tsandmann/ct-bot-hw/v2/boards/README.md

# ct-Bot v2 prototype boards

These boards (mainboard, teensy mcu board, and sensor boards) are ***prototypes*** just for ***development and testing***. They are provided "as is" without warranty of any kind.

## Known issues and notes

Please note: these problem lists may be highly incomplete, as not all functions have been tested yet!

### [Mainboard](../schematics/mainboard_0.9.2.pdf)

* Positioning of J2 is inappropriate
* TBC
