tsandmann/ct-bot-hw/v2/cad/README.md

# c't-Bot CAD-Files

Die Chassis Teile des c't-Bots können auf einem 3D-Drucker gedruckt werden.

Benötigt werden dazu die Dateien aus dem CAD Ordner, sie wurden mit [OpenSCAD](https://www.openscad.org) erstellt.

Dieses Repository enthält die Modelle mit kleineren Anpassungen für den c't-Bot v2. Die Modelle für den originalen c't-Bot (v1) sind [hier](https://github.com/robotfreak/ct-bot/tree/master/CAD) verfügbar.

## OpenSCAD Module c't-Bot v2

* `base()`: untere Trägerplatte
* `motormount()`: Motorhalterung
* `pole()`: Pfosten
* `wheel()`: Räder
* `enc()`: Encoderscheiben für Räder
* `ctbot()`: Komplettansicht, nur zur Darstellung

### Druckeinstellungen

* 0.2 mm Schichthöhe
* 100 % Infill

## Weitere benötigte Bauteile

* 2 x O-Ringe 5mm, 46mm Innendurchmesser, 56mm Außendurchmesser
* 1 x Stützrad
* 2 x Original Motoren Faulhaber

Die CAD Dateien unterliegen der [CC BY-SA Lizenz](https://creativecommons.org/licenses/by-sa/4.0/deed.de).

License: CC BY-SA 4.0 (https://creativecommons.org/licenses/by-sa/4.0/)
