tsandmann/ct-bot-hw/v2/adapter_boards/motor_driver_adapter.pdf

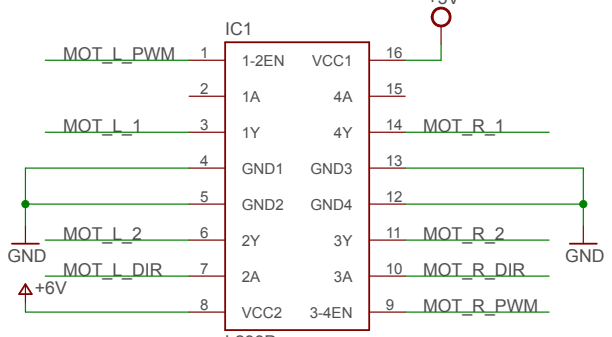
[picture p1: figure]
GND; GND1 4; GND2 5; VCC2 8; VCC1; GND3; GND4; MOT_R_DIR; MOT_L_DIR; MOT_L_PWM; MOT_R_PWM; MOT_L_1; MOT_L_2; MOT_R_1; MOT_R_2

### DRV8835

+5V

### GND

+6V

### GND

L293D

+5V

LGND LGND
VCC VCC
BENBL BENBL
BPHASE BPHASE
AENBL AENBL
APHASE APHASE
MODE MODE | VMM | VMM AOUT1 | AOUT1 AOUT2 | AOUT2 BOUT1 | BOUT1 BOUT2 | BOUT2 VIN | VIN MGND | MGND

IC2

### MOT_R_DIR

### MOT_L_DIR

### MOT_L_PWM

### MOT_R_PWM

### MOT_L_1

### MOT_L_2

### MOT_R_1

### MOT_R_2
