tsandmann/ct-bot-hw/v2/infos/teensy/teensy_4.1_pin_mapping_0.9.2.pdf

## ct-Bot Teensy 4.1 Pin Mapping

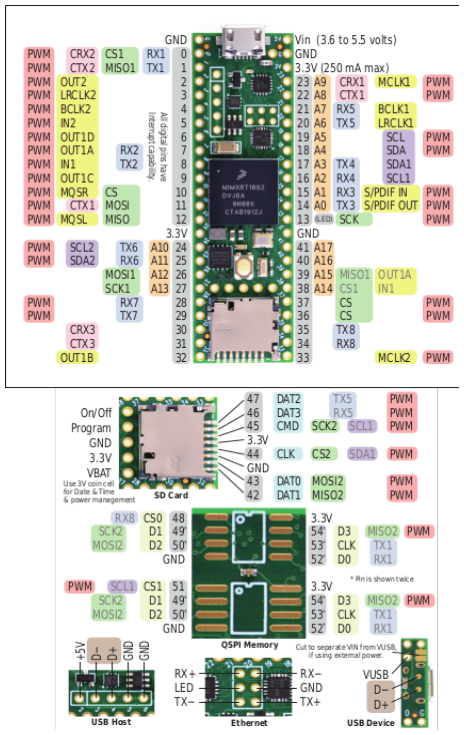
[picture p2: figure]

Pin | | Funktion Teensy 4.1 | Verwendung Teensy 4.1 | neu | optional | Pad Name
0 1 | UART/SPI/PWM UART/SPI/PWM | RX1/CS1/PWM (F: 1.1) TX1/MISO1/PWM (F: 1.0) | SPI 2 Slave CS 1 oder UART 3 SPI 2 Slave MOSI (SIN) oder UART 3 | x x | x x | GPIO_AD_B0_03 GPIO_AD_B0_02
2 3 4 | I2S/PWM I2S/PWM I2S/PWM | OUT2/PWM (F: 4.2) LRCLK2/PWM (F: 4.2) BCLK2/PWM (F: 2.0) | I2S Out I2S LRCLK I2S BCLK | x x x | x x x | GPIO_EMC_04 GPIO_EMC_05 GPIO_EMC_06
5 6 | PWM I2S/PWM | PWM (F: 2.1) OUT1D/PWM (F: 2.2) | Servo 1 PWM Servo 2 PWM | x | x x | GPIO_EMC_08 GPIO_B0_10
7 8 | UART/I2S/PWM UART/PWM | RX2/OUT1A/PWM (F: 1.3) TX2/PWM (F: 1.3) | Uart 2 (Motor-Ctrl) RX Uart 2 (Motor-Ctrl) TX | x x | | GPIO_B1_01 GPIO_B1_00
9 | I2S/PWM | OUT1C/PWM (F: 2.2) | Debug LED | x | | GPIO_B0_11
10 11 12 13 | SPI/PWM SPI/PWM SPI/PWM SPI/PWM | CS0/PWM (Q: 1.0) MOSI(SOUT)0/PWM (Q: 1.2) MISO(SIN)0/PWM (Q: 1.1) SCK0/PWM (Q: 2.0) | SPI 1 Master CS 1 SPI 1 Master MOSI SPI 1 Master MISO SPI 1 Master SCK | x x x x | x x x x | GPIO_B0_00 GPIO_B0_02 GPIO_B0_01 GPIO_B0_03
14 15 | ADC/UART/PWM ADC/UART/PWM | A0/TX3/PWM (Q: 3.2) A1/RX3/PWM (Q: 3.3) | Strommessung 5V Strommessung Servos | x x | | GPIO_AD_B1_02 GPIO_AD_B1_03
16 17 | ADC/UART/I2C ADC/UART/I2C | A2/RX4/SCL1 A3/TX4/SDA1 | I2C 2 (IMU) I2C 2 (IMU) | x x | x x | GPIO_AD_B1_07 GPIO_AD_B1_06
18 19 | ADC/I2C/PWM ADC/I2C/PWM | A4/SDA0/PWM (Q: 3.1) A5/SCL0/PWM (Q: 3.0) | I2C 1 (5V: LEDs, ENA, CNY70, Sens) I2C 1 (5V: LEDs, ENA, CNY70, Sens) | x x | | GPIO_AD_B1_01 GPIO_AD_B1_00
20 21 22 23 | ADC/UART/I2S ADC/UART/I2S ADC/PWM ADC/I2S/PWM | A6/TX5/LRCLK1 A7/RX5/BCLK1 A8/PWM (F: 4.0) A9/MCLK1/PWM (F: 4.1) | Überwachung Batterie Servo 1 Feedback Servo 2 Feedback Servo 3 Feedback | x x x x | x x x | GPIO_AD_B1_10 GPIO_AD_B1_11 GPIO_AD_B1_08 GPIO_AD_B1_09
24 25 | ADC/I2C/UART ADC/I2C/UART | A10/TX6/SCL2/PWM (F: 1.2) A11/RX6/SDA2/PWM (F: 1.3) | I2C 3 oder Uart 4 I2C 3 oder Uart 4 | x x | x x | GPIO_AD_B0_12 GPIO_AD_B0_13
26 27 | ADC/SPI ADC/SPI | A12/MOSI(SOUT) A13/SCK1 | SPI 2 Slave MISO (SOUT) SPI 2 Slave SCK | x x | x x | GPIO_AD_B1_14 GPIO_AD_B1_15
28 29 | UART/PWM UART/PWM | RX7/PWM (F: 3.1) TX7/PWM (F: 3.1) | Servo 3 PWM Servo 4 PWM | x x | x x | GPIO_EMC_32 GPIO_EMC_31
30 31 | | GPIO30 GPIO31 | Fernbedienung BPS Sensor | | x | GPIO_EMC_37 GPIO_EMC_36
32 33 | I2S PWM | OUT1B/GPIO32 PWM (F: 2.0) | GPIO_1 GPIO_2 | x x | x x | GPIO_B0_12 GPIO_EMC_07
34 35 | UART UART | RX8 TX8 | Uart 1 (WiFi) RX Uart 1 (WiFi) TX | | | GPIO_B1_13 GPIO_B1_12
36 37 | SPI/PWM SPI/PWM | CS0/PWM (F: 2.3) CS0/PWM (F: 2.3) | SPI 1 Master CS 2 SPI 1 Master CS 3 | x x | x x | GPIO_B1_02 GPIO_B1_03
38 39 40 41 | ADC ADC ADC ADC | A14/CS1 A15/MISO(SIN)1/OUT1A A16 A17 | Kantensensor L Kantensensor R Liniensensor R Liniensensor L | | | GPIO_AD_B1_12 GPIO_AD_B1_13 GPIO_AD_B1_04 GPIO_AD_B1_05
D+ D- | USB USB | USB2_DP USB2_DN | USB Host USB Host | x x | x x
Vb | | VBat | n/a | | | VDD_SNVS_IN
R | | On/Off | On_Off | x | x | ONOFF

Anmerkungen

This work (excluding the teensy images) is licensed under the Creative Commons Attribution-ShareAlike 4.0 International License. To view a copy of this license, visit http://creativecommons.org/licenses/by-sa/4.0

- Distanzsensoren über I2C (z.B. VL53L0X)
- Transportfachüberwachung über I2C (z.B. VL6180X)

Sources: https://www.pjrc.com/store/teensy41_card11a_rev3.png;https://www.pjrc.com/store/teensy41_card11b_rev4.png
