tsandmann/ct-bot-hw/v1/schematics/06_bluemp3_serial_isp.pdf

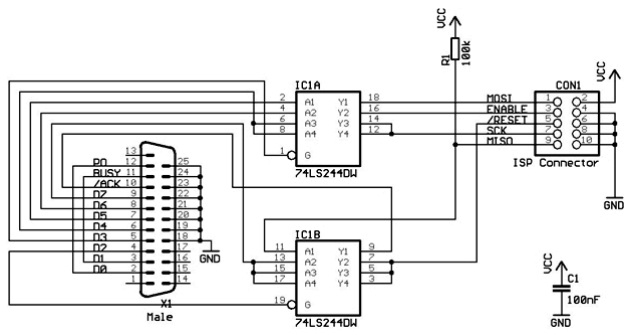
[picture p3: figure]
