tsandmann/ct-bot-hw/v1/pcb-layout/03_pcb_sensorboard_mouse.pdf

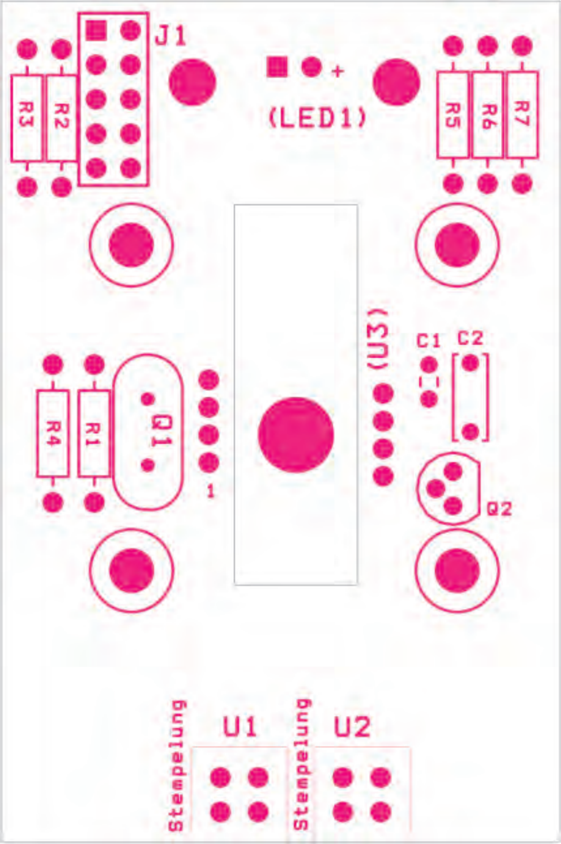
[picture p4: page 1]
