tsandmann/ct-bot-hw/v1/pcb-layout/06_pcb_bluemp3_serial_isp.pdf

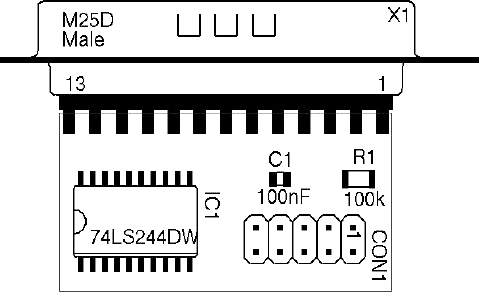
[picture p5: page 1]
