tsandmann/ct-bot-hw/v2/adapter_boards/teensy_adapter_v2/pcb/teensy_adapter_gerber_top.png

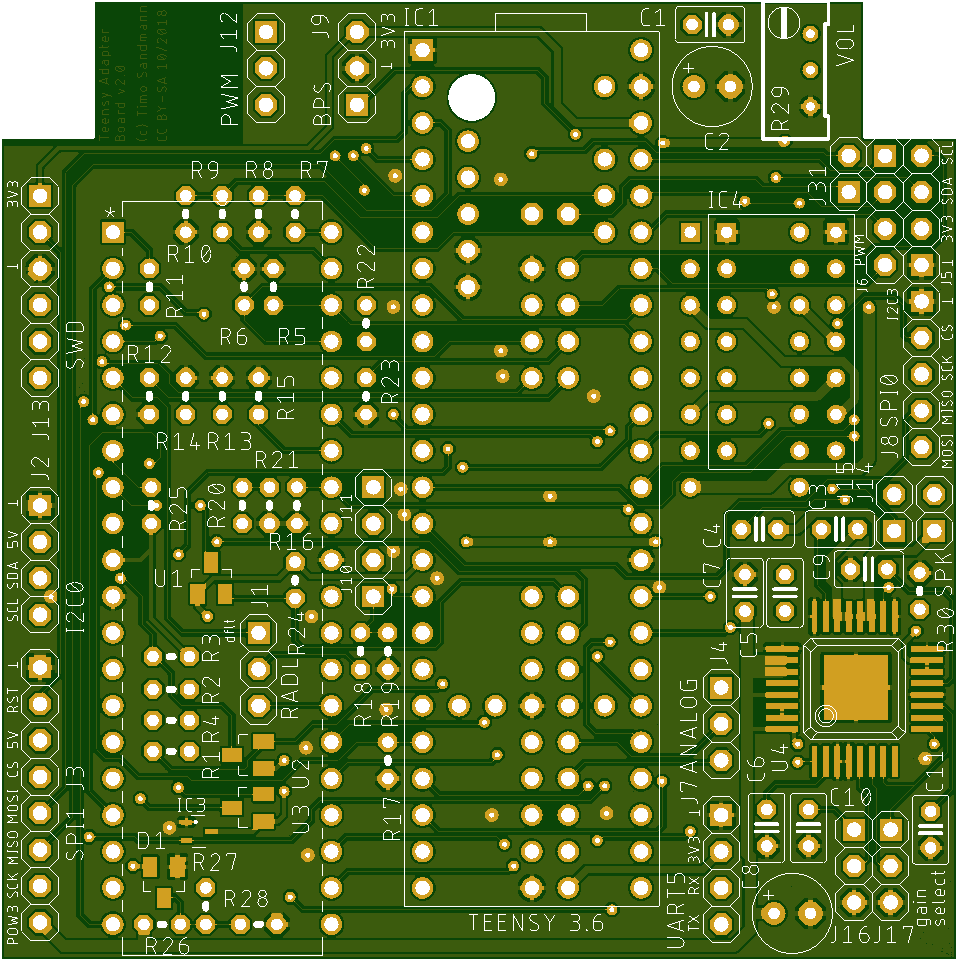
v2/adapter_boards/teensy_adapter_v2/pcb/teensy_adapter_gerber_top.png
