tsandmann/ct-bot-hw/v2/boards/display_adapter_1.3.png

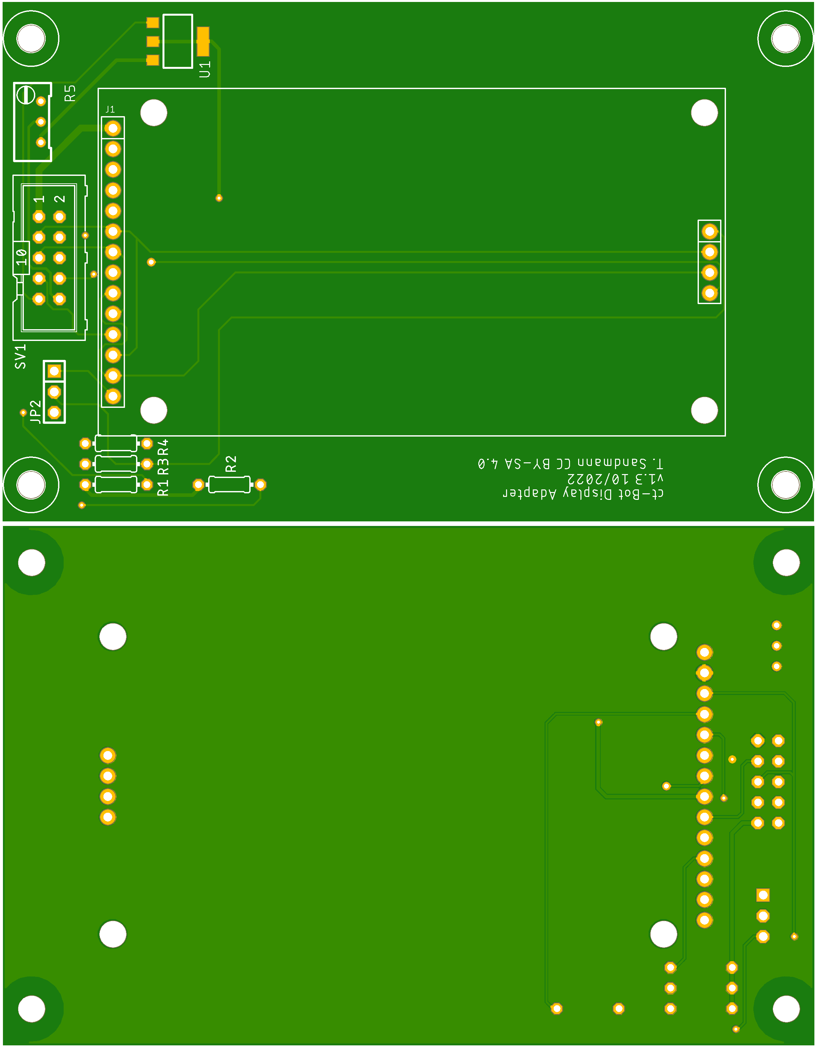
v2/boards/display_adapter_1.3.png
