tsandmann/ct-bot-hw/v2/boards/mainboard_0.9.2.png

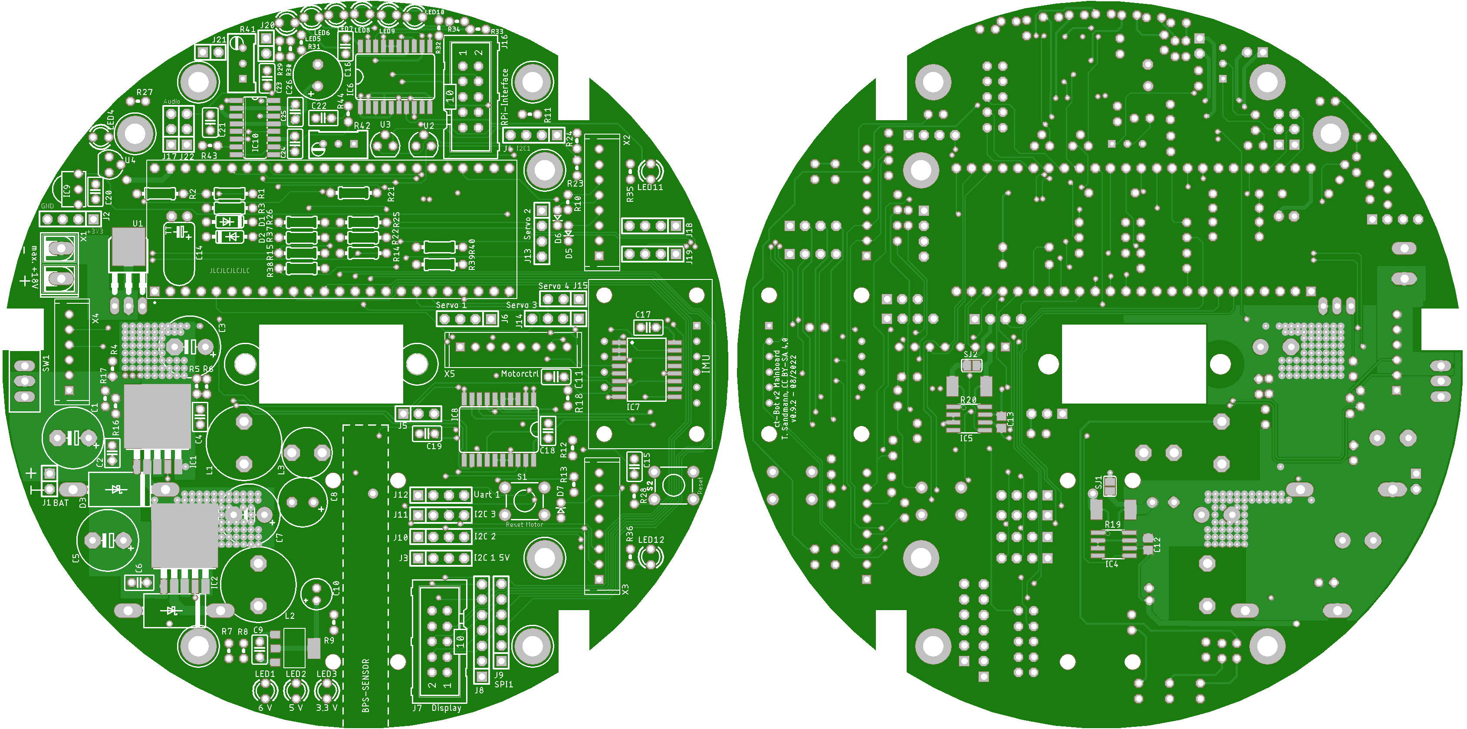
v2/boards/mainboard_0.9.2.png
