tsandmann/ct-bot-hw/v2/boards/mcu_teensy4.1_0.9.2.png

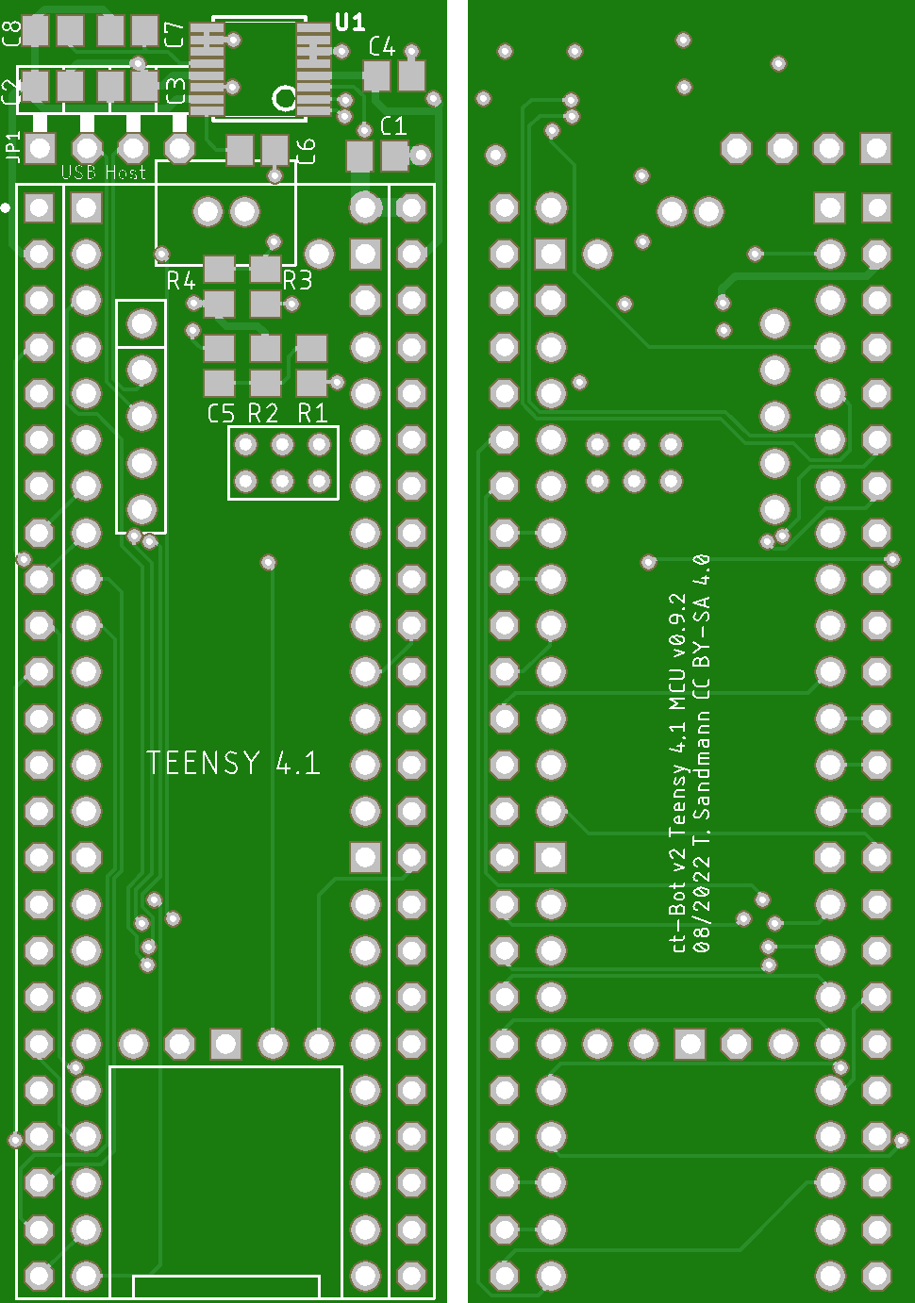
v2/boards/mcu_teensy4.1_0.9.2.png
