tsandmann/ct-bot-hw/v2/boards/motorctrl_0.5.png

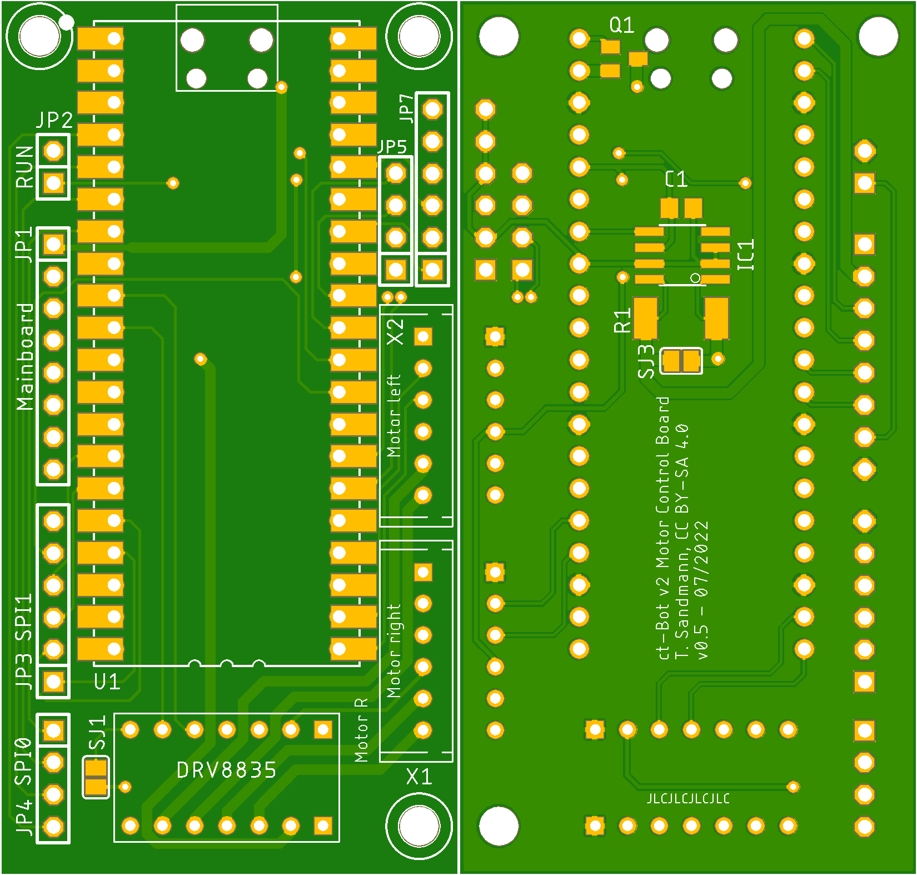
v2/boards/motorctrl_0.5.png
