tsandmann/ct-bot-hw/v2/boards/sensors_b_0.9.2.png

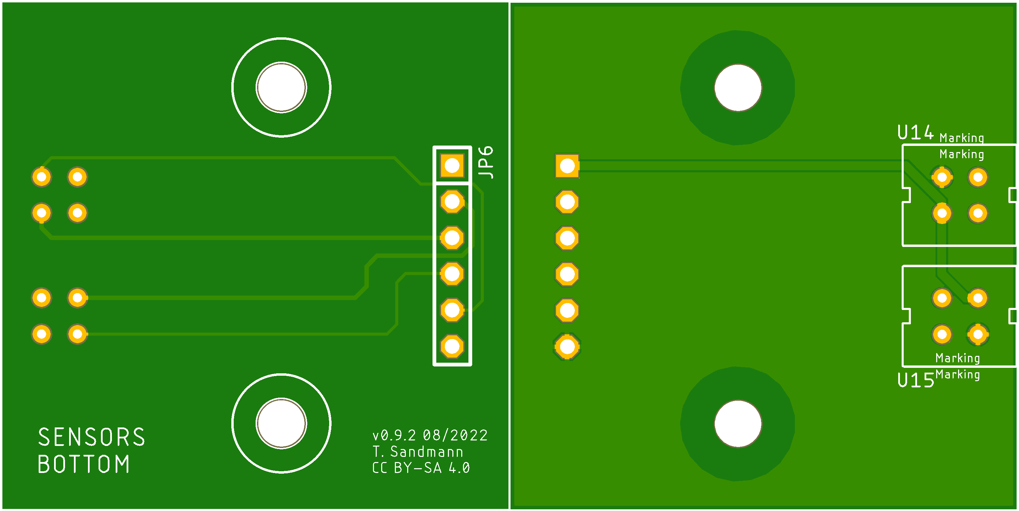
v2/boards/sensors_b_0.9.2.png
