tsandmann/ct-bot-hw/v2/datasheets/pololu_micro_metal_gearmotor_bracket.jpg

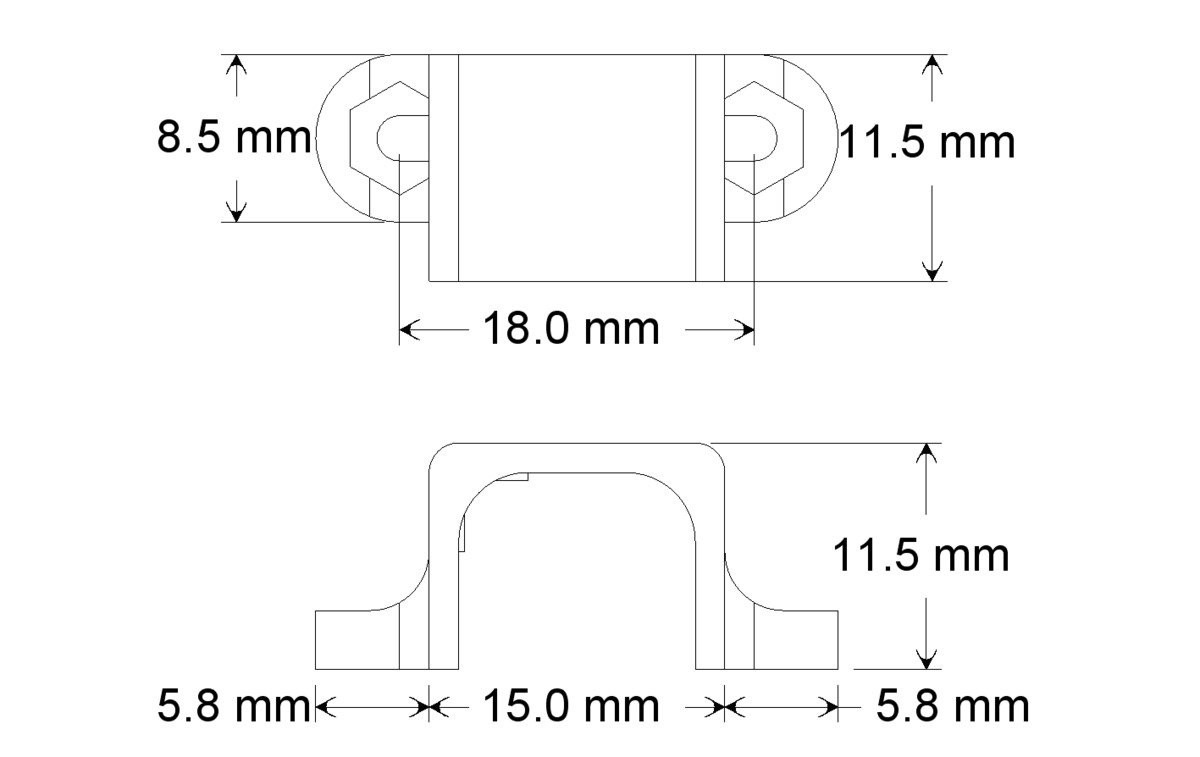
v2/datasheets/pololu_micro_metal_gearmotor_bracket.jpg
