tsandmann/ct-bot-hw/v2/infos/teensy/teensy_3.5_3.6_schematic.jpg

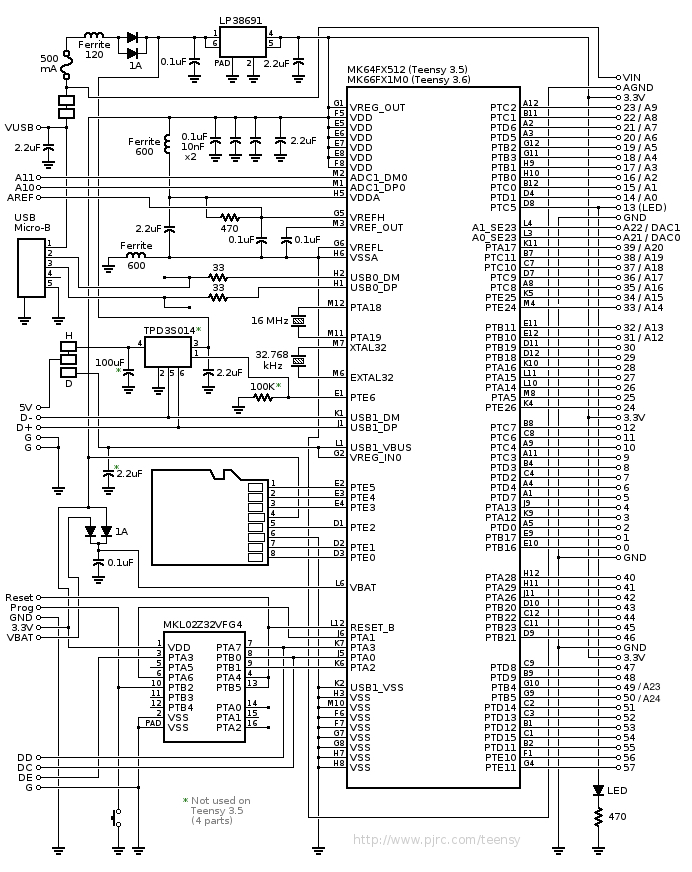
v2/infos/teensy/teensy_3.5_3.6_schematic.jpg
