tsandmann/ct-bot-hw/v2/cad/bms345.stl

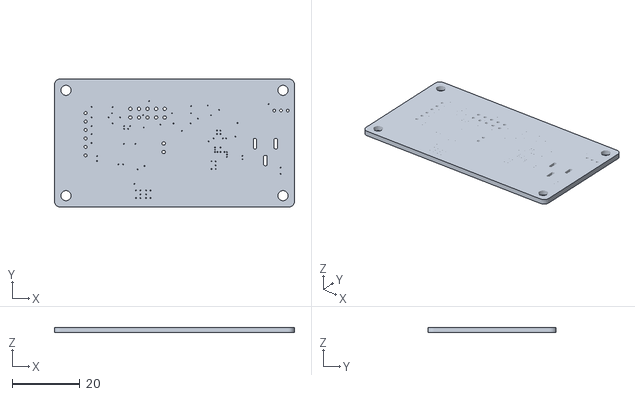
[picture p18: CAD file, 2023-01-01]
v2/cad/bms345.stl
71.0 x 38.0 x 1.60
