tsandmann/ct-bot-hw/v2/cad/ct-bot_v2_wheel.stl

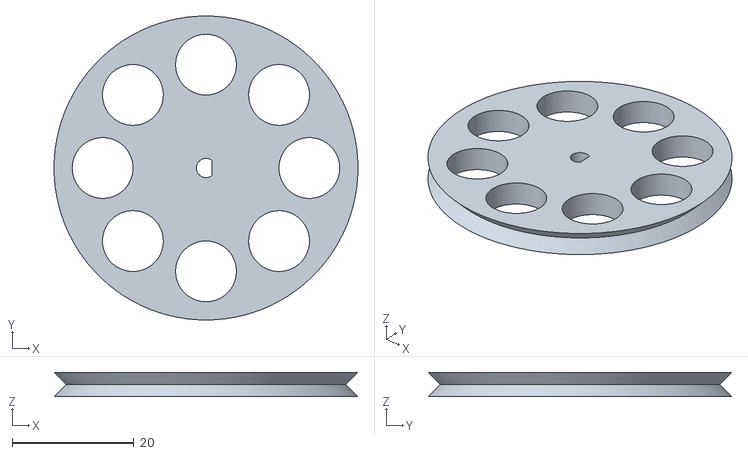
[picture p19: CAD file, 2023-01-01]
v2/cad/ct-bot_v2_wheel.stl
50.0 x 50.0 x 4.00
