tsandmann/ct-bot-hw/v2/cad/motorctrl.stl

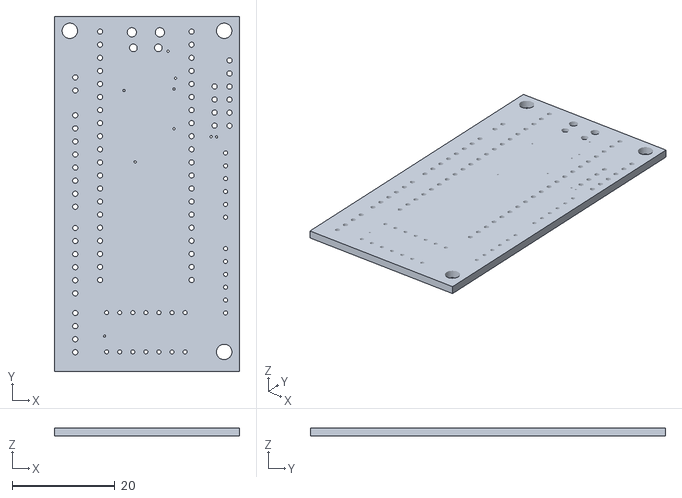
[picture p20: CAD file, 2023-01-01]
v2/cad/motorctrl.stl
36.0 x 69.0 x 1.60
