tsandmann/ct-bot-hw/v2/cad/ct-bot_v2_poles.stl

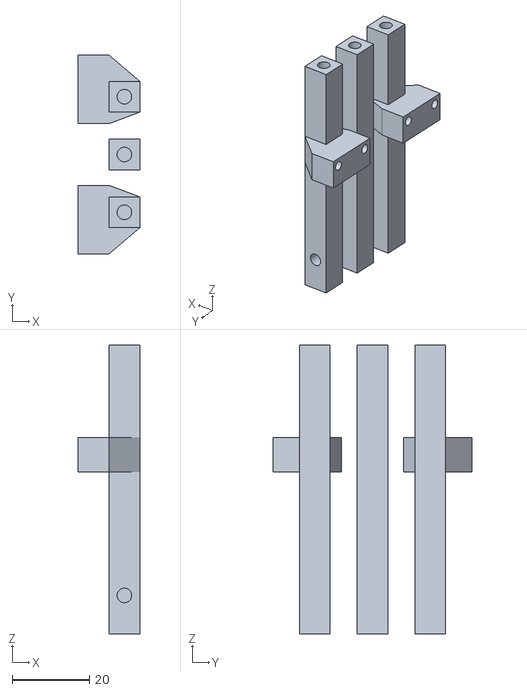
[picture p21: CAD file, 2023-01-01]
v2/cad/ct-bot_v2_poles.stl
16.0 x 51.6 x 75.0
