tsandmann/ct-bot-hw/v2/cad/ct-bot_v2_base.stl

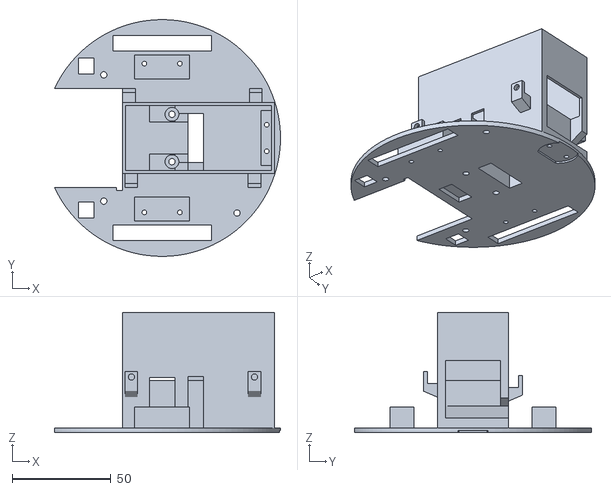
[picture p22: CAD file, 2023-01-01]
v2/cad/ct-bot_v2_base.stl
114.5 x 120.0 x 61.0
