tsandmann/ct-bot-hw/v2/cad/ball-caster.stl

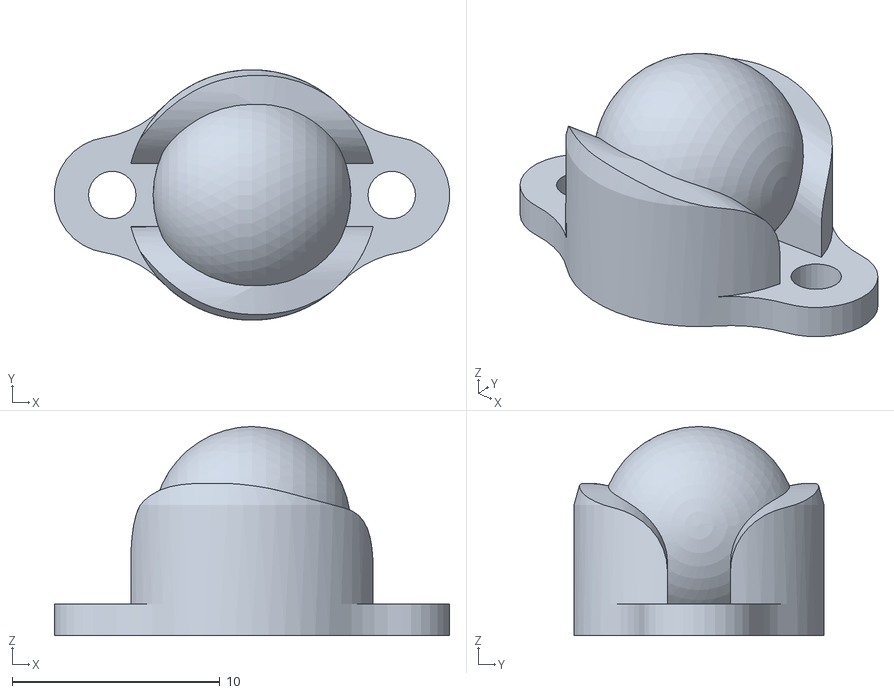
[picture p23: CAD file, 2022-06-25]
v2/cad/ball-caster.stl
19.0 x 12.1 x 10.1
