tsandmann/ct-bot-hw/v2/cad/micro_metal_gearmotor_bracket_fixed.stl

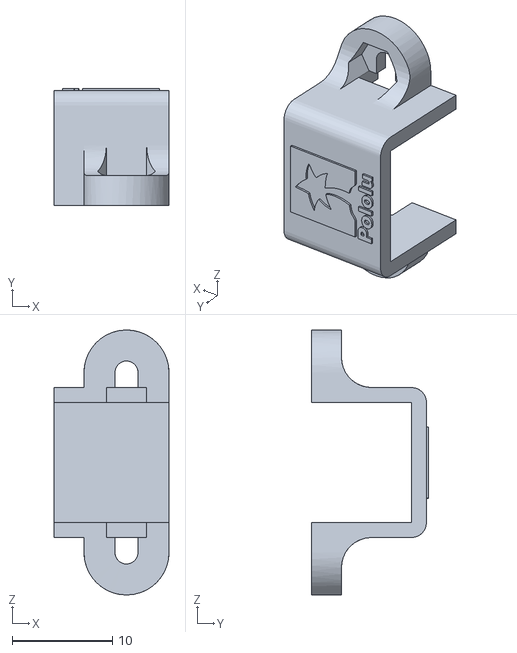
[picture p24: CAD file, 2021-09-04]
v2/cad/micro_metal_gearmotor_bracket_fixed.stl
11.5 x 11.7 x 26.5
