tsandmann/ct-bot-hw/v2/cad/micro-metal-gearmotor-backshaft_fixed.stl

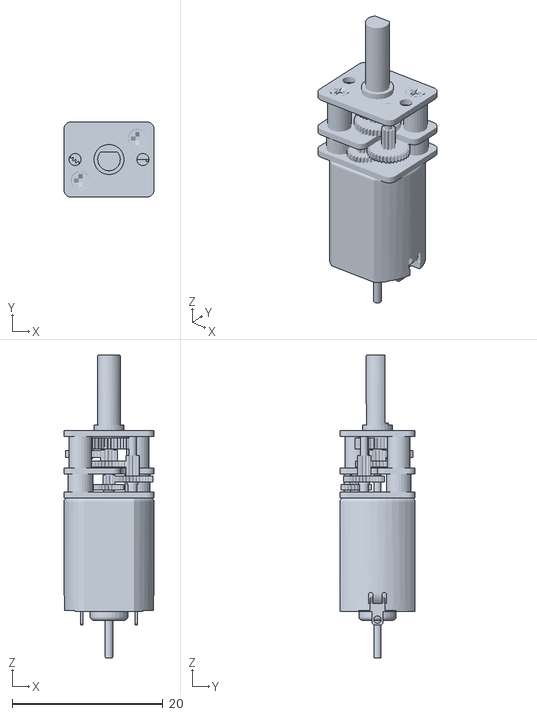
[picture p25: CAD file, 2021-09-04]
v2/cad/micro-metal-gearmotor-backshaft_fixed.stl
12.0 x 10.0 x 40.2
