tsandmann/ct-bot-hw/v2/cad/object.scad

$fn = 500;

difference() {
    cylinder(h = 65, r = 15, center = false);
    translate([0, 0, 1]) cylinder(h = 63, r = 14, center = false);
    // translate([0, 0, 1]) cylinder(h = 65, r = 14, center = false);
}
