tsandmann/ct-bot-hw/(list of files, cad)

Other CAD files:
v2/cad/micro-metal-gearmotor-backshaft.stl
