tsandmann/ct-bot-hw/v2/schematics/display_adapter_1.3.pdf

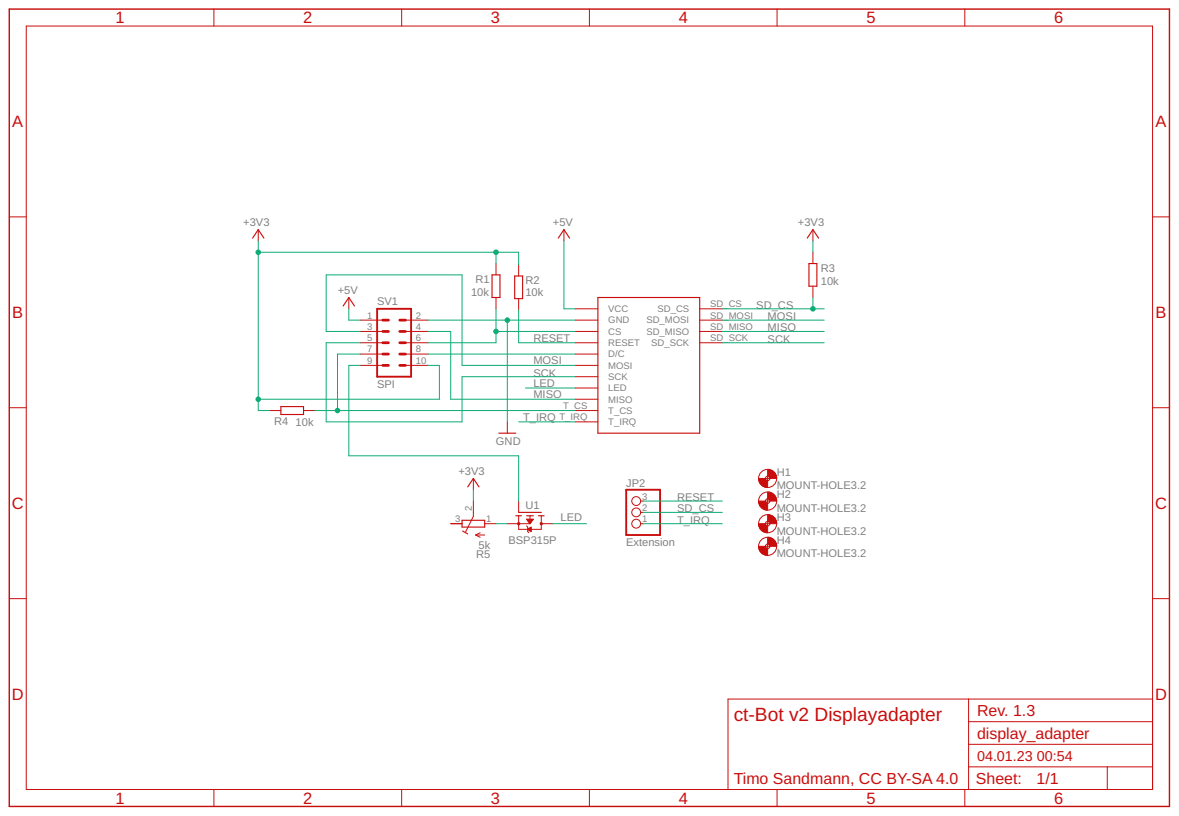
[picture p26: page 1]
