tsandmann/ct-bot-hw/v2/schematics/mainboard_0.9.2.pdf

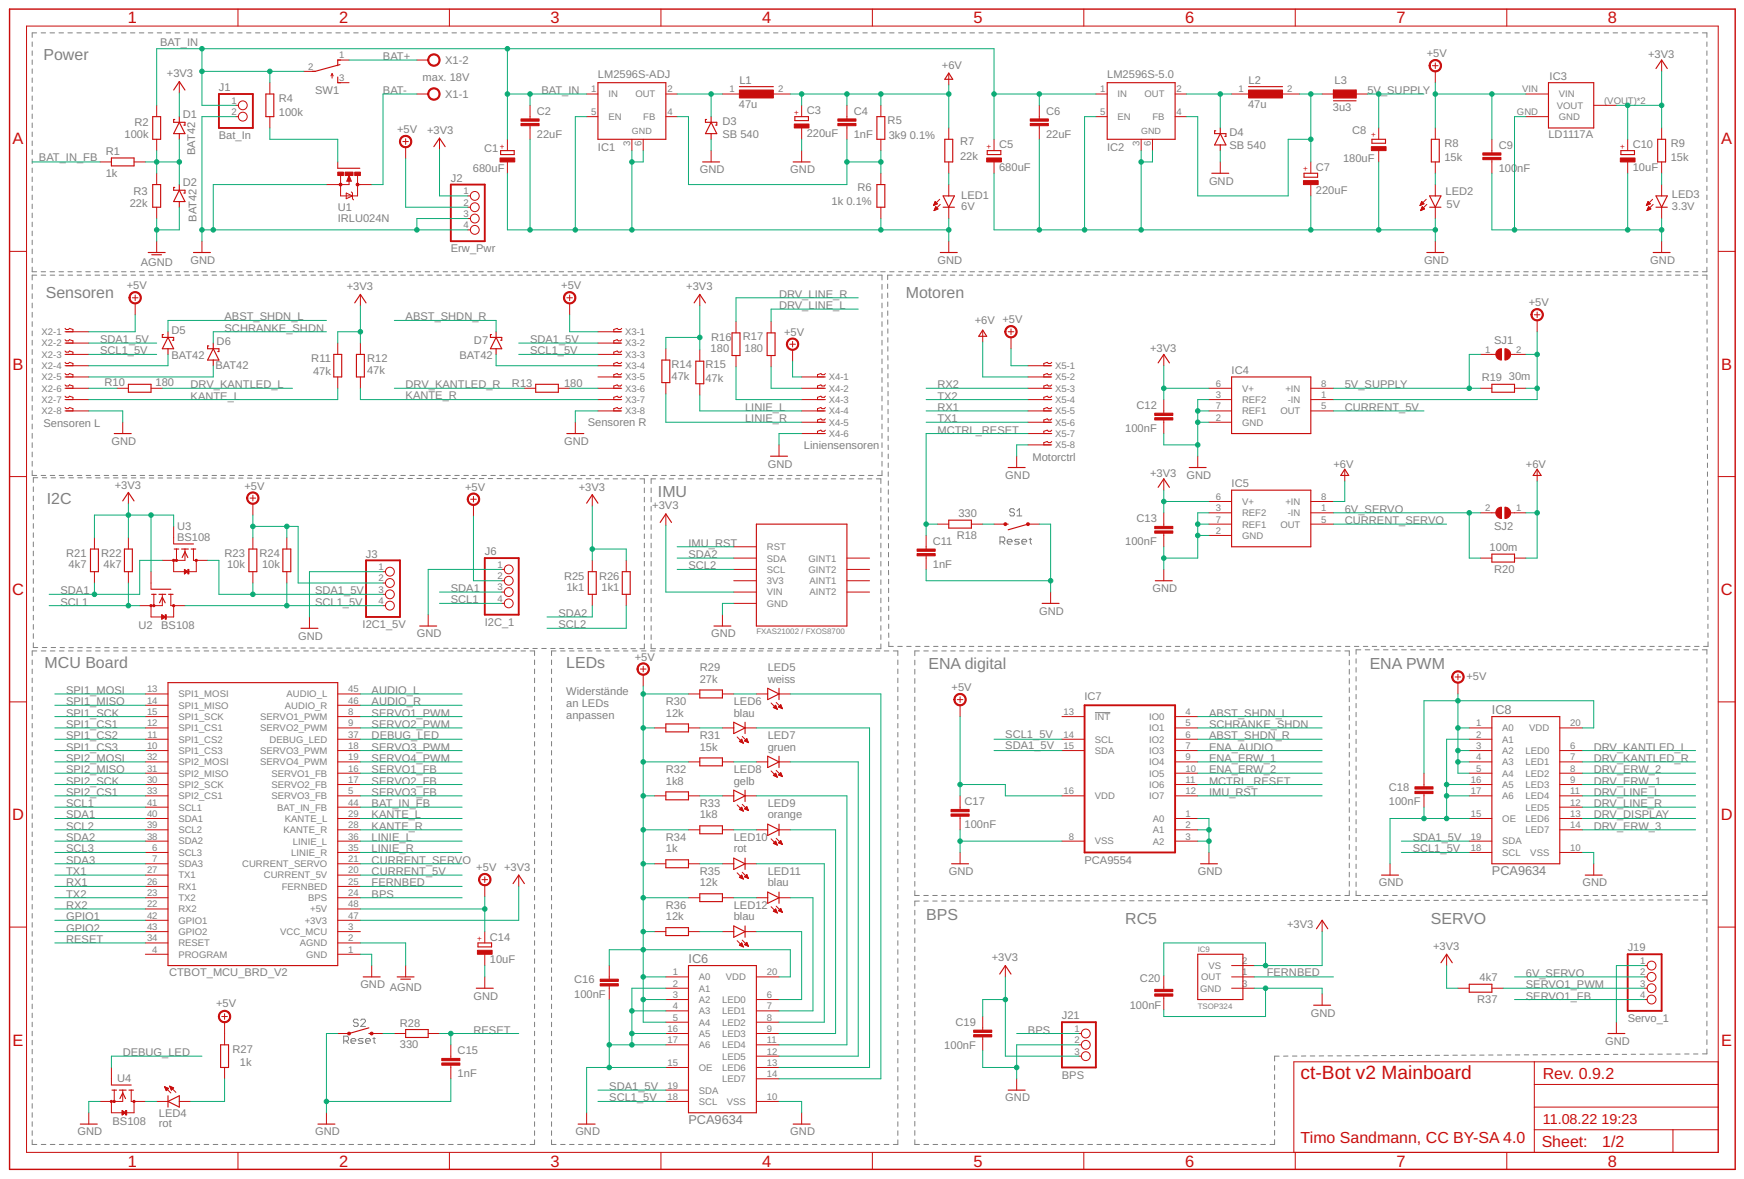
[picture p27: page 1]

Timo Sandmann, CC BY-SA 4.0

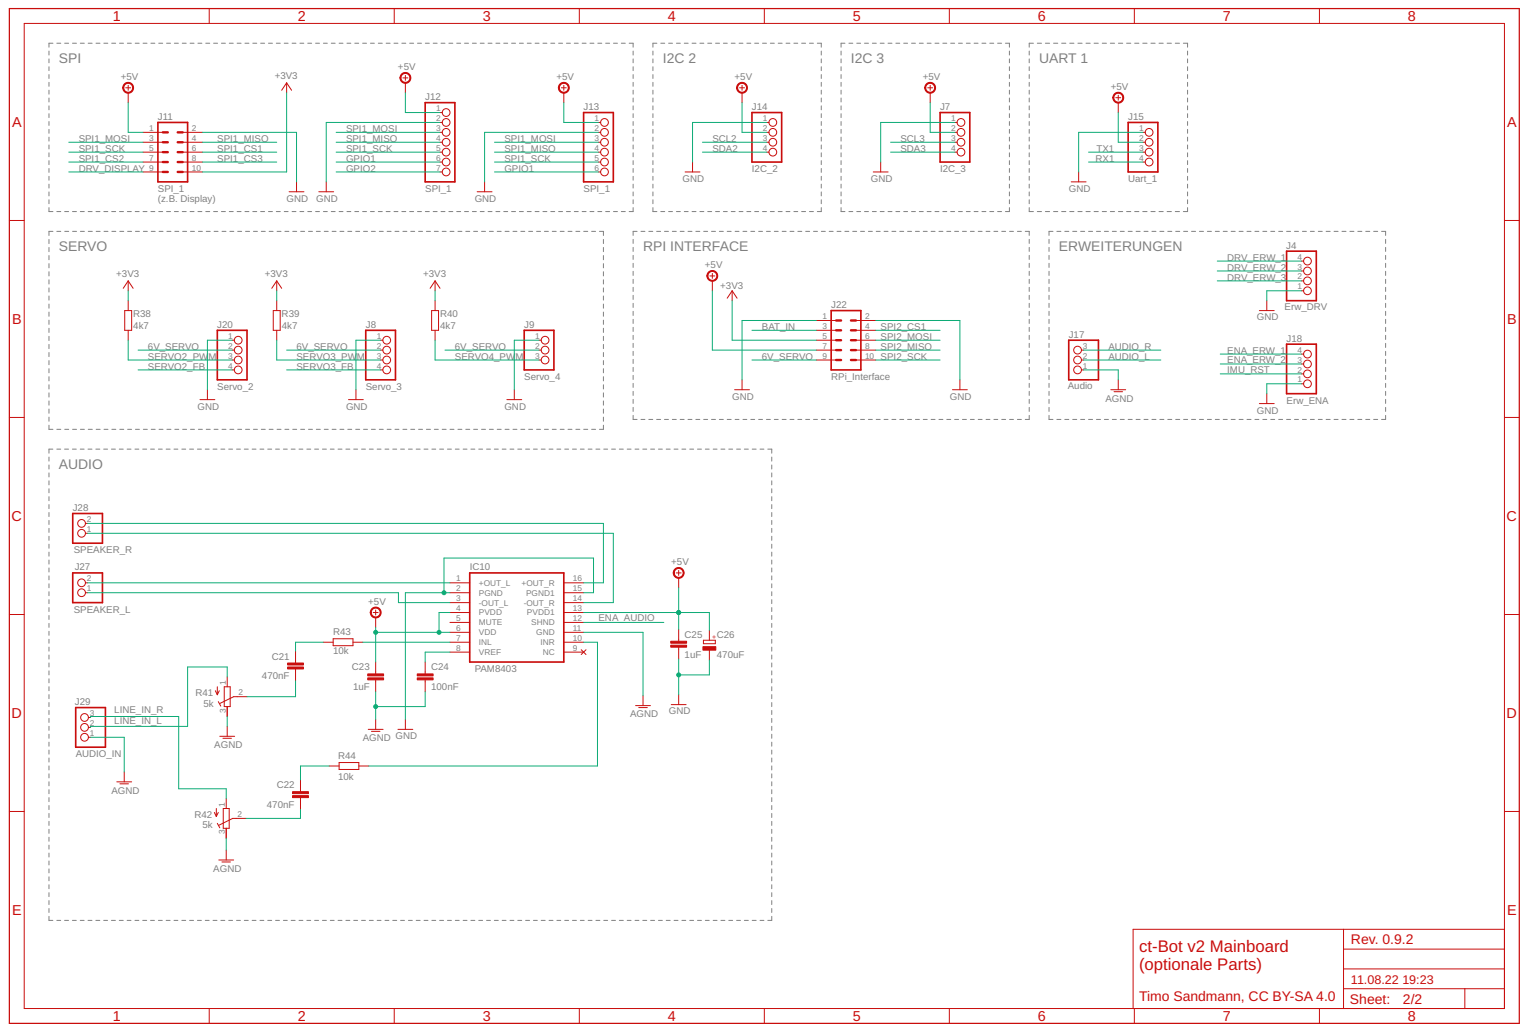
[picture p28: page 2]

Timo Sandmann, CC BY-SA 4.0
