tsandmann/ct-bot-hw/v2/schematics/mcu_teensy4.1_0.9.2.pdf

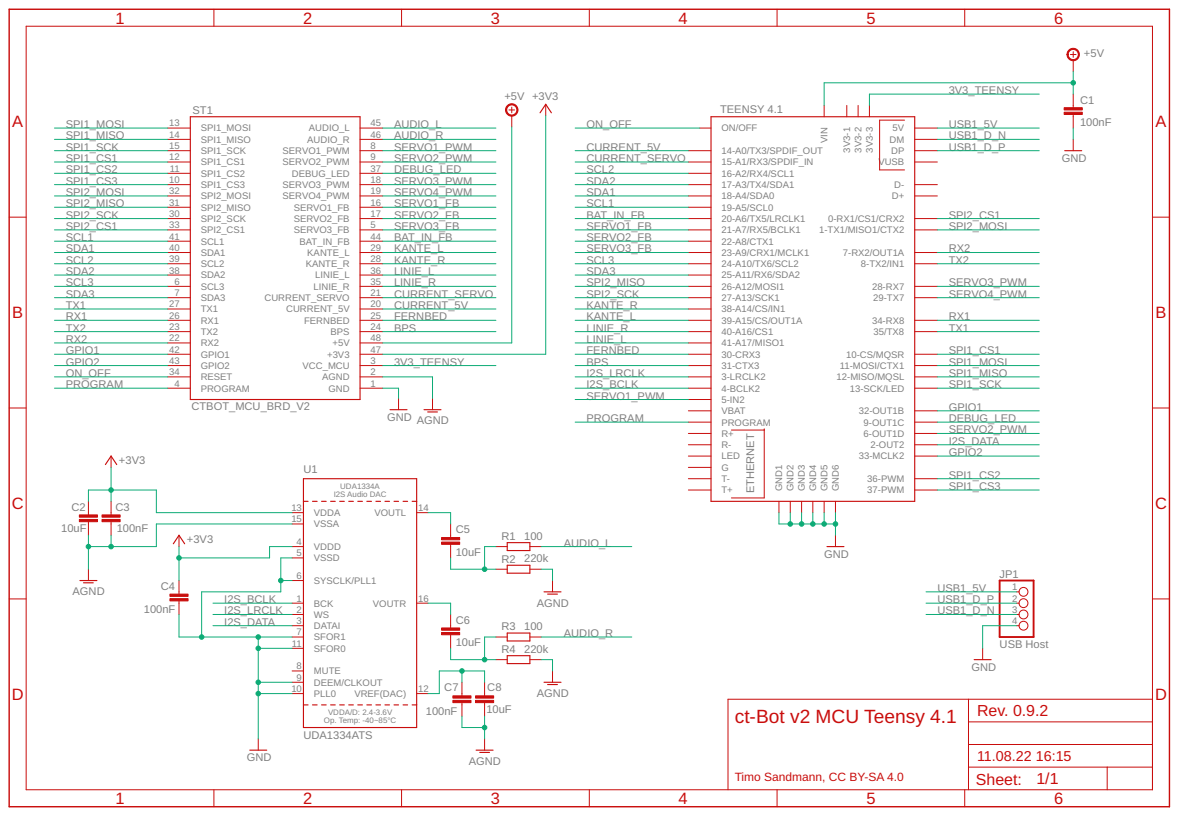
[picture p29: page 1]
