tsandmann/ct-bot-hw/v2/schematics/motorctrl_0.5.pdf

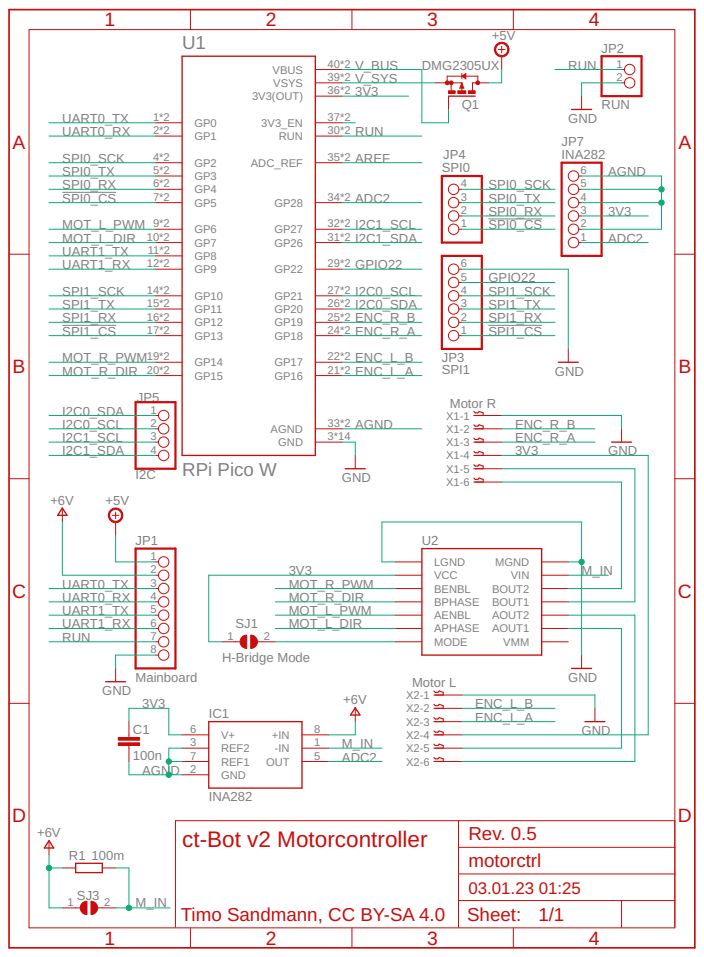
[picture p30: page 1]

Timo Sandmann, CC BY-SA 4.0
