tsandmann/ct-bot-hw/v2/schematics/sensors_bottom_0.9.2.pdf

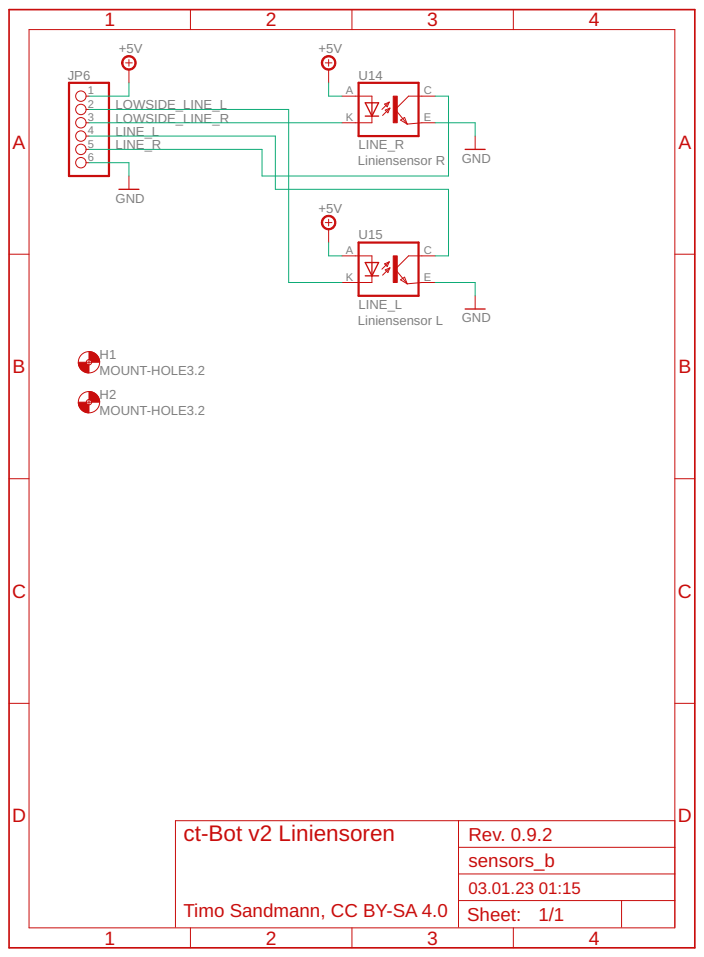
[picture p31: page 1]
