tsandmann/ct-bot-hw/v2/schematics/sensors_front_0.9.2.pdf

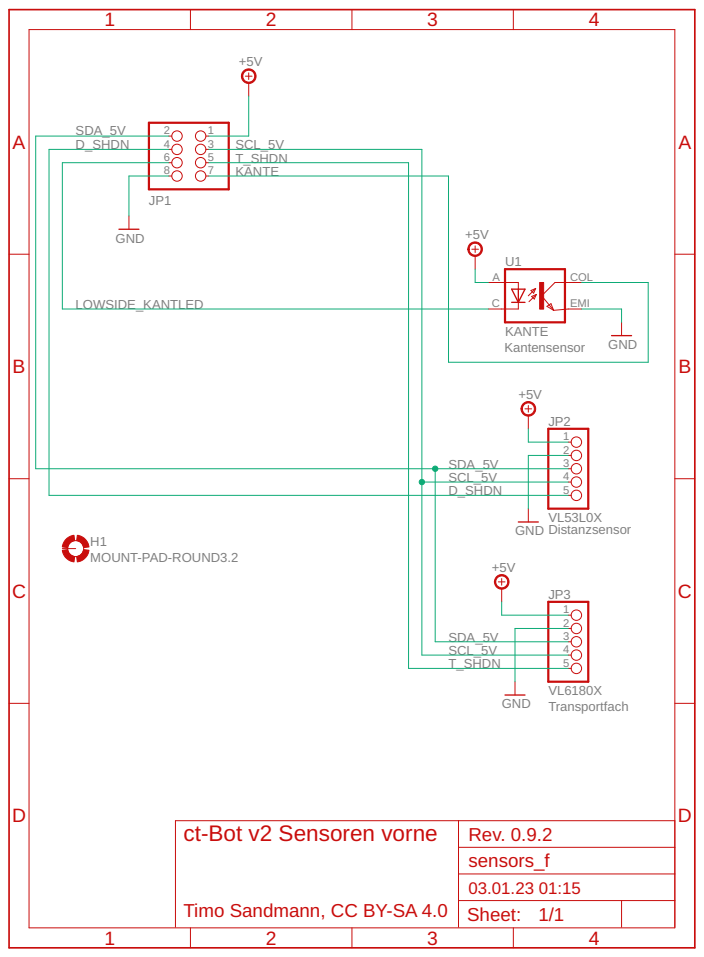
[picture p32: page 1]
