tsandmann/ct-bot-hw/v2/schematics/mcu_teensy.pdf

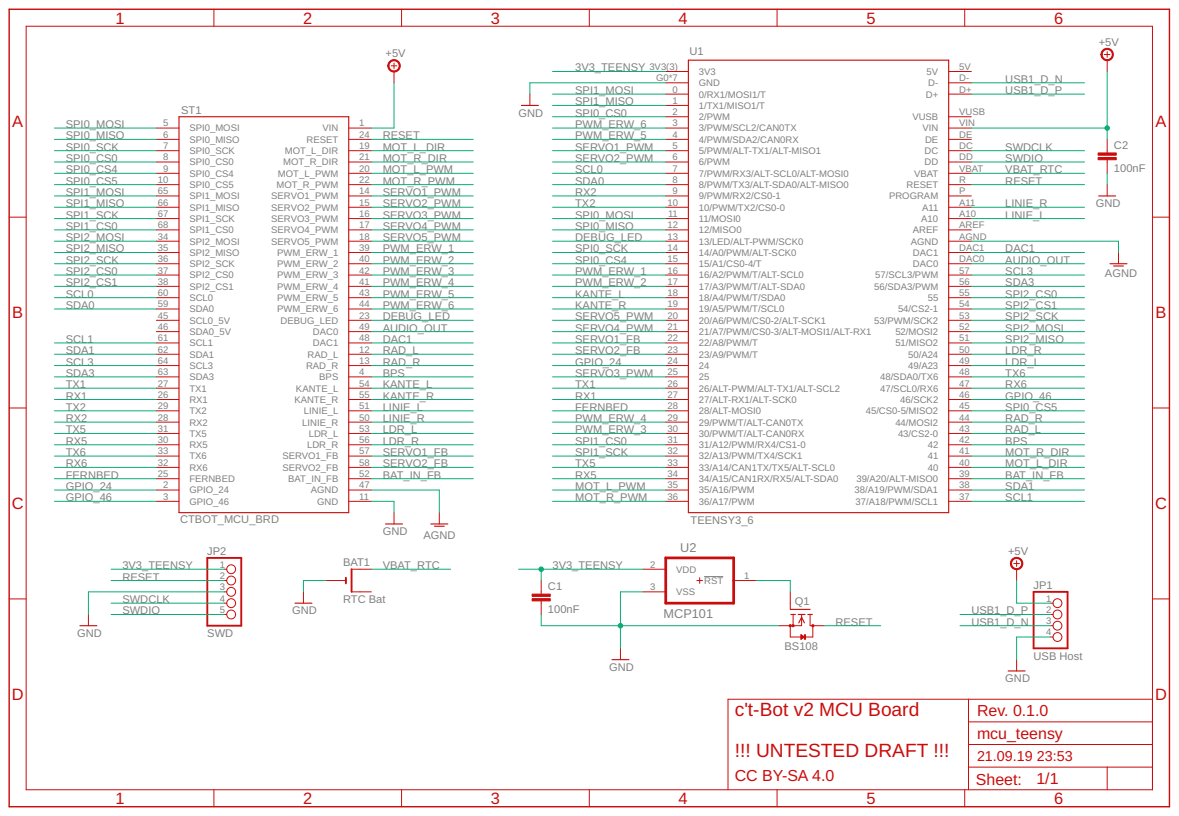
[picture p33: page 1]
