tsandmann/ct-bot-hw/v2/adapter_boards/teensy_adapter_v2/teensy_adapter.pdf

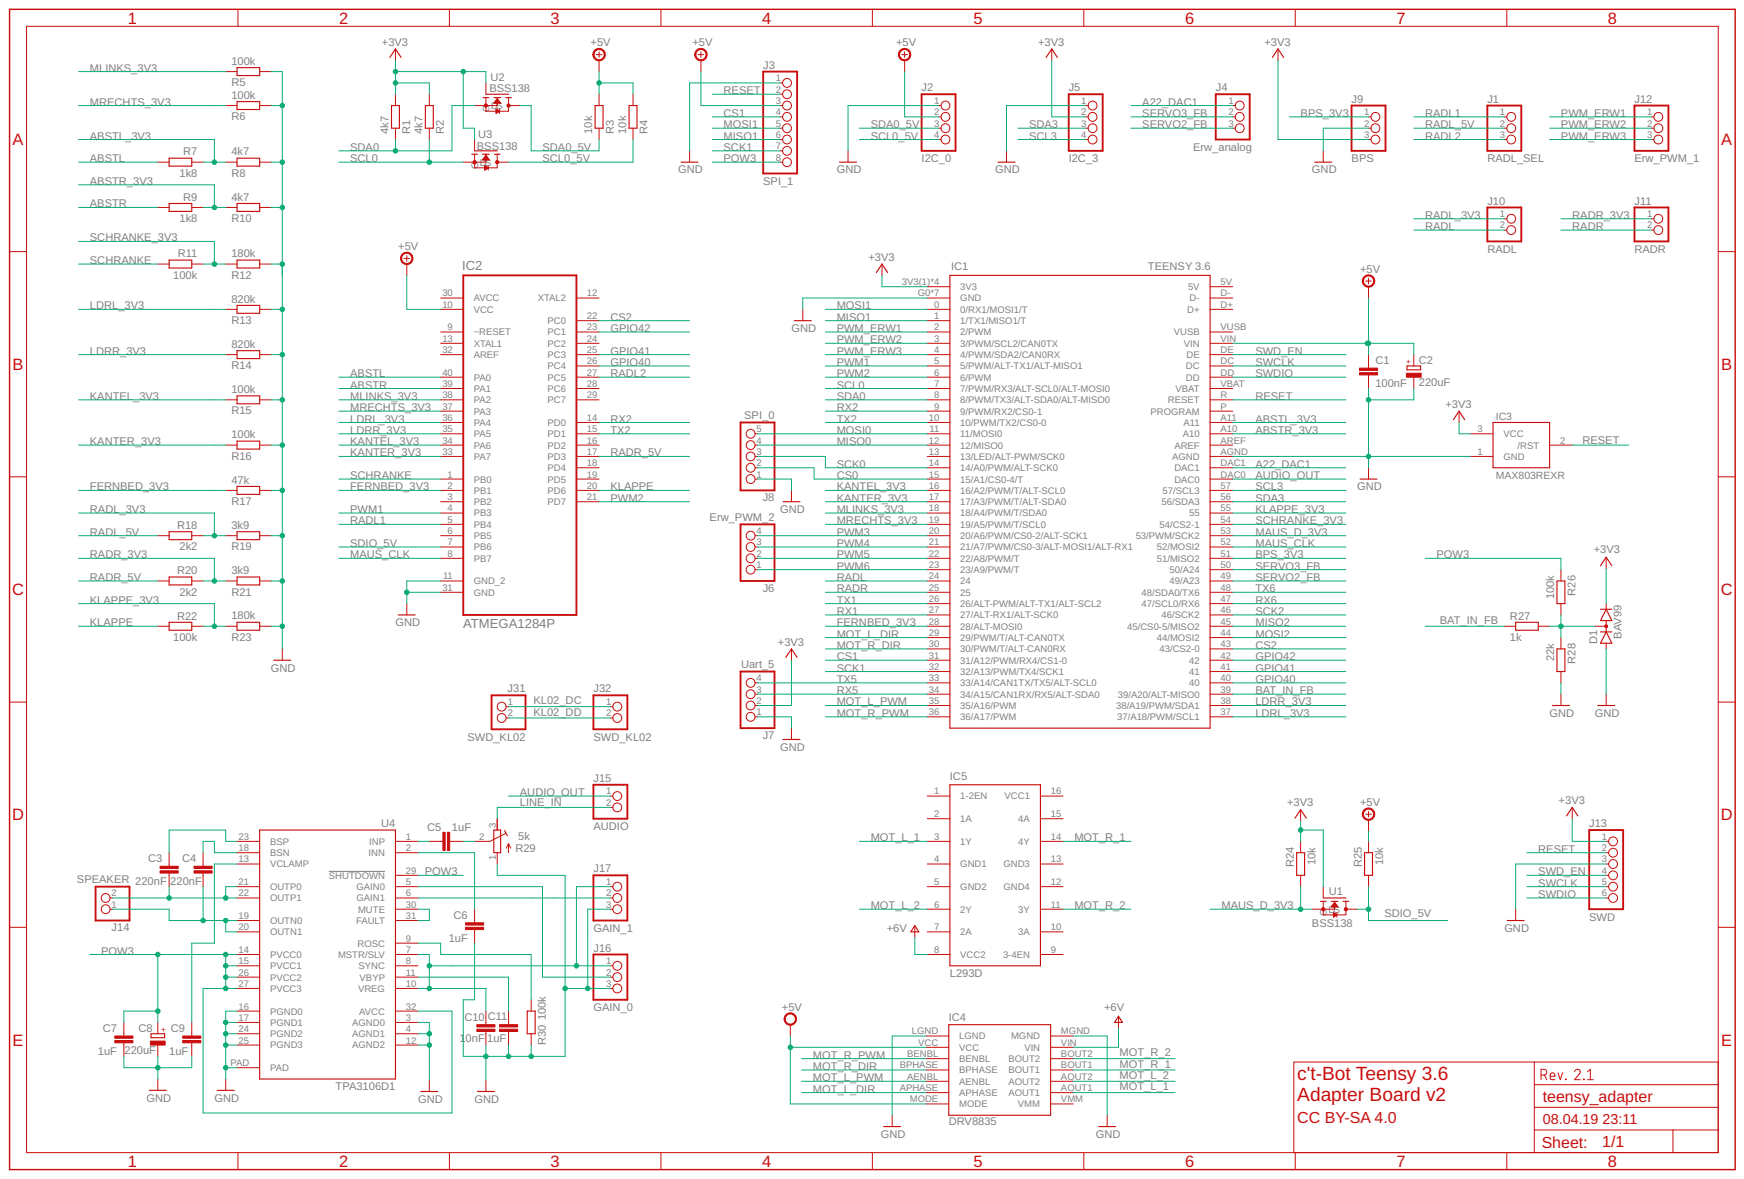
[picture p34: page 1]
