tsandmann/ct-bot-hw/v2/adapter_boards/teensy_adapter_v2/pcb/teensy_adapter_pcb.pdf

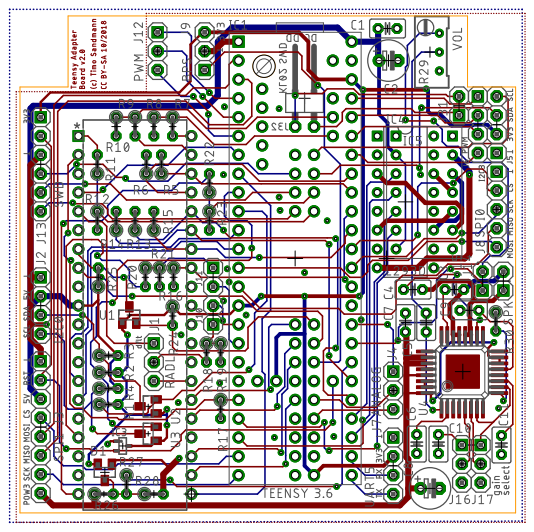
[picture p35: page 1]
