tsandmann/ct-bot-hw/v1/schematics/05_extensionboard.pdf

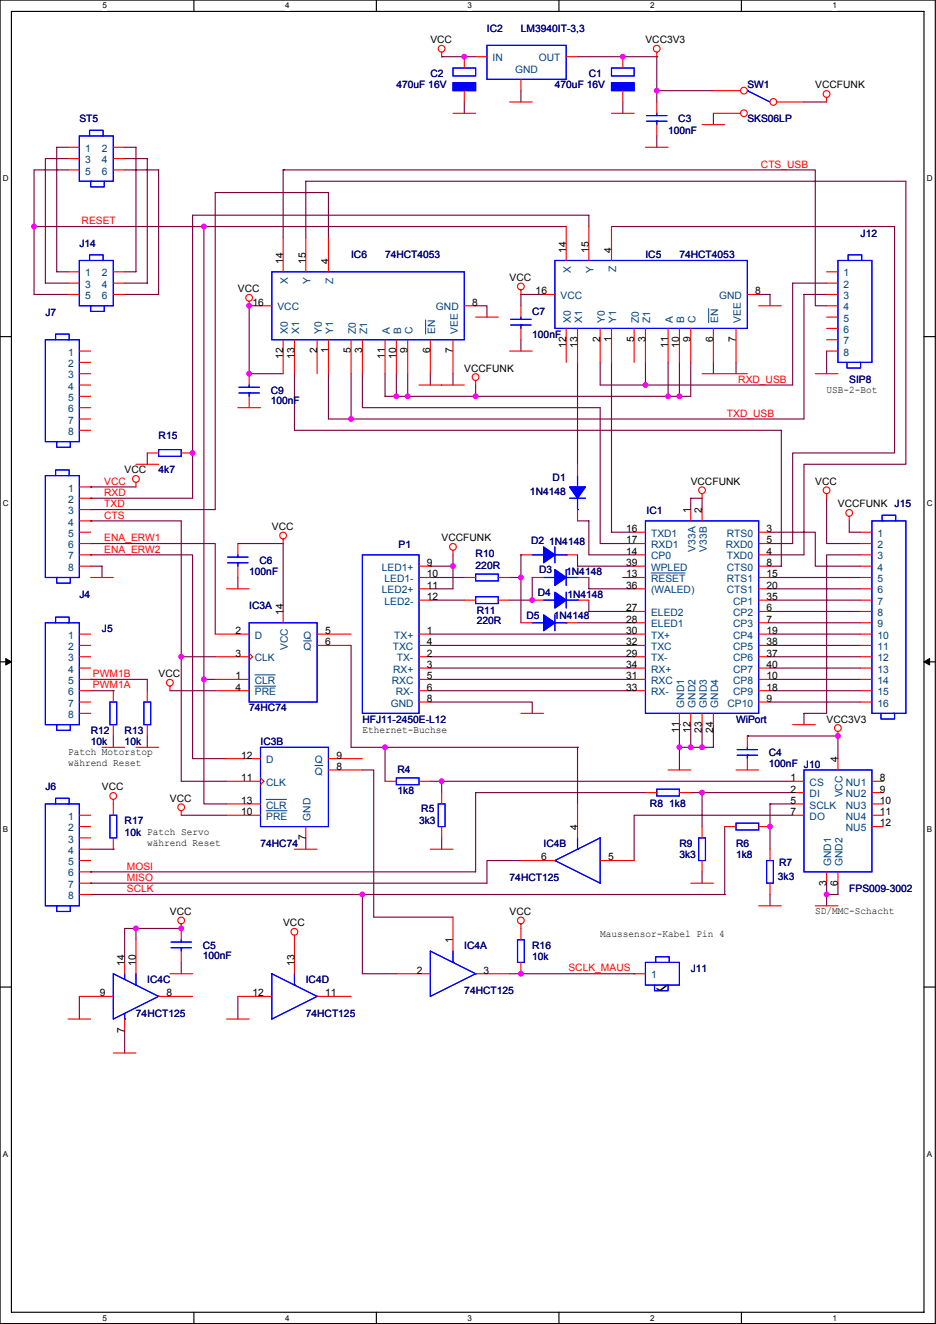
[picture p36: page 1]
