tsandmann/ct-bot-hw/v1/pcb-layout/01_pcb_mainboard.pdf

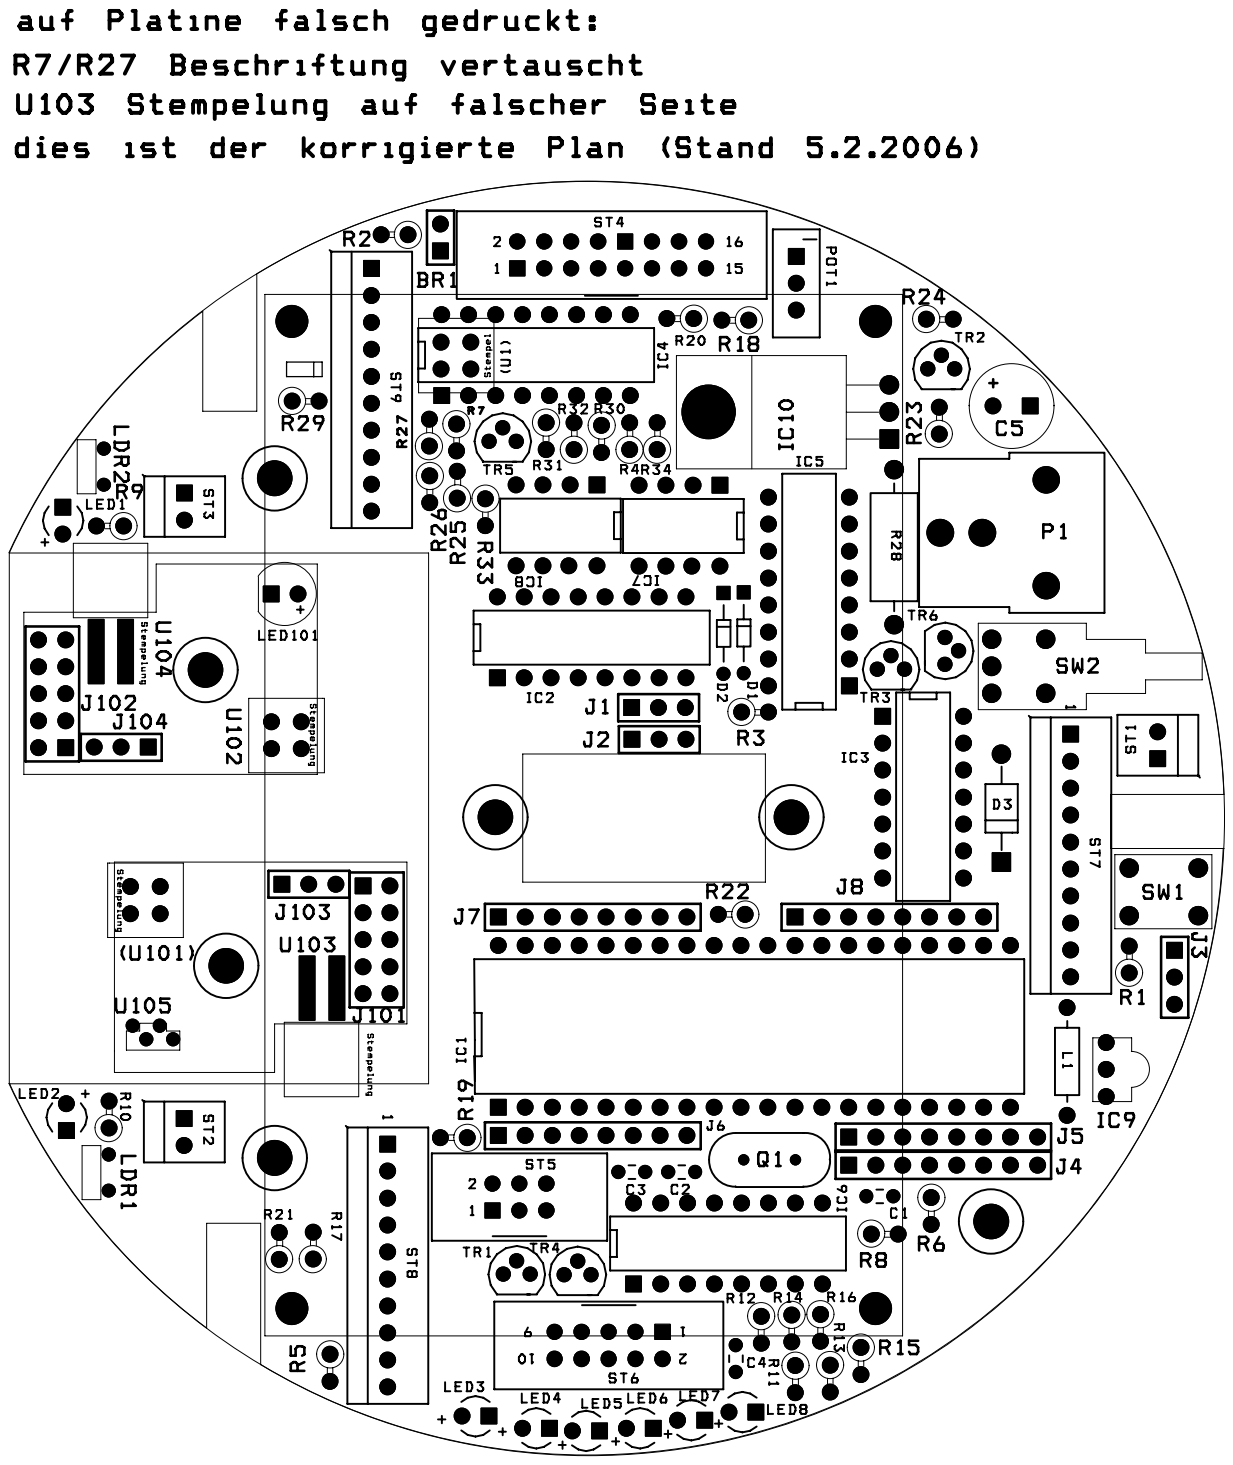
[picture p37: page 1]
