tsandmann/ct-bot-hw/v1/pcb-layout/04_pcb_usb-2-bot.pdf

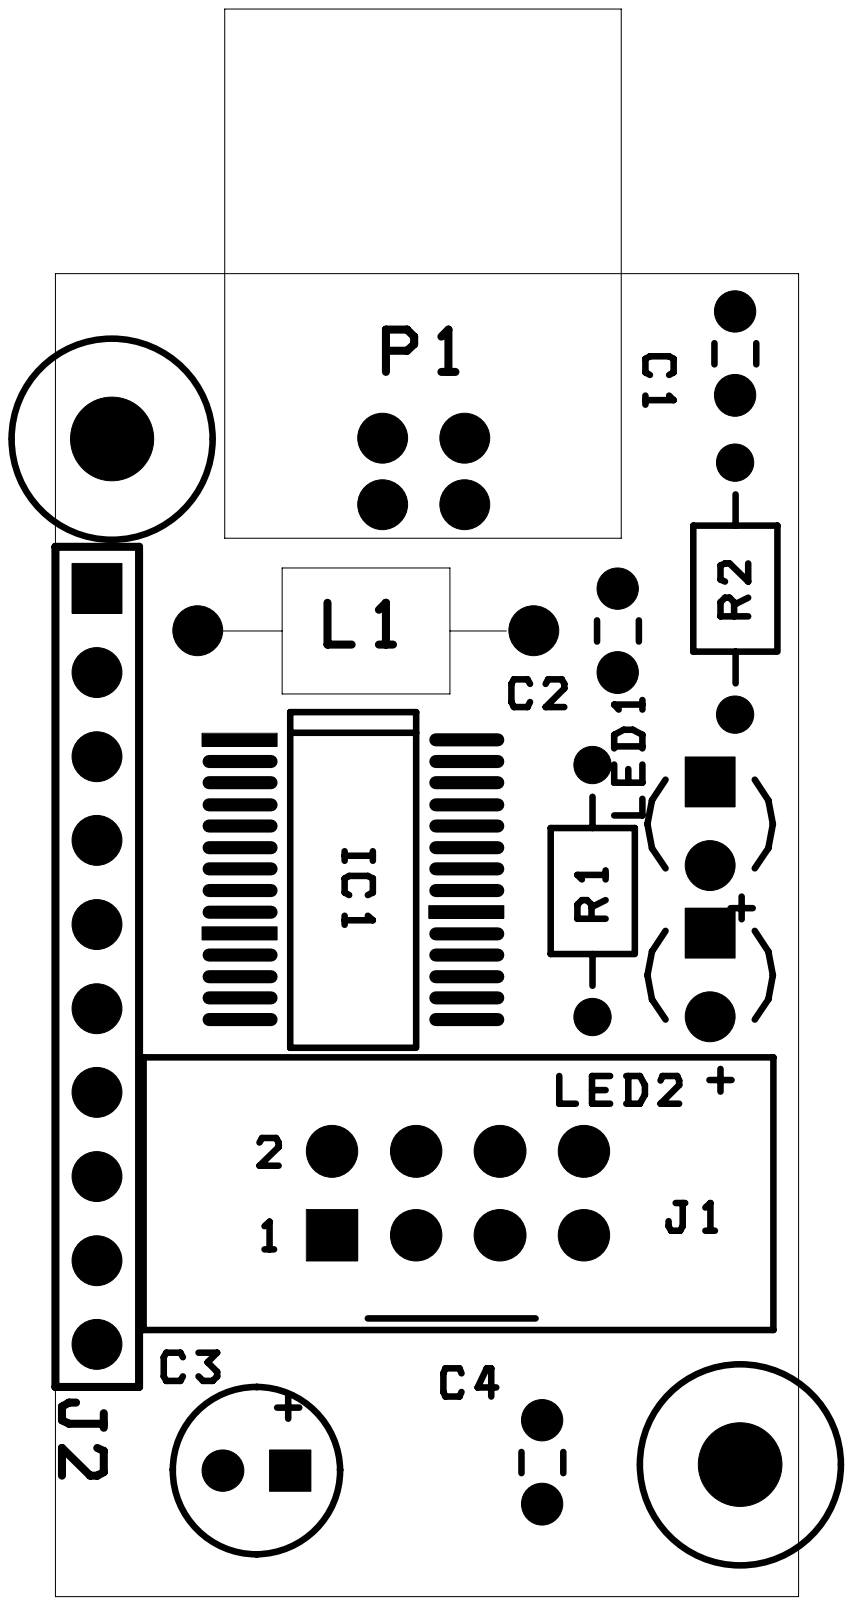
[picture p38: page 1]
