tsandmann/ct-bot-hw/v1/pcb-layout/05_pcb_extensionboard.pdf

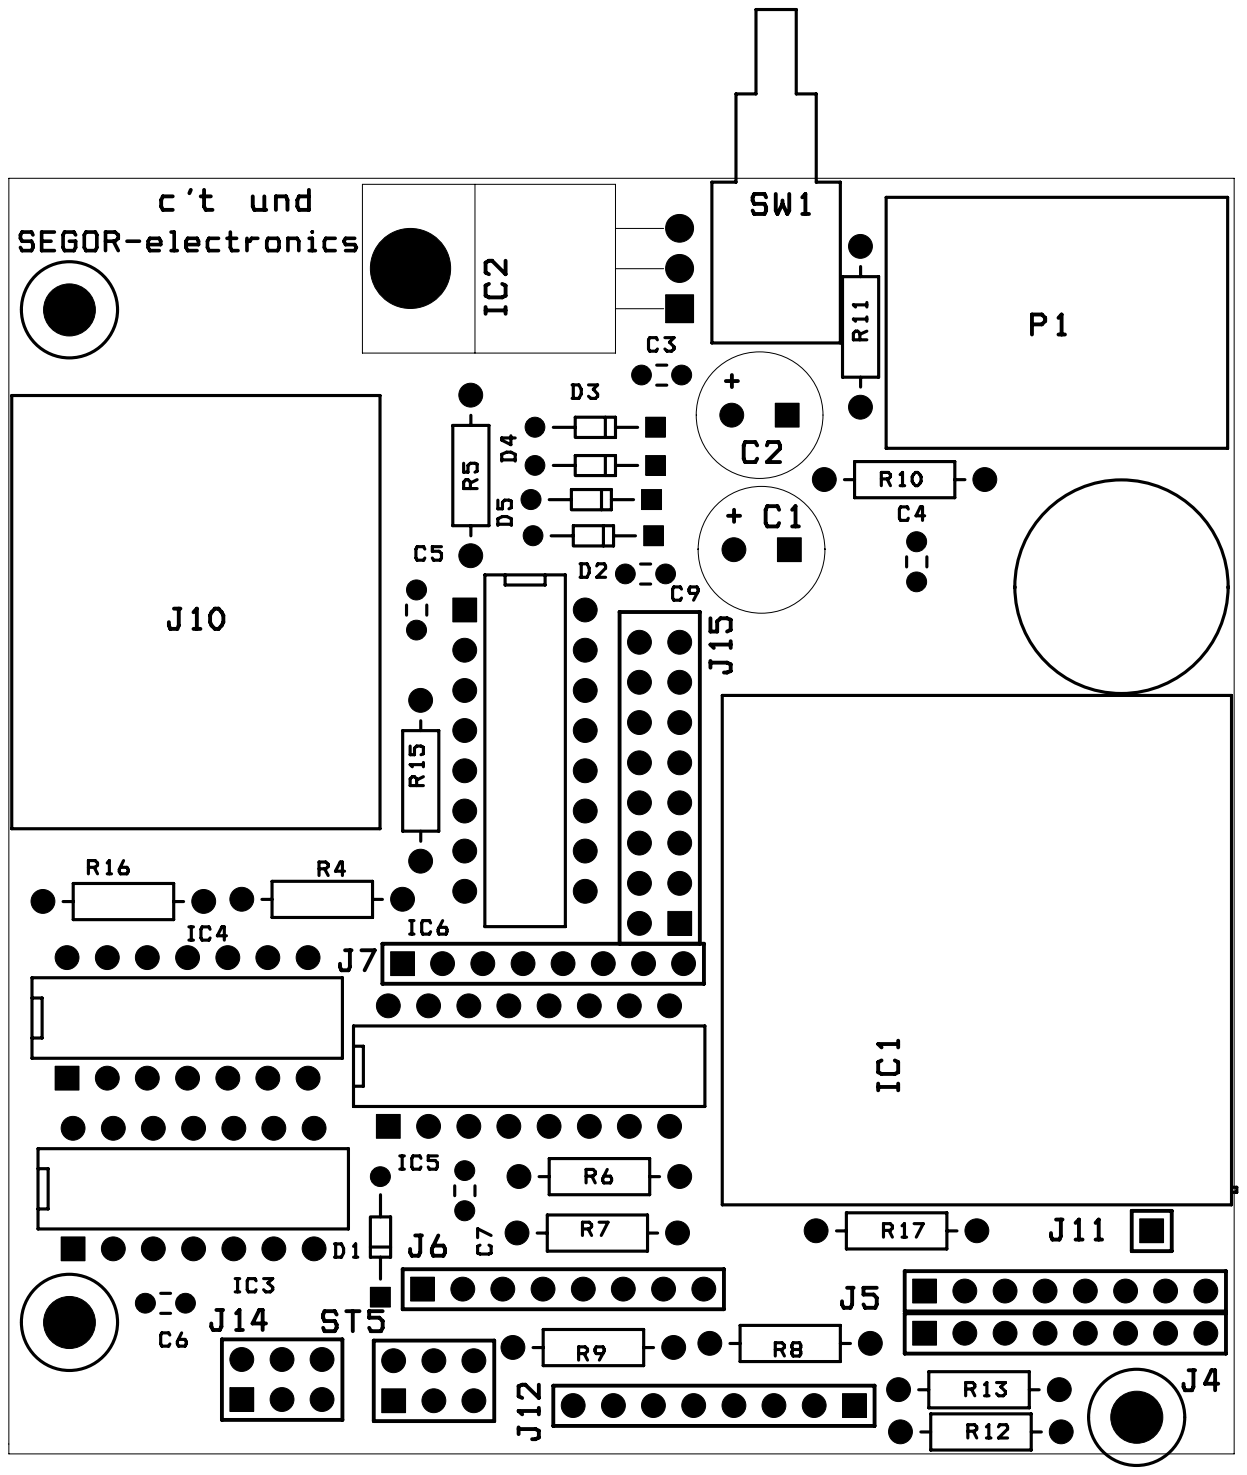
[picture p39: page 1]
