tsandmann/ct-bot-hw/v2/adapter_boards/teensy_adapter_v1/teensy_adapter.pdf

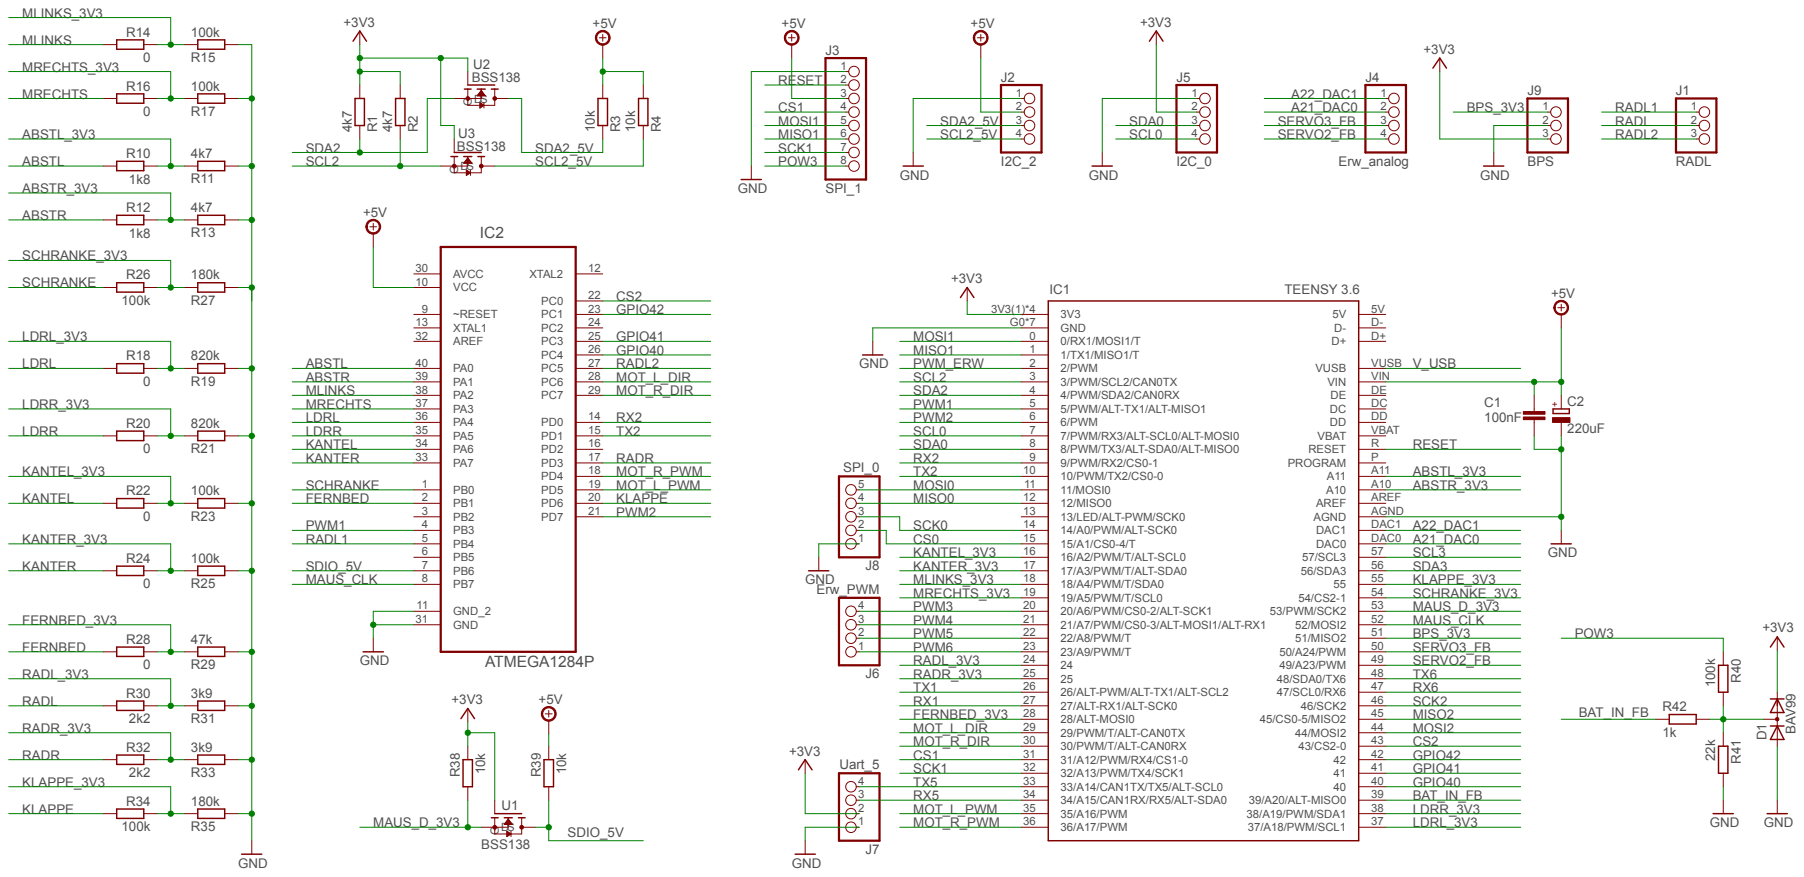
[picture p40: page 1]
