tsandmann/ct-bot-hw/v2/boards/display_adapter.brd

## EAGLE design v2/boards/display_adapter.brd (2023-01-07)

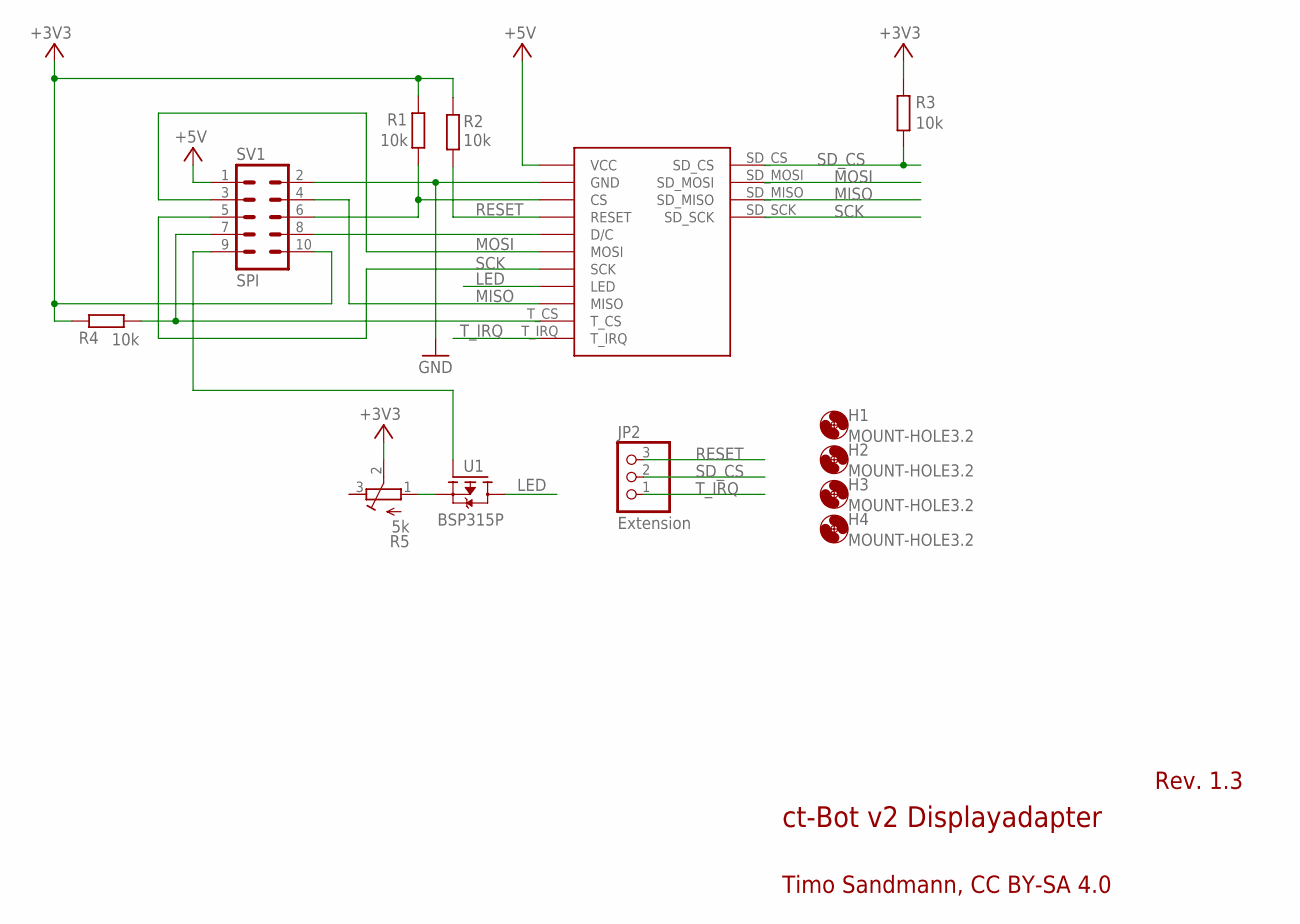
[picture p41: schematic display_adapter.sch]

Parts:
H1, H2, H3, H4: MOUNT-HOLE3.2; 3,2
J1: SPI_TFT_DISPLAY_TOUCH; SPI_DISPLAY_TOUCH
JP2: Extension; 1X03
R1, R2, R3, R4: 10k; 0204/7
R5: 5k; RTRIM64W
SV1: SPI; ML10
U1: BSP315P; PG-SOT-223

Connections:
+3V3: R1.2, R2.2, R3.2, R4.2, R5.2 (S), SV1.10
+5V: J1.VCC, SV1.1
GND: J1.GND, SV1.2
LED: J1.LED, U1.2 (D), U1.4 (D)
MISO: J1.MISO, J1.SD_MISO, J1.T_MISO (MISO), SV1.4
MOSI: J1.MOSI, J1.SD_MOSI, J1.T_MOSI (MOSI), SV1.3
unnamed: SV1.9, U1.1 (G)
unnamed: R5.1 (A), U1.3 (S)
unnamed: J1.CS, R1.1, SV1.6
unnamed: J1.D/C, SV1.8
unnamed: J1.T_CS, R4.1, SV1.7
RESET: J1.RESET, JP2.3, R2.1
SCK: J1.SCK, J1.SD_SCK, J1.T_SCK (SCK), SV1.5
SD_CS: J1.SD_CS, JP2.2, R3.1
T_IRQ: J1.T_IRQ, JP2.1

Notes on the sheet:
ct-Bot v2 Displayadapter
Rev. 1.3
Timo Sandmann, CC BY-SA 4.0

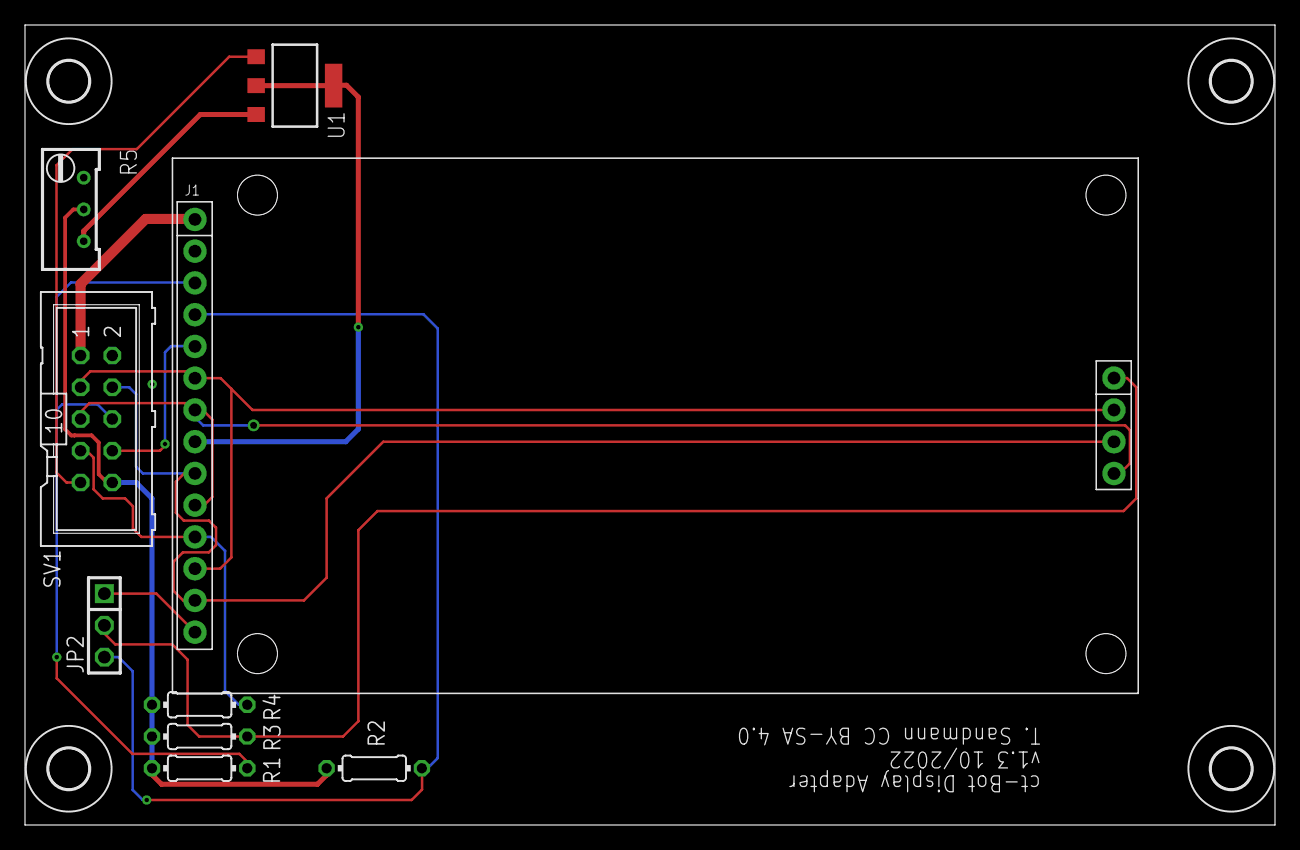
[picture p42: board display_adapter.brd from above]

Board: 2 copper layers, 100.0 x 64.0 mm, 13 parts (0 on the bottom side), 15 nets.
