tsandmann/ct-bot-hw/v2/boards/mainboard.brd

## EAGLE design v2/boards/mainboard.brd (2023-01-07)

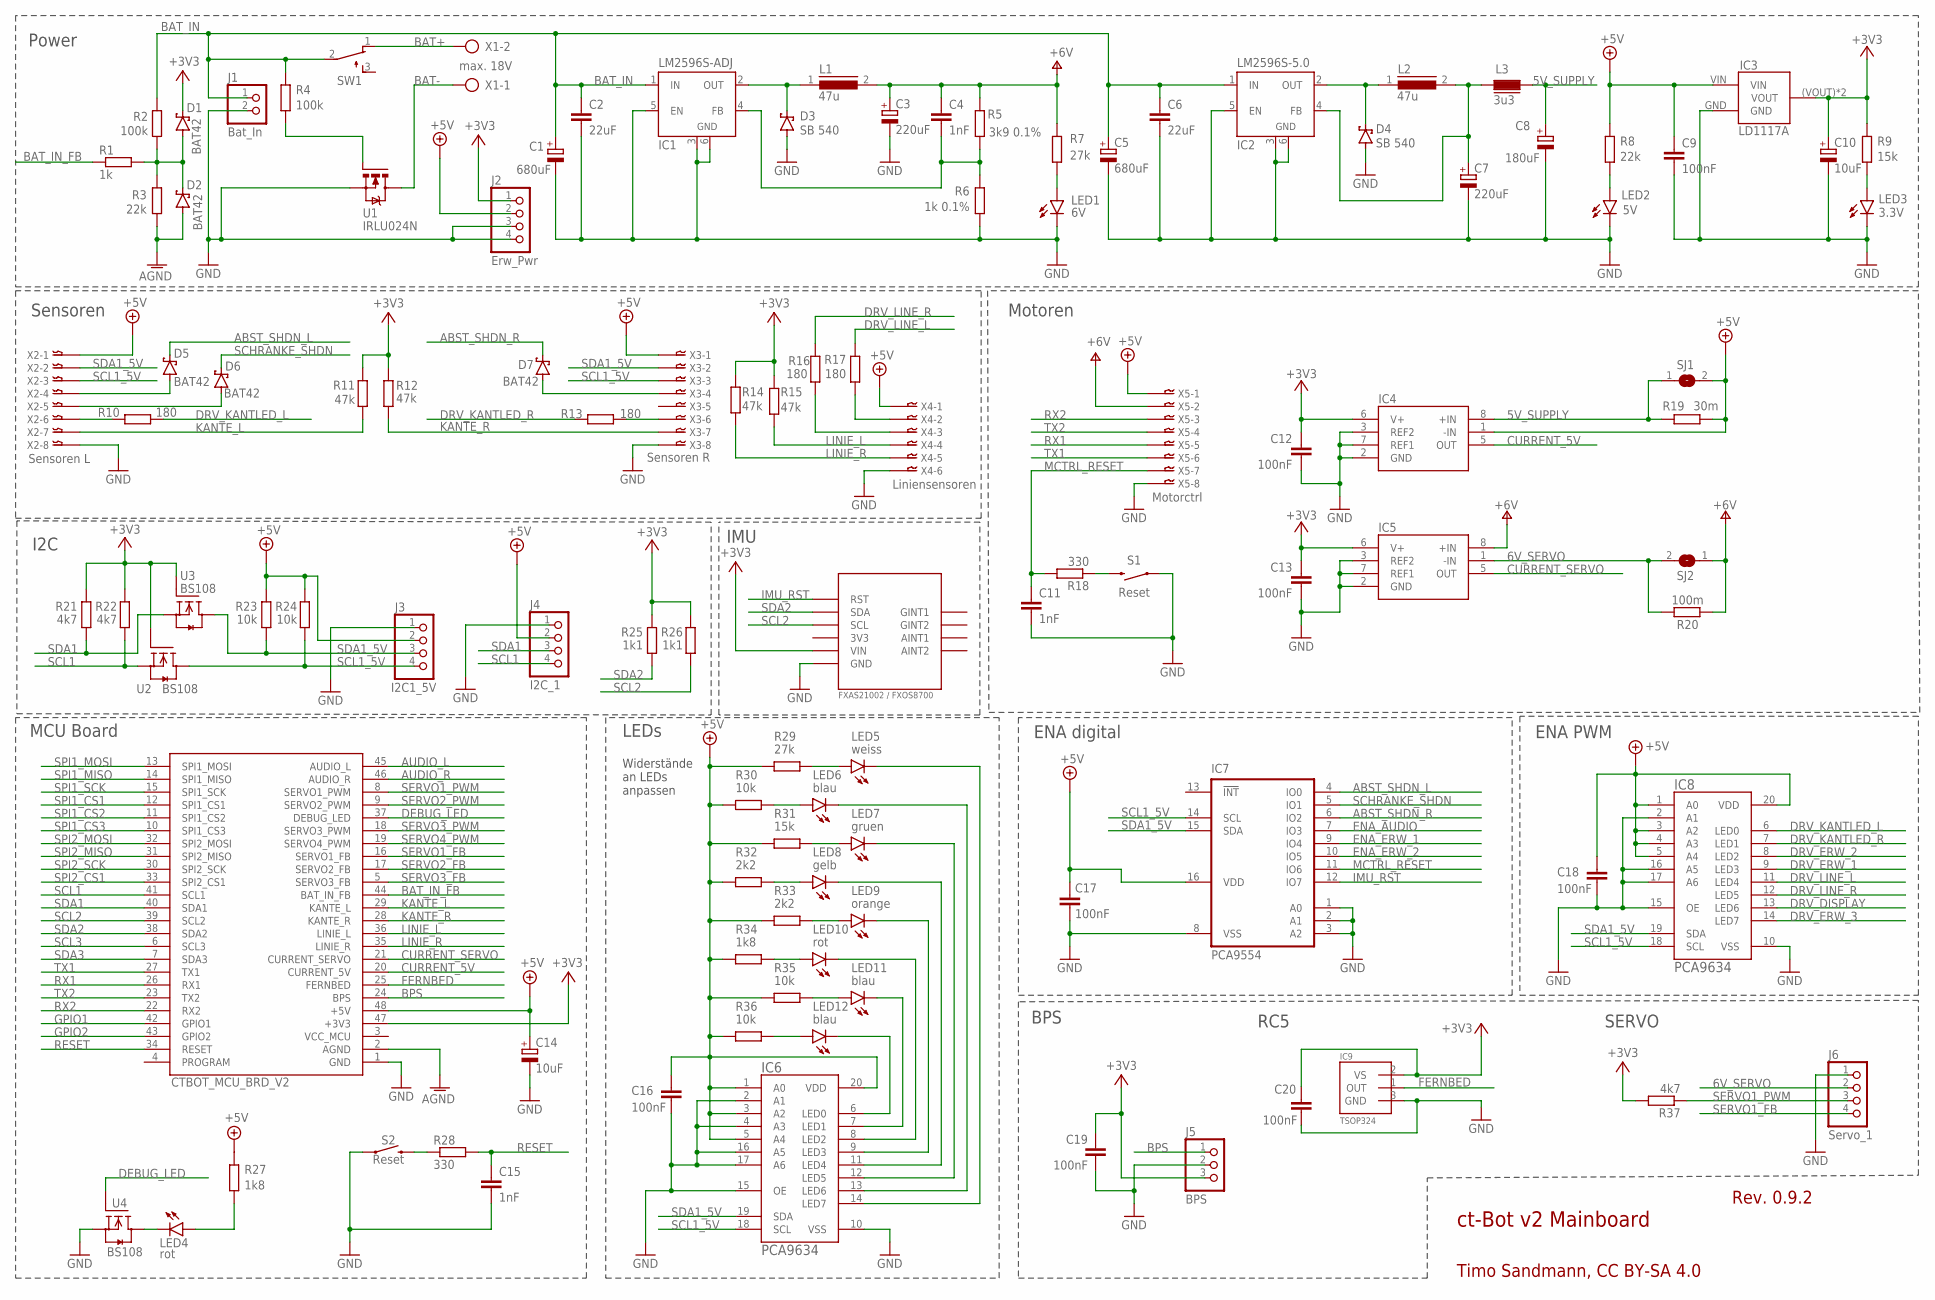
[picture p43: schematic mainboard.sch, sheet 1]

Parts:
C1, C5: 680uF; E5-10,5
C2, C6: 22uF; C025-025X050
C3, C7: 220uF; E5-10,5
C4, C11, C15: 1nF; C025-025X050
C8: 180uF; E3,5-8
C9, C16, C17, C18, C19, C20: 100nF; C025-025X050
C10: 10uF; E2-5
C12, C13: 100nF; C0805
C14: 10uF; TT2D5L
D1, D2: BAT42; DO35-7
D3, D4: SB 540; DO201T15
D5, D6, D7: BAT42; 0207/2V
IC1: LM2596S-ADJ; TO263-5
IC2: LM2596S-5.0; TO263-5
IC3: LD1117A; LD1117SOT-223
IC4, IC5: INA28AID; SO08
IC6, IC8: PCA9634; SO20W
IC7: PCA9554; SO16W
IC9: TSOP324
J1: Bat_In; 1X02
J2: Erw_Pwr; 1X04
J3: I2C1_5V; 1X04
J4: I2C_1; 1X04
J5: BPS; 1X03
J6: Servo_1; 1X04
L1, L2: 47u; 09HCP
L3: 3u3; FASTRON_07HCP_INDUCTOR
LED1: 6V; LED3MM
LED2: 5V; LED3MM
LED3: 3.3V; LED3MM
LED4, LED10: rot; LED3MM
LED5: weiss; LED3MM
LED6, LED11, LED12: blau; LED3MM
LED7: gruen; LED3MM
LED8: gelb; LED3MM
LED9: orange; LED3MM
MCU: CTBOT_MCU_BRD_V2; DIP48
R1: 1k; 0204/7
R2: 100k; 0204/7
R3: 22k; 0204/7
R4: 100k; 0204V
R5: 3k9 0.1%; 0204V
R6: 1k 0.1%; 0204V
R7, R29: 27k; 0204V
R8: 22k; 0204V
R9, R31: 15k; 0204V
R10, R13, R16, R17: 180; 0204V
R11, R12: 47k; 0204V
R14, R15: 47k; 0204/7
R18, R28: 330; 0204V
R19: 30m; R2512
R20: 100m; R2512
R21, R22, R37: 4k7; 0204/7
R23, R24, R30, R35, R36: 10k; 0204V
R25, R26: 1k1; 0204/7
R27, R34: 1k8; 0204V
R32, R33: 2k2; 0204V
S1, S2: Reset; TACTILE_SWITCH_PTH_6.0MM
SJ1, SJ2: SJ
SW1: TL32PO; TL3XPO
U1: IRLU024N; TO251AA
U2, U3, U4: BS108; SOT54E
U$10: IMU; NXP_9DOF
X1: max. 18V; AK500/2-H
X2: Sensoren L; B8B-XH
X3: Sensoren R; B8B-XH
X4: Liniensensoren; B6B-XH
X5: Motorctrl; B8B-XH

Connections:
5V_SUPPLY: C8.+, IC4.8 (+IN), L3.2, R19.1, SJ1.1
6V_SERVO: IC5.1 (-IN), J6.2, R20.2, SJ2.2; also elsewhere on the board
+3V3: C10.+, C12.1, C13.1, C19.1, C20.1, D1.C, IC3.(VOUT) (VOUT), IC3.VOUT, IC4.6 (V+), IC5.6 (V+), IC9.2 (VS), J2.1, J5.3, MCU.47 (+3V3), R9.2, R11.2, R12.1, R14.2, R15.2, R21.2, R22.2, R25.2, R26.2, R37.2, U2.G, U3.G, U$10.VIN; also elsewhere on the board
+5V: C9.1, C14.+, C16.1, C17.1, C18.1, IC3.VIN, IC4.1 (-IN), IC6.1 (A0), IC6.3 (A2), IC6.5 (A4), IC6.20 (VDD), IC7.16 (VDD), IC8.1 (A0), IC8.3 (A2), IC8.4 (A3), IC8.5 (A4), IC8.20 (VDD), J2.2, J3.2, J4.2, MCU.48 (+5V), R8.2, R19.2, R23.2, R24.2, R27.2, R29.1, R30.1, R31.1, R32.1, R33.1, R34.1, R35.1, R36.1, SJ1.2, X2.P$1, X3.P$1, X4.P$1, X5.P$1; also elsewhere on the board
+6V: C3.+, C4.1, IC5.8 (+IN), L1.2, R5.2, R7.1, R20.1, SJ2.1, X5.P$2
ABST_SHDN_L: D5.2 (C), IC7.4 (IO0)
ABST_SHDN_R: D7.2 (C), IC7.6 (IO2)
AGND: D2.A, MCU.2 (AGND), R3.1; also elsewhere on the board
AUDIO_L: MCU.45 (AUDIO_L); also elsewhere on the board
AUDIO_R: MCU.46 (AUDIO_R); also elsewhere on the board
BAT+: SW1.1 (O), X1.2
BAT-: U1.2 (D), U1.4 (D), X1.1
BAT_IN: C1.+, C2.1, C5.+, C6.1, IC1.1 (IN), IC2.1 (IN), J1.1, R2.2, R4.2, SW1.2; also elsewhere on the board
BAT_IN_FB: MCU.44 (BAT_IN_FB), R1.1
BPS: J5.1, MCU.24 (BPS)
CURRENT_5V: IC4.5 (OUT), MCU.20 (CURRENT_5V)
CURRENT_SERVO: IC5.5 (OUT), MCU.21 (CURRENT_SERVO)
DEBUG_LED: MCU.37 (DEBUG_LED), U4.G
DRV_DISPLAY: IC8.13 (LED6); also elsewhere on the board
DRV_ERW_1: IC8.9 (LED3); also elsewhere on the board
DRV_ERW_2: IC8.8 (LED2); also elsewhere on the board
DRV_ERW_3: IC8.14 (LED7); also elsewhere on the board
DRV_KANTLED_L: IC8.6 (LED0), R10.2
DRV_KANTLED_R: IC8.7 (LED1), R13.1
DRV_LINE_L: IC8.11 (LED4), R17.2
DRV_LINE_R: IC8.12 (LED5), R16.2
ENA_AUDIO: IC7.7 (IO3); also elsewhere on the board
ENA_ERW_1: IC7.9 (IO4); also elsewhere on the board
ENA_ERW_2: IC7.10 (IO5); also elsewhere on the board
FERNBED: IC9.1 (OUT), MCU.25 (FERNBED)
GND: C1.-, C2.2, C3.-, C5.-, C6.2, C7.-, C8.-, C9.2, C10.-, C11.2, C12.2, C13.2, C14.-, C15.2, C16.2, C17.2, C18.2, C19.2, C20.2, D3.A, D4.A, IC1.3 (GND), IC1.5 (EN), IC1.6 (GND), IC2.3 (GND), IC2.5 (EN), IC2.6 (GND), IC3.GND, IC4.2 (GND), IC4.3 (REF2), IC4.7 (REF1), IC5.2 (GND), IC5.3 (REF2), IC5.7 (REF1), IC6.2 (A1), IC6.4 (A3), IC6.10 (VSS), IC6.15 (OE), IC6.16 (A5), IC6.17 (A6), IC7.1 (A0), IC7.2 (A1), IC7.3 (A2), IC7.8 (VSS), IC8.2 (A1), IC8.10 (VSS), IC8.15 (OE), IC8.16 (A5), IC8.17 (A6), IC9.3 (GND), J1.2, J2.3, J2.4, J3.1, J4.1, J5.2, J6.1, LED1.K (C), LED2.K (C), LED3.K (C), MCU.1 (GND), R6.1, S1.1, S2.1, U1.3 (S), U4.S, U$10.GND, X2.P$8, X3.P$8, X4.P$6, X5.P$8; also elsewhere on the board
GPIO1: MCU.42 (GPIO1); also elsewhere on the board
GPIO2: MCU.43 (GPIO2); also elsewhere on the board
IMU_RST: IC7.12 (IO7), U$10.RST; also elsewhere on the board
KANTE_L: MCU.29 (KANTE_L), R11.1, X2.P$7
KANTE_R: MCU.28 (KANTE_R), R12.2, X3.P$7
LINIE_L: MCU.36 (LINIE_L), R15.1, X4.P$4
LINIE_R: MCU.35 (LINIE_R), R14.1, X4.P$5
MCTRL_RESET: C11.1, IC7.11 (IO6), R18.2, X5.P$7
unnamed: R16.1, X4.P$3
unnamed: LED3.A, R9.1
unnamed: D1.A, D2.C, R1.2, R2.1, R3.2
unnamed: R18.1, S1.3 (2)
unnamed: IC6.6 (LED0), LED12.K (C)
unnamed: IC6.7 (LED1), LED11.K (C)
unnamed: LED1.A, R7.2
unnamed: C4.2, IC1.4 (FB), R5.1, R6.2
unnamed: LED2.A, R8.1
unnamed: IC6.8 (LED2), LED10.K (C)
unnamed: R28.1, S2.3 (2)
unnamed: IC6.9 (LED3), LED9.K (C)
unnamed: IC6.11 (LED4), LED8.K (C)
unnamed: IC6.12 (LED5), LED7.K (C)
unnamed: IC6.13 (LED6), LED6.K (C)
unnamed: IC6.14 (LED7), LED5.K (C)
unnamed: LED5.A, R29.2
unnamed: LED6.A, R30.2
unnamed: LED7.A, R31.2
unnamed: LED8.A, R32.2
unnamed: LED9.A, R33.2
unnamed: LED10.A, R34.2
unnamed: LED11.A, R35.2
unnamed: LED12.A, R36.2
unnamed: LED4.A, R27.1
unnamed: LED4.K (C), U4.D
unnamed: R17.1, X4.P$2
unnamed: R4.1, U1.1 (G)
unnamed: R10.1, X2.P$6
unnamed: R13.2, X3.P$6
RESET: C15.1, MCU.34 (RESET), R28.2
RX1: MCU.26 (RX1), X5.P$5; also elsewhere on the board
RX2: MCU.22 (RX2), X5.P$3
SCHRANKE_SHDN: D6.2 (C), IC7.5 (IO1)
SCL1: J4.4, MCU.41 (SCL1), R22.1, U2.S
SCL1_5V: IC6.18 (SCL), IC7.14 (SCL), IC8.18 (SCL), J3.4, R24.1, U2.D, X2.P$3, X3.P$3
SCL2: MCU.39 (SCL2), R26.1, U$10.SCL; also elsewhere on the board
SCL3: MCU.6 (SCL3); also elsewhere on the board
SDA1: J4.3, MCU.40 (SDA1), R21.1, U3.S
SDA1_5V: IC6.19 (SDA), IC7.15 (SDA), IC8.19 (SDA), J3.3, R23.1, U3.D, X2.P$2, X3.P$2
SDA2: MCU.38 (SDA2), R25.1, U$10.SDA; also elsewhere on the board
SDA3: MCU.7 (SDA3); also elsewhere on the board
SERVO1_FB: J6.4, MCU.16 (SERVO1_FB)
SERVO1_PWM: J6.3, MCU.8 (SERVO1_PWM), R37.1
SERVO2_FB: MCU.17 (SERVO2_FB); also elsewhere on the board
SERVO2_PWM: MCU.9 (SERVO2_PWM); also elsewhere on the board
SERVO3_FB: MCU.5 (SERVO3_FB); also elsewhere on the board
SERVO3_PWM: MCU.18 (SERVO3_PWM); also elsewhere on the board
SERVO4_PWM: MCU.19 (SERVO4_PWM); also elsewhere on the board
SPI1_CS1: MCU.12 (SPI1_CS1); also elsewhere on the board
SPI1_CS2: MCU.11 (SPI1_CS2); also elsewhere on the board
SPI1_CS3: MCU.10 (SPI1_CS3); also elsewhere on the board
SPI1_MISO: MCU.14 (SPI1_MISO); also elsewhere on the board
SPI1_MOSI: MCU.13 (SPI1_MOSI); also elsewhere on the board
SPI1_SCK: MCU.15 (SPI1_SCK); also elsewhere on the board
SPI2_CS1: MCU.33 (SPI2_CS1); also elsewhere on the board
SPI2_MISO: MCU.31 (SPI2_MISO); also elsewhere on the board
SPI2_MOSI: MCU.32 (SPI2_MOSI); also elsewhere on the board
SPI2_SCK: MCU.30 (SPI2_SCK); also elsewhere on the board
TX1: MCU.27 (TX1), X5.P$6; also elsewhere on the board
TX2: MCU.23 (TX2), X5.P$4
V5_L2: D4.C, IC2.2 (OUT), L2.1
V5_L3: C7.+, IC2.4 (FB), L2.2, L3.1
V6_L1: D3.C, IC1.2 (OUT), L1.1
VCC_MCU: MCU.3 (VCC_MCU)
VL53L0X_SHUT_L: D5.1 (A), X2.P$4
VL53L0X_SHUT_R: D7.1 (A), X3.P$4
VL6180X_SHDN: D6.1 (A), X2.P$5

Notes on the sheet:
ct-Bot v2 Mainboard
Rev. 0.9.2
Timo Sandmann, CC BY-SA 4.0
Widerstände an LEDs anpassen
Power
Sensoren
I2C
MCU Board
ENA digital
ENA PWM
LEDs
RC5
Motoren
BPS
SERVO
IMU

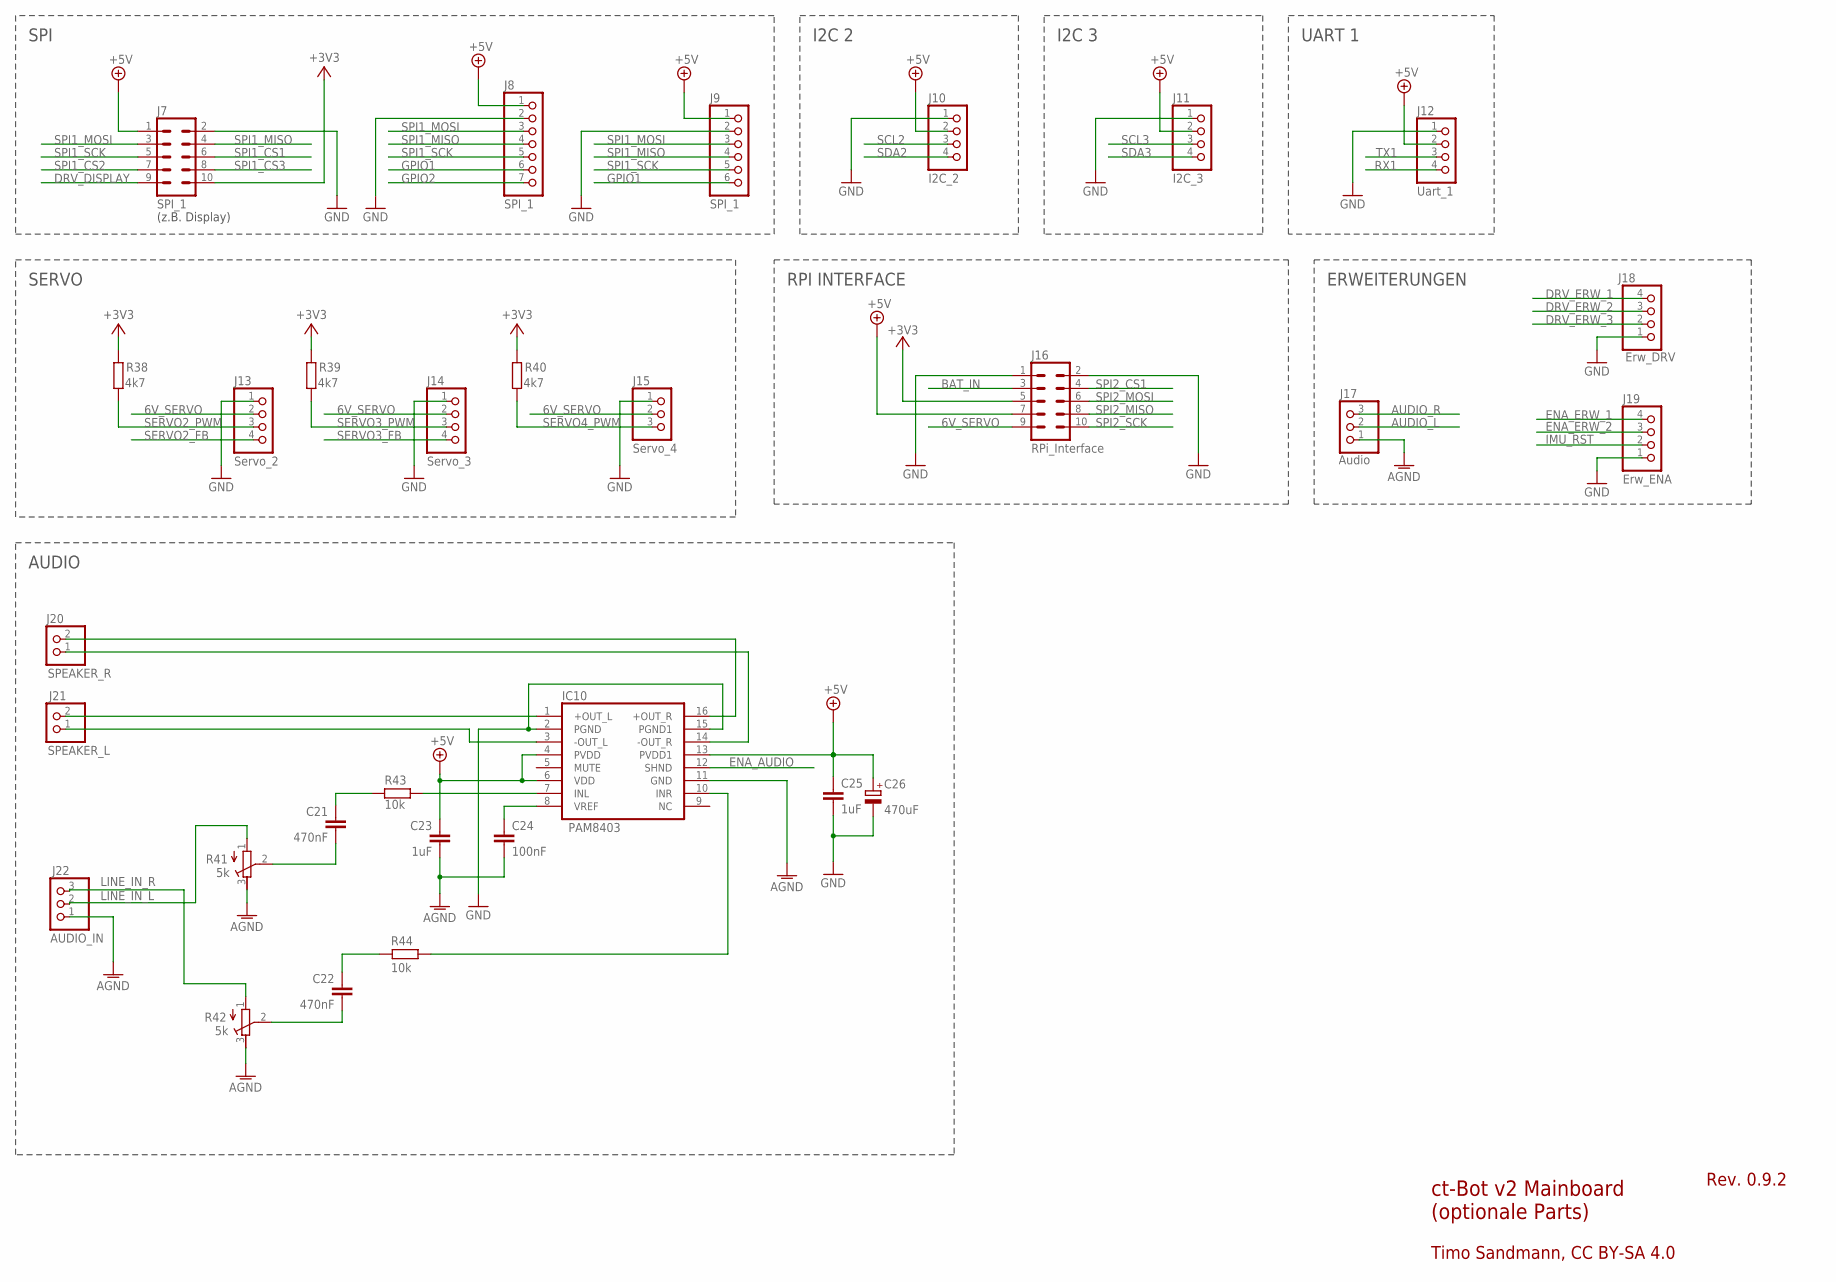
[picture p44: schematic mainboard.sch, sheet 2]

Parts:
C21, C22: 470nF; C025-025X050
C23, C25: 1uF; C025-025X050
C24: 100nF; C025-025X050
C26: 470uF; E3,5-8
IC10: PAM8403; SOP-16
J7: SPI_1; ML10
J8: SPI_1; 1X07
J9: SPI_1; 1X06
J10: I2C_2; 1X04
J11: I2C_3; 1X04
J12: Uart_1; 1X04
J13: Servo_2; 1X04
J14: Servo_3; 1X04
J15: Servo_4; 1X03
J16: RPi_Interface; ML10
J17: Audio; 1X03
J18: Erw_DRV; 1X04
J19: Erw_ENA; 1X04
J20: SPEAKER_R; 1X02
J21: SPEAKER_L; 1X02
J22: AUDIO_IN; 1X03
R38, R39, R40: 4k7; 0204/7
R41, R42: 5k; RTRIM64W
R43, R44: 10k; 0204V

Connections:
6V_SERVO: J13.2, J14.2, J15.2, J16.9; also elsewhere on the board
+3V3: J7.10, J16.5, R38.2, R39.2, R40.2; also elsewhere on the board
+5V: C23.1, C25.1, C26.+, IC10.4 (PVDD), IC10.6 (VDD), IC10.13 (PVDD1), J7.1, J8.1, J9.1, J10.2, J11.2, J12.2, J16.7; also elsewhere on the board
AGND: C23.2, C24.2, IC10.11 (GND), J17.1, J22.1, R41.3 (E), R42.3 (E); also elsewhere on the board
AUDIO_L: J17.2; also elsewhere on the board
AUDIO_R: J17.3; also elsewhere on the board
BAT_IN: J16.3; also elsewhere on the board
DRV_DISPLAY: J7.9; also elsewhere on the board
DRV_ERW_1: J18.4; also elsewhere on the board
DRV_ERW_2: J18.3; also elsewhere on the board
DRV_ERW_3: J18.2; also elsewhere on the board
ENA_AUDIO: IC10.12 (SHND); also elsewhere on the board
ENA_ERW_1: J19.4; also elsewhere on the board
ENA_ERW_2: J19.3; also elsewhere on the board
GND: C25.2, C26.-, IC10.2 (PGND), IC10.15 (PGND1), J7.2, J8.2, J9.2, J10.1, J11.1, J12.1, J13.1, J14.1, J15.1, J16.1, J16.2, J18.1, J19.1; also elsewhere on the board
GPIO1: J8.6, J9.6; also elsewhere on the board
GPIO2: J8.7; also elsewhere on the board
IMU_RST: J19.2; also elsewhere on the board
LINE_IN_L: J22.2, R41.1 (A)
LINE_IN_R: J22.3, R42.1 (A)
unnamed: IC10.1 (+OUT_L), J21.2
unnamed: IC10.3 (-OUT_L), J21.1
unnamed: C24.1, IC10.8 (VREF)
unnamed: C22.2, R42.2 (S)
unnamed: IC10.7 (INL), R43.1
unnamed: C21.1, R43.2
unnamed: C21.2, R41.2 (S)
unnamed: IC10.14 (-OUT_R), J20.1
unnamed: IC10.16 (+OUT_R), J20.2
unnamed: IC10.10 (INR), R44.1
unnamed: C22.1, R44.2
RX1: J12.4; also elsewhere on the board
SCL2: J10.3; also elsewhere on the board
SCL3: J11.3; also elsewhere on the board
SDA2: J10.4; also elsewhere on the board
SDA3: J11.4; also elsewhere on the board
SERVO2_FB: J13.4; also elsewhere on the board
SERVO2_PWM: J13.3, R38.1; also elsewhere on the board
SERVO3_FB: J14.4; also elsewhere on the board
SERVO3_PWM: J14.3, R39.1; also elsewhere on the board
SERVO4_PWM: J15.3, R40.1; also elsewhere on the board
SPI1_CS1: J7.6; also elsewhere on the board
SPI1_CS2: J7.7; also elsewhere on the board
SPI1_CS3: J7.8; also elsewhere on the board
SPI1_MISO: J7.4, J8.4, J9.4; also elsewhere on the board
SPI1_MOSI: J7.3, J8.3, J9.3; also elsewhere on the board
SPI1_SCK: J7.5, J8.5, J9.5; also elsewhere on the board
SPI2_CS1: J16.4; also elsewhere on the board
SPI2_MISO: J16.8; also elsewhere on the board
SPI2_MOSI: J16.6; also elsewhere on the board
SPI2_SCK: J16.10; also elsewhere on the board
TX1: J12.3; also elsewhere on the board

Notes on the sheet:
(z.B. Display)
ct-Bot v2 Mainboard (optionale Parts)
Rev. 0.9.2
SPI
I2C 2
UART 1
SERVO
ERWEITERUNGEN
AUDIO
RPI INTERFACE
I2C 3
Timo Sandmann, CC BY-SA 4.0

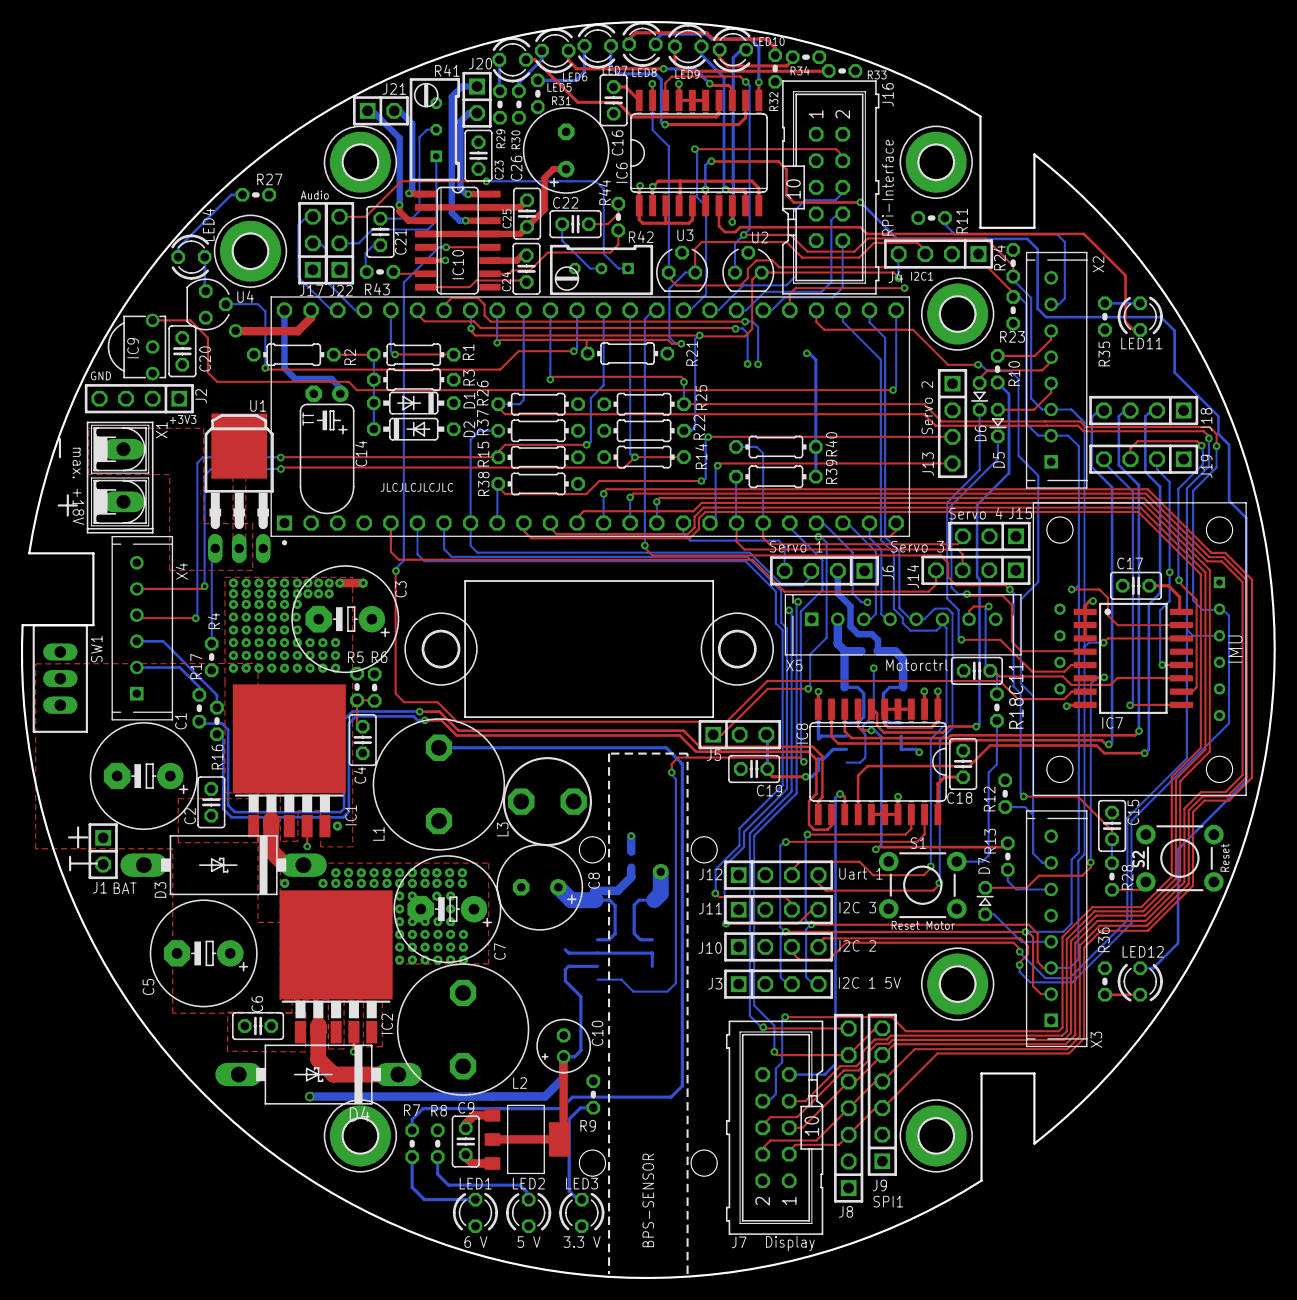
[picture p45: board mainboard.brd from above]

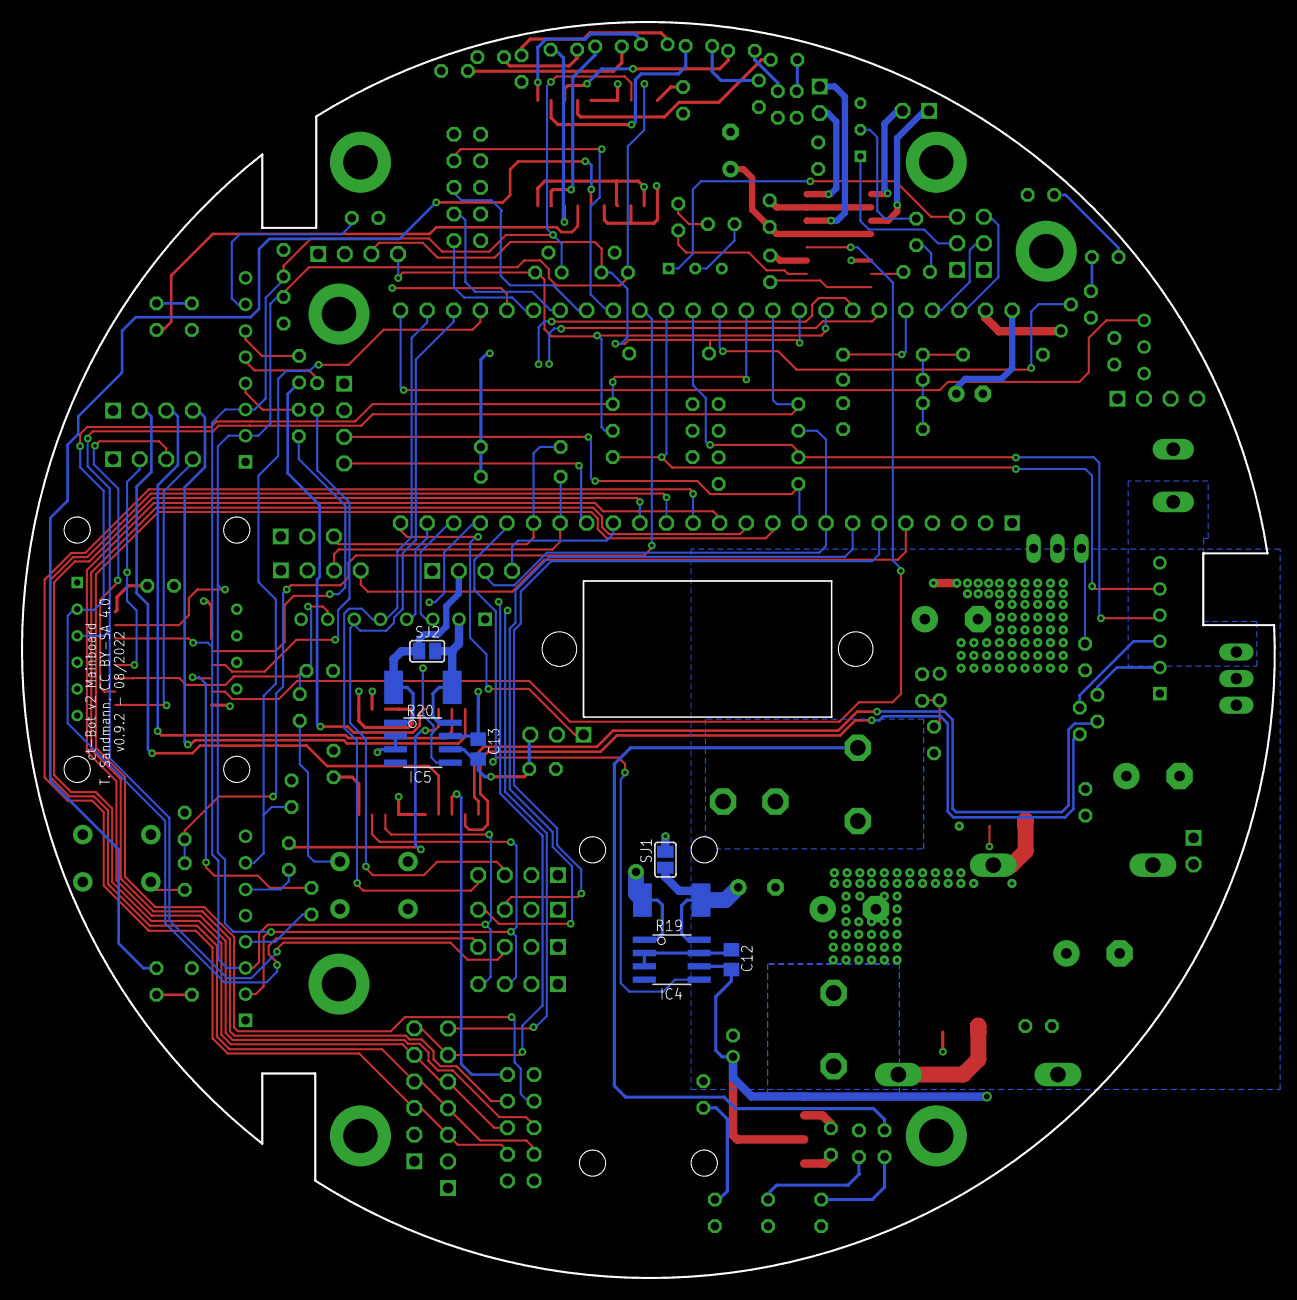
[picture p46: board mainboard.brd from below]

Board: 4 copper layers, 119.7 x 120.0 mm, 149 parts (8 on the bottom side), 119 nets.

Other parts of the board:
U$1, U$2, U$3, U$4, U$5, U$6, U$7: 3,3-PAD
U$8, U$9: 3,3
