tsandmann/ct-bot-hw/v2/boards/mcu_teensy4.1.brd

## EAGLE design v2/boards/mcu_teensy4.1.brd (2023-01-07)

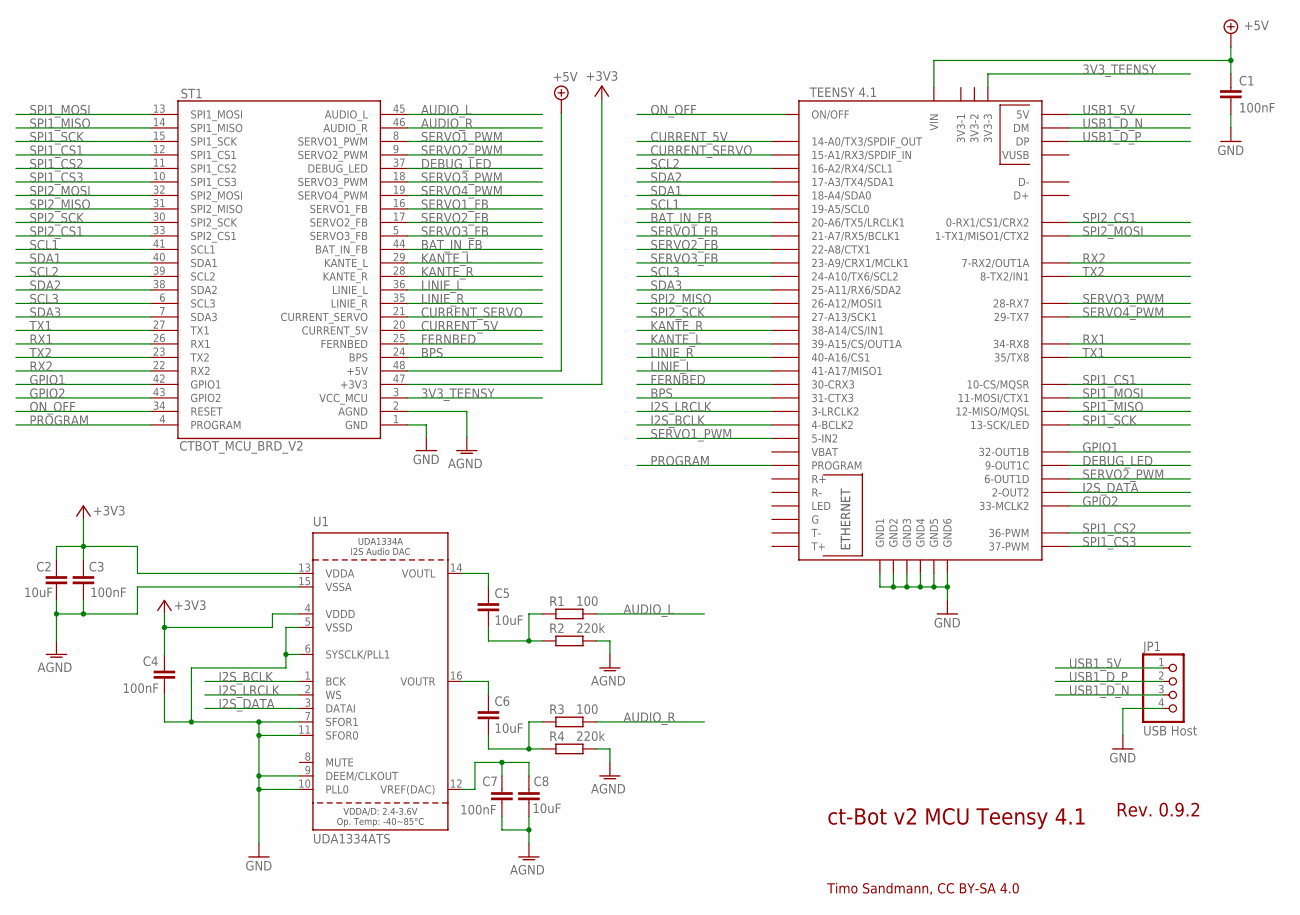
[picture p47: schematic mcu_teensy4.1.sch]

Parts:
C1, C3, C4, C7: 100nF; C0805
C2, C5, C6, C8: 10uF; C0805
JP1: USB Host; 1X04/90
R1, R3: 100; R0805
R2, R4: 220k; R0805
ST1: CTBOT_MCU_BRD_V2; DIP48
U1: UDA1334ATS; SSOP16_4.4MM
U$1: TEENSY41

Connections:
3V3_TEENSY: ST1.3 (VCC_MCU), U$1.3V3-3
+3V3: C2.1, C3.2, C4.2, ST1.47 (+3V3), U1.4 (VDDD), U1.13 (VDDA)
+5V: C1.1, ST1.48 (+5V), U$1.VIN
AGND: C2.2, C3.1, C7.1, C8.1, R2.2, R4.2, ST1.2 (AGND), U1.15 (VSSA)
AUDIO_L: R1.2, ST1.45 (AUDIO_L)
AUDIO_R: R3.2, ST1.46 (AUDIO_R)
BAT_IN_FB: ST1.44 (BAT_IN_FB), U$1.20-A6/TX5/LRCLK1
BPS: ST1.24 (BPS), U$1.31-CTX3
CURRENT_5V: ST1.20 (CURRENT_5V), U$1.14-A0/TX3/SPDIF_OUT
CURRENT_SERVO: ST1.21 (CURRENT_SERVO), U$1.15-A1/RX3/SPDIF_IN
DEBUG_LED: ST1.37 (DEBUG_LED), U$1.9-OUT1C
FERNBED: ST1.25 (FERNBED), U$1.30-CRX3
GND: C1.2, C4.1, JP1.4, ST1.1 (GND), U1.5 (VSSD), U1.6 (SYSCLK/PLL1), U1.7 (SFOR1), U1.9 (DEEM/CLKOUT), U1.10 (PLL0), U1.11 (SFOR0), U$1.GND1, U$1.GND2, U$1.GND3, U$1.GND4, U$1.GND5, U$1.GND6
GPIO1: ST1.42 (GPIO1), U$1.32-OUT1B
GPIO2: ST1.43 (GPIO2), U$1.33-MCLK2
I2S_BCLK: U1.1 (BCK), U$1.4-BCLK2
I2S_DATA: U1.3 (DATAI), U$1.2-OUT2
I2S_LRCLK: U1.2 (WS), U$1.3-LRCLK2
KANTE_L: ST1.29 (KANTE_L), U$1.39-A15/CS/OUT1A
KANTE_R: ST1.28 (KANTE_R), U$1.38-A14/CS/IN1
LINIE_L: ST1.36 (LINIE_L), U$1.41-A17/MISO1
LINIE_R: ST1.35 (LINIE_R), U$1.40-A16/CS1
unnamed: C7.2, C8.2, U1.12 (VREF(DAC))
unnamed: C5.1, U1.14 (VOUTL)
unnamed: C6.1, U1.16 (VOUTR)
unnamed: C5.2, R1.1, R2.1
unnamed: C6.2, R3.1, R4.1
ON_OFF: ST1.34 (RESET), U$1.ON/OFF
PROGRAM: ST1.4 (PROGRAM), U$1.PROGRAM
RX1: ST1.26 (RX1), U$1.34-RX8
RX2: ST1.22 (RX2), U$1.7-RX2/OUT1A
SCL1: ST1.41 (SCL1), U$1.19-A5/SCL0
SCL2: ST1.39 (SCL2), U$1.16-A2/RX4/SCL1
SCL3: ST1.6 (SCL3), U$1.24-A10/TX6/SCL2
SDA1: ST1.40 (SDA1), U$1.18-A4/SDA0
SDA2: ST1.38 (SDA2), U$1.17-A3/TX4/SDA1
SDA3: ST1.7 (SDA3), U$1.25-A11/RX6/SDA2
SERVO1_FB: ST1.16 (SERVO1_FB), U$1.21-A7/RX5/BCLK1
SERVO1_PWM: ST1.8 (SERVO1_PWM), U$1.5-IN2
SERVO2_FB: ST1.17 (SERVO2_FB), U$1.22-A8/CTX1
SERVO2_PWM: ST1.9 (SERVO2_PWM), U$1.6-OUT1D
SERVO3_FB: ST1.5 (SERVO3_FB), U$1.23-A9/CRX1/MCLK1
SERVO3_PWM: ST1.18 (SERVO3_PWM), U$1.28-RX7
SERVO4_PWM: ST1.19 (SERVO4_PWM), U$1.29-TX7
SPI1_CS1: ST1.12 (SPI1_CS1), U$1.10-CS\MQSR (10-CS/MQSR)
SPI1_CS2: ST1.11 (SPI1_CS2), U$1.36-PWM
SPI1_CS3: ST1.10 (SPI1_CS3), U$1.37-PWM
SPI1_MISO: ST1.14 (SPI1_MISO), U$1.12-MISO/MQSL
SPI1_MOSI: ST1.13 (SPI1_MOSI), U$1.11-MOSI/CTX1
SPI1_SCK: ST1.15 (SPI1_SCK), U$1.13-SCK/LED
SPI2_CS1: ST1.33 (SPI2_CS1), U$1.0-RX1/CS1/CRX2
SPI2_MISO: ST1.31 (SPI2_MISO), U$1.26-A12/MOSI1
SPI2_MOSI: ST1.32 (SPI2_MOSI), U$1.1-TX1/MISO1/CTX2
SPI2_SCK: ST1.30 (SPI2_SCK), U$1.27-A13/SCK1
TX1: ST1.27 (TX1), U$1.35-TX8 (35/TX8)
TX2: ST1.23 (TX2), U$1.8-TX2/IN1
USB1_5V: JP1.1, U$1.+5V (5V)
USB1_D_N: JP1.3, U$1.DM
USB1_D_P: JP1.2, U$1.DP

Notes on the sheet:
ct-Bot v2 MCU Teensy 4.1
Rev. 0.9.2
Timo Sandmann, CC BY-SA 4.0

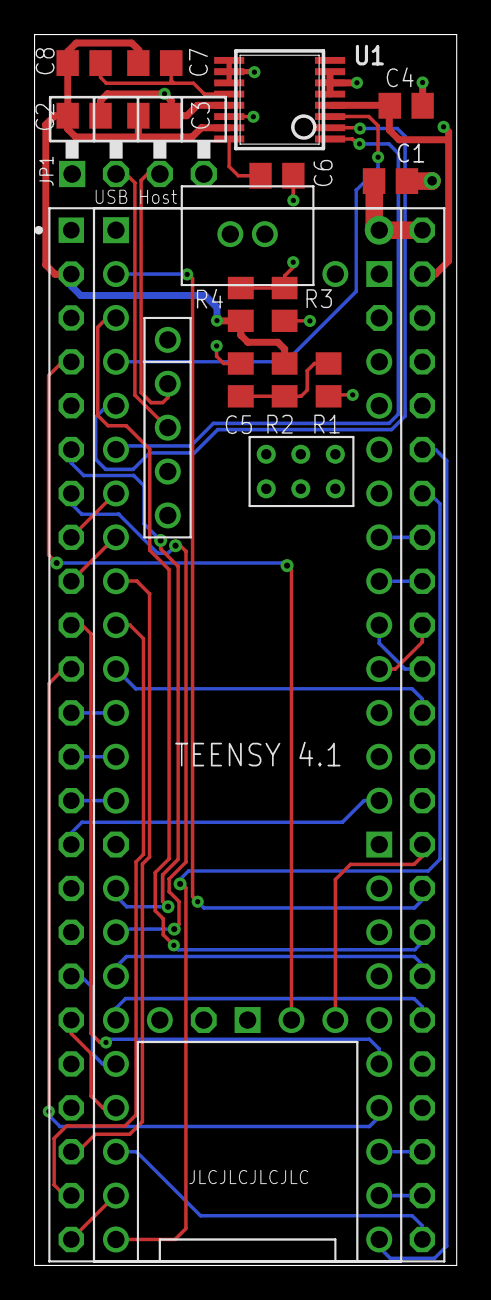
[picture p48: board mcu_teensy4.1.brd from above]

Board: 4 copper layers, 24.4 x 71.2 mm, 16 parts (0 on the bottom side), 59 nets.
