tsandmann/ct-bot-hw/v2/boards/motorctrl.brd

## EAGLE design v2/boards/motorctrl.brd (2023-01-07)

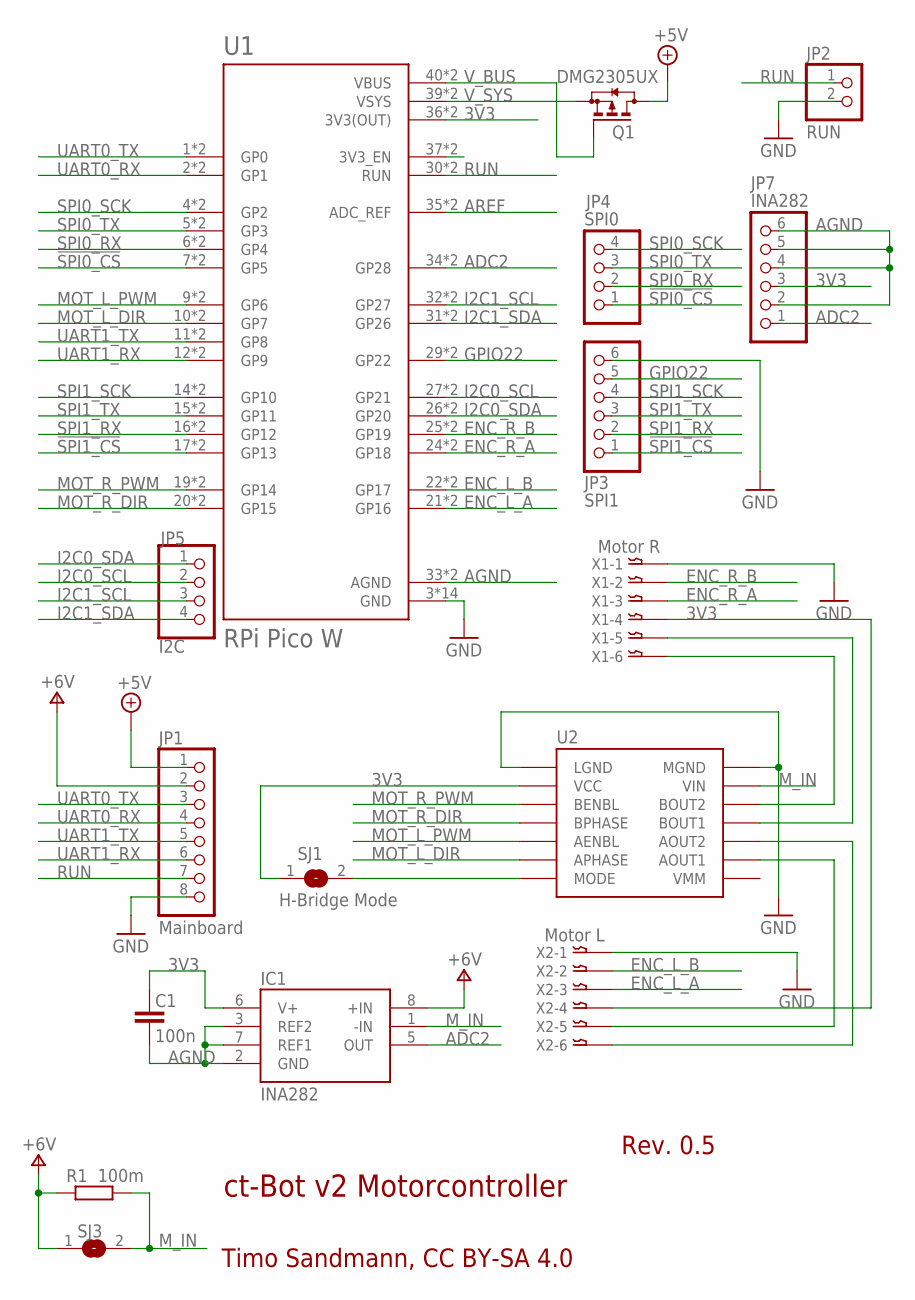
[picture p49: schematic motorctrl.sch]

Parts:
C1: 100n; C0805
IC1: INA282; SO08
JP1: Mainboard; 1X08
JP2: RUN; 1X02
JP3: SPI1; 1X06
JP4: SPI0; 1X04
JP5: I2C; 1X04
JP7: INA282; 1X06
Q1: DMG2305UX; SOT23
R1: 100m; R2512
SJ1: H-Bridge Mode; SJ
SJ3: VREF; SJ
U1: RPi Pico W; PICO-PKG-NO_DEBUG
U2: DRV8835THROUGHHOLE; DRV8835
X1: Motor R; B6B-XH
X2: Motor L; B6B-XH

Connections:
3V3: C1.2, IC1.6 (V+), JP7.3, SJ1.1, U1.36 (3V3(OUT)), U1.P$36 (3V3(OUT)), U2.VCC, X1.P$4, X2.P$4
3V3_EN: U1.37 (3V3_EN), U1.P$37 (3V3_EN)
!SPI0_CS: JP4.1, U1.7 (GP5), U1.P$7 (GP5)
!SPI1_CS: JP3.1, U1.17 (GP13), U1.P$17 (GP13)
+5V: JP1.1, Q1.3 (D)
+6V: IC1.8 (+IN), JP1.2, R1.1, SJ3.1
ADC2: IC1.5 (OUT), JP7.1, U1.34 (GP28), U1.P$34 (GP28)
AGND: C1.1, IC1.2 (GND), IC1.3 (REF2), IC1.7 (REF1), JP7.2, JP7.4, JP7.5, JP7.6, U1.33 (AGND), U1.P$33 (AGND)
AREF: U1.35 (ADC_REF), U1.P$35 (ADC_REF)
ENC_L_A: U1.21 (GP16), U1.P$21 (GP16), X2.P$3
ENC_L_B: U1.22 (GP17), U1.P$22 (GP17), X2.P$2
ENC_R_A: U1.24 (GP18), U1.P$24 (GP18), X1.P$3
ENC_R_B: U1.25 (GP19), U1.P$25 (GP19), X1.P$2
GND: JP1.8, JP2.2, JP3.6, U1.3 (GND), U1.8 (GND), U1.13 (GND), U1.18 (GND), U1.23 (GND), U1.28 (GND), U1.38 (GND), U1.P$3 (GND), U1.P$8 (GND), U1.P$13 (GND), U1.P$18 (GND), U1.P$23 (GND), U1.P$28 (GND), U1.P$38 (GND), U2.LGND, U2.MGND, X1.P$1, X2.P$1
GPIO22: JP3.5, U1.29 (GP22), U1.P$29 (GP22)
I2C0_SCL: JP5.2, U1.27 (GP21), U1.P$27 (GP21)
I2C0_SDA: JP5.1, U1.26 (GP20), U1.P$26 (GP20)
I2C1_SCL: JP5.3, U1.32 (GP27), U1.P$32 (GP27)
I2C1_SDA: JP5.4, U1.31 (GP26), U1.P$31 (GP26)
MOT_L_DIR: U1.10 (GP7), U1.P$10 (GP7), U2.APHASE
MOT_L_PWM: U1.9 (GP6), U1.P$9 (GP6), U2.AENBL
MOT_R_DIR: U1.20 (GP15), U1.P$20 (GP15), U2.BPHASE
MOT_R_PWM: U1.19 (GP14), U1.P$19 (GP14), U2.BENBL
M_IN: IC1.1 (-IN), R1.2, SJ3.2, U2.VIN
unnamed: SJ1.2, U2.MODE
unnamed: U2.BOUT1, X1.P$5
unnamed: U2.BOUT2, X1.P$6
unnamed: U2.AOUT1, X2.P$5
unnamed: U2.AOUT2, X2.P$6
RUN: JP1.7, JP2.1, U1.30 (RUN), U1.P$30 (RUN)
SPI0_RX: JP4.2, U1.6 (GP4), U1.P$6 (GP4)
SPI0_SCK: JP4.4, U1.4 (GP2), U1.P$4 (GP2)
SPI0_TX: JP4.3, U1.5 (GP3), U1.P$5 (GP3)
SPI1_RX: JP3.2, U1.16 (GP12), U1.P$16 (GP12)
SPI1_SCK: JP3.4, U1.14 (GP10), U1.P$14 (GP10)
SPI1_TX: JP3.3, U1.15 (GP11), U1.P$15 (GP11)
UART0_RX: JP1.4, U1.2 (GP1), U1.P$2 (GP1)
UART0_TX: JP1.3, U1.1 (GP0), U1.P$1 (GP0)
UART1_RX: JP1.6, U1.12 (GP9), U1.P$12 (GP9)
UART1_TX: JP1.5, U1.11 (GP8), U1.P$11 (GP8)
V_BUS: Q1.1 (G), U1.40 (VBUS), U1.P$40 (VBUS)
V_SYS: Q1.2 (S), U1.39 (VSYS), U1.P$39 (VSYS)

Notes on the sheet:
Rev. 0.5
Timo Sandmann, CC BY-SA 4.0
ct-Bot v2 Motorcontroller

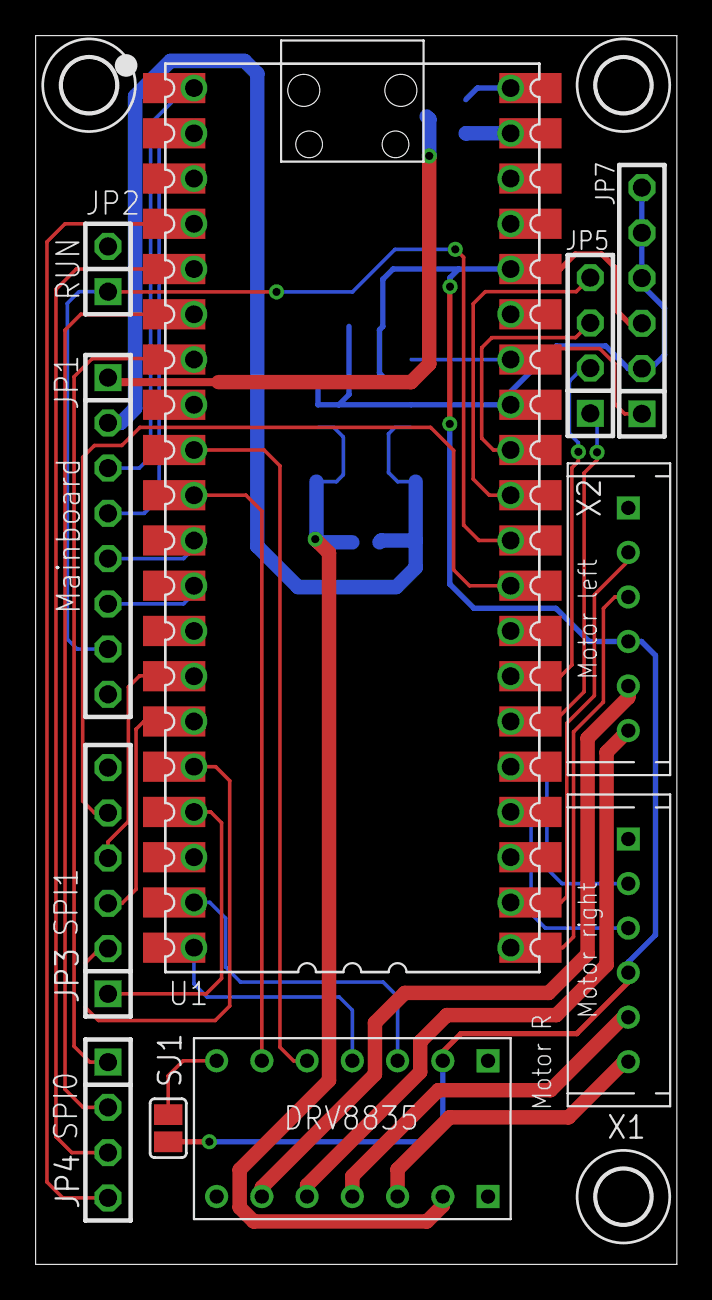
[picture p50: board motorctrl.brd from above]

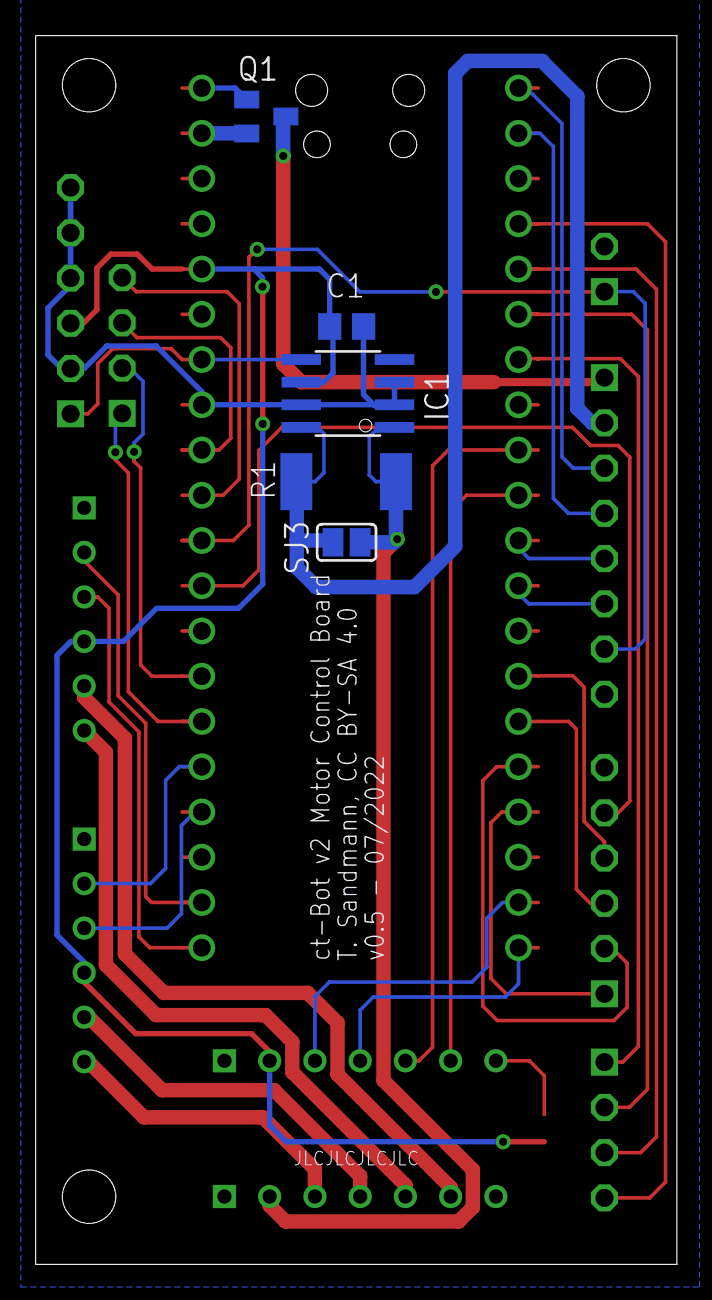
[picture p51: board motorctrl.brd from below]

Board: 2 copper layers, 36.0 x 69.0 mm, 19 parts (5 on the bottom side), 42 nets.

Other parts of the board:
H1, H2, H3: MOUNT-HOLE3.0; 3,0
