tsandmann/ct-bot-hw/v2/boards/sensors_f.brd

## EAGLE design v2/boards/sensors_f.brd (2023-01-07)

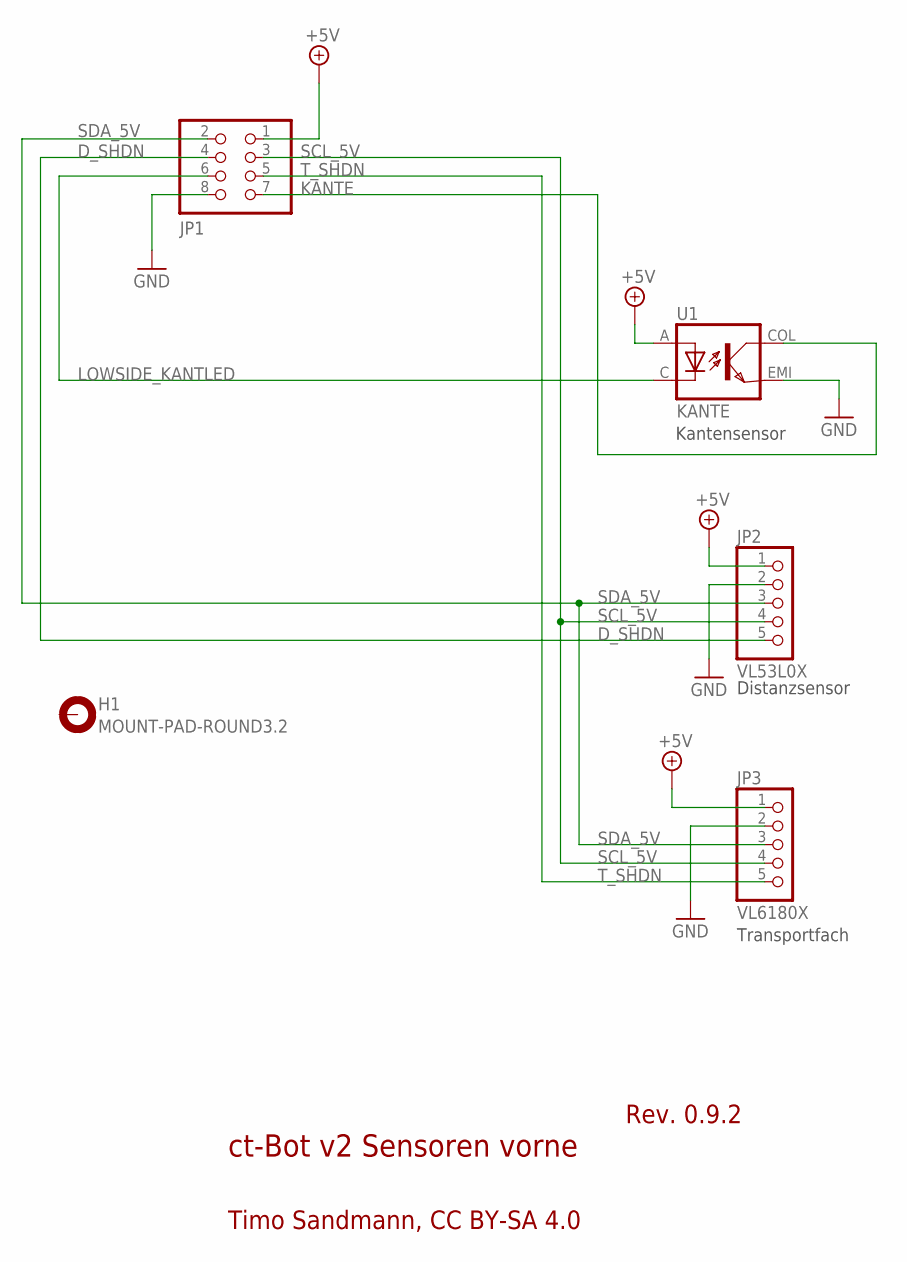
[picture p52: schematic sensors_f.sch]

Parts:
H1: MOUNT-PAD-ROUND3.2; 3,2-PAD
JP1: PINHD-2X4; 2X04
JP2: VL53L0X; 1X05
JP3: VL6180X; 1X05
U1: KANTE; EDGE

Connections:
+5V: JP1.1, JP2.1, JP3.1, U1.A
D_SHDN: JP1.4, JP2.5
GND: JP1.8, JP2.2, JP3.2, U1.EMI
KANTE: JP1.7, U1.COL
LOWSIDE_KANTLED: JP1.6, U1.C
SCL_5V: JP1.3, JP2.4, JP3.4
SDA_5V: JP1.2, JP2.3, JP3.3
T_SHDN: JP1.5, JP3.5

Notes on the sheet:
ct-Bot v2 Sensoren vorne
Rev. 0.9.2
Timo Sandmann, CC BY-SA 4.0
Kantensensor
Distanzsensor
Transportfach

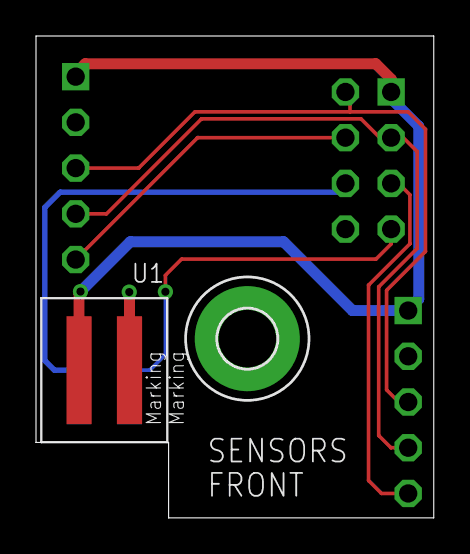
[picture p53: board sensors_f.brd from above]

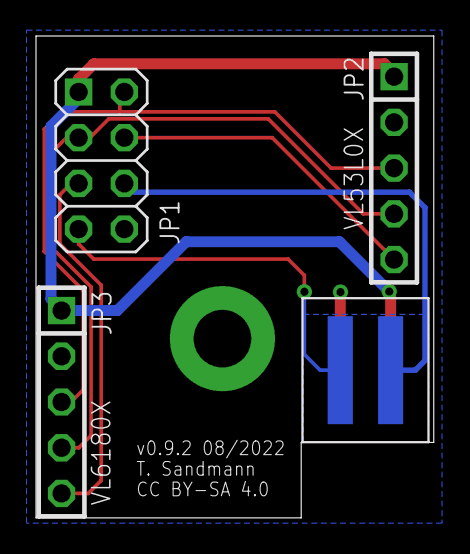
[picture p54: board sensors_f.brd from below]

Board: 2 copper layers, 22.1 x 26.8 mm, 5 parts (3 on the bottom side), 8 nets.
