tsandmann/ct-bot-hw/v2/boards/sensors_b.brd

## EAGLE design v2/boards/sensors_b.brd (2019-12-22)

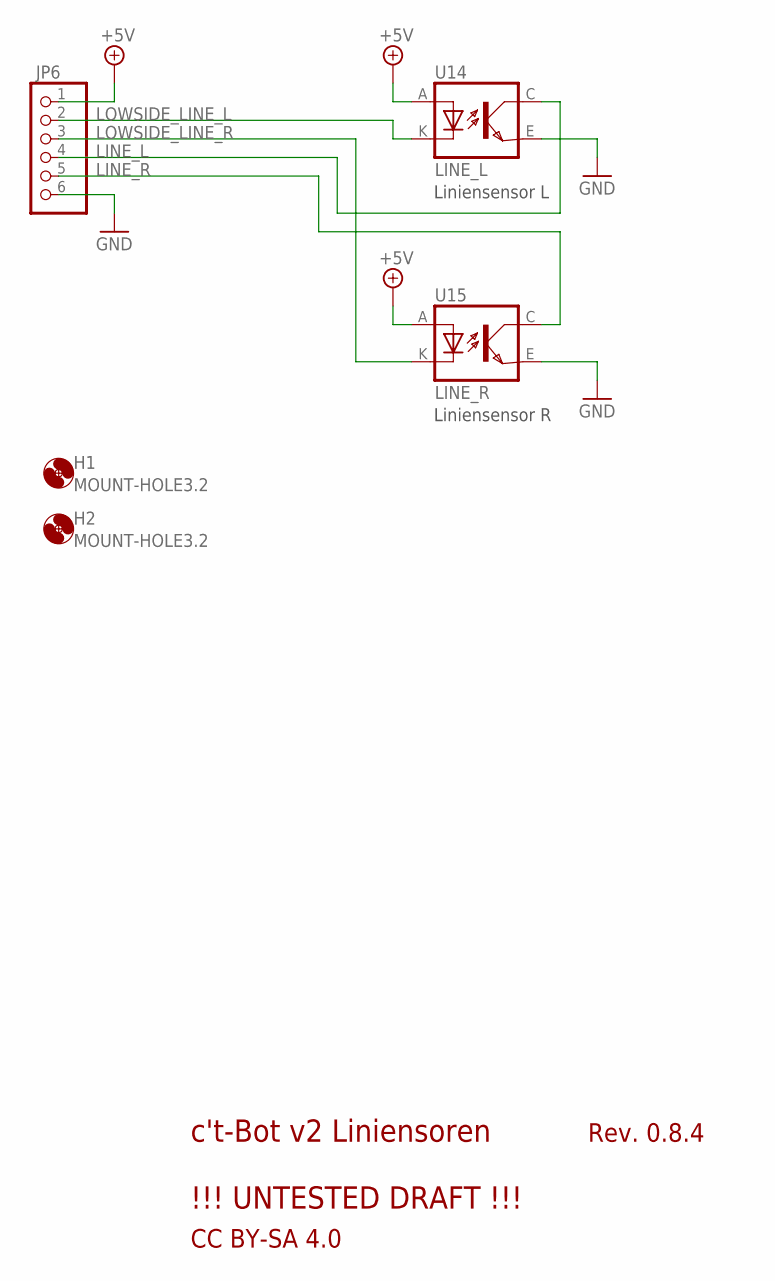
[picture p55: schematic sensors_b.sch]

Parts:
H1, H2: MOUNT-HOLE3.2; 3,2
JP6: PINHD-1X6; 1X06
U14: LINE_L; 4
U15: LINE_R; 4

Connections:
+5V: JP6.1, U14.A, U15.A
GND: JP6.6, U14.E (EMI), U15.E (EMI)
LINE_L: JP6.4, U14.C (COL)
LINE_R: JP6.5, U15.C (COL)
LOWSIDE_LINE_L: JP6.2, U14.K (C)
LOWSIDE_LINE_R: JP6.3, U15.K (C)

Notes on the sheet:
c't-Bot v2 Liniensoren !!! UNTESTED DRAFT !!!
Rev. 0.8.4
CC BY-SA 4.0
Liniensensor L
Liniensensor R

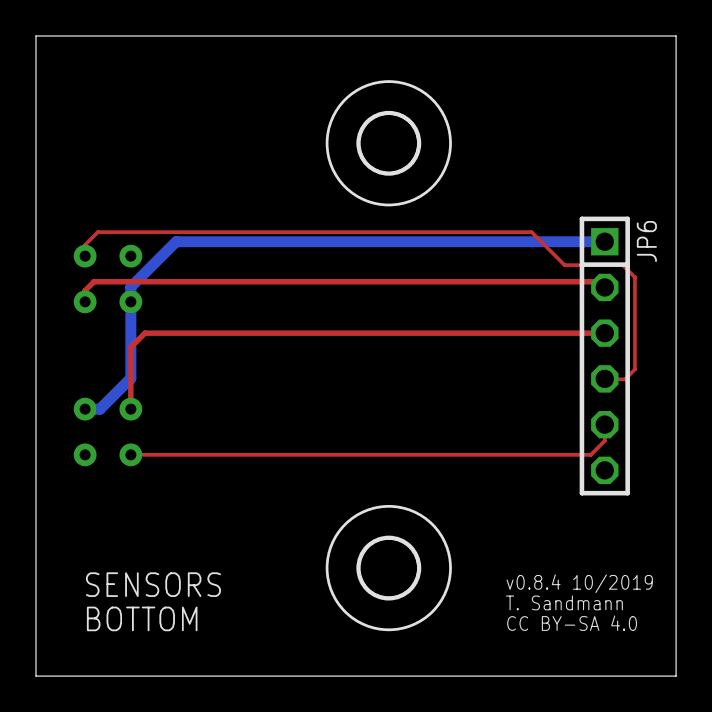
[picture p56: board sensors_b.brd from above]

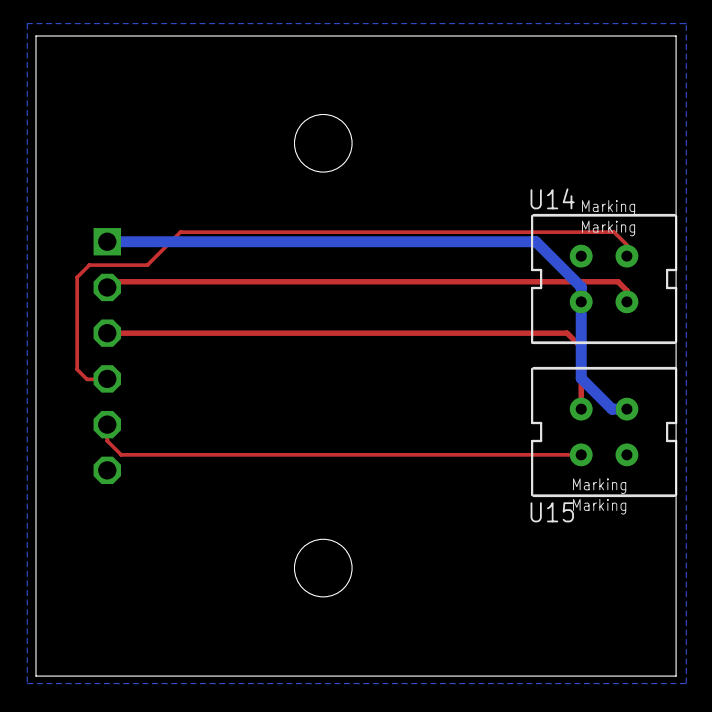
[picture p57: board sensors_b.brd from below]

Board: 2 copper layers, 35.6 x 35.6 mm, 5 parts (2 on the bottom side), 6 nets.
