tsandmann/ct-bot-hw/v2/boards/mcu_teensy.brd

## EAGLE design v2/boards/mcu_teensy.brd (2019-12-22)

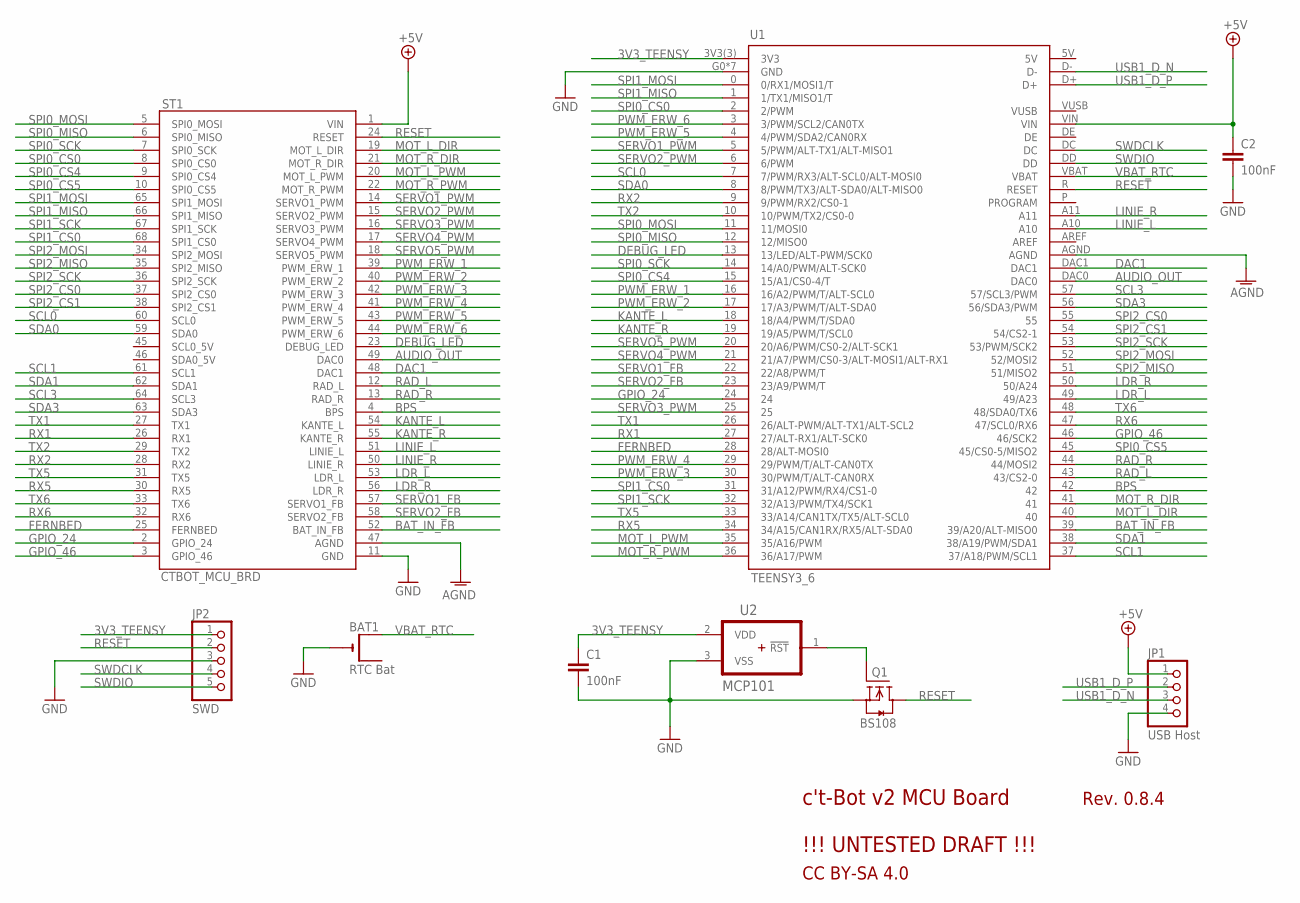
[picture p58: schematic mcu_teensy.sch]

Parts:
BAT1: RTC Bat; CR1220-SMD
C1, C2: 100nF; C025-025X050
JP1: USB Host; 1X04/90
JP2: SWD; 1X05/90
Q1: BS108; SOT54E
ST1: CTBOT_MCU_BRD; DIP66
U1: TEENSY3_6; T36
U2: MCP101; TO-92

Connections:
3V3_TEENSY: C1.1, JP2.1, U1.3V3(3) (3V3), U2.2 (VDD)
+5V: C2.1, JP1.1, ST1.1 (VIN), U1.VIN
AGND: ST1.47 (AGND), U1.AGND
AUDIO_OUT: ST1.49 (DAC0), U1.DAC0
BAT_IN_FB: ST1.52 (BAT_IN_FB), U1.39 (39/A20/ALT-MISO0)
BPS: ST1.4 (BPS), U1.42
DAC1: ST1.48 (DAC1), U1.DAC1
DEBUG_LED: ST1.23 (DEBUG_LED), U1.13 (13/LED/ALT-PWM/SCK0)
FERNBED: ST1.25 (FERNBED), U1.28 (28/ALT-MOSI0)
GND: BAT1.-, C1.2, C2.2, JP1.4, JP2.3, Q1.S, ST1.11 (GND), U1.G0 (GND), U1.G1 (GND), U1.G2 (GND), U1.G3 (GND), U1.G4 (GND), U1.G5 (GND), U1.G6 (GND), U2.3 (VSS)
GPIO_24: ST1.2 (GPIO_24), U1.24
GPIO_46: ST1.3 (GPIO_46), U1.46 (46/SCK2)
KANTE_L: ST1.54 (KANTE_L), U1.18 (18/A4/PWM/T/SDA0)
KANTE_R: ST1.55 (KANTE_R), U1.19 (19/A5/PWM/T/SCL0)
LDR_L: ST1.53 (LDR_L), U1.49 (49/A23)
LDR_R: ST1.56 (LDR_R), U1.50 (50/A24)
LINIE_L: ST1.51 (LINIE_L), U1.A10
LINIE_R: ST1.50 (LINIE_R), U1.A11
MOT_L_DIR: ST1.19 (MOT_L_DIR), U1.40
MOT_L_PWM: ST1.20 (MOT_L_PWM), U1.35 (35/A16/PWM)
MOT_R_DIR: ST1.21 (MOT_R_DIR), U1.41
MOT_R_PWM: ST1.22 (MOT_R_PWM), U1.36 (36/A17/PWM)
unnamed: Q1.G, U2.1 (!RST)
PWM_ERW_1: ST1.39 (PWM_ERW_1), U1.16 (16/A2/PWM/T/ALT-SCL0)
PWM_ERW_2: ST1.40 (PWM_ERW_2), U1.17 (17/A3/PWM/T/ALT-SDA0)
PWM_ERW_3: ST1.42 (PWM_ERW_3), U1.30 (30/PWM/T/ALT-CAN0RX)
PWM_ERW_4: ST1.41 (PWM_ERW_4), U1.29 (29/PWM/T/ALT-CAN0TX)
PWM_ERW_5: ST1.43 (PWM_ERW_5), U1.4 (4/PWM/SDA2/CAN0RX)
PWM_ERW_6: ST1.44 (PWM_ERW_6), U1.3 (3/PWM/SCL2/CAN0TX)
RAD_L: ST1.12 (RAD_L), U1.43 (43/CS2-0)
RAD_R: ST1.13 (RAD_R), U1.44 (44/MOSI2)
RESET: JP2.2, Q1.D, ST1.24 (RESET), U1.R (RESET)
RX1: ST1.26 (RX1), U1.27 (27/ALT-RX1/ALT-SCK0)
RX2: ST1.28 (RX2), U1.9 (9/PWM/RX2/CS0-1)
RX5: ST1.30 (RX5), U1.34 (34/A15/CAN1RX/RX5/ALT-SDA0)
RX6: ST1.32 (RX6), U1.47 (47/SCL0/RX6)
SCL0: ST1.60 (SCL0), U1.7 (7/PWM/RX3/ALT-SCL0/ALT-MOSI0)
SCL1: ST1.61 (SCL1), U1.37 (37/A18/PWM/SCL1)
SCL3: ST1.64 (SCL3), U1.57 (57/SCL3/PWM)
SDA0: ST1.59 (SDA0), U1.8 (8/PWM/TX3/ALT-SDA0/ALT-MISO0)
SDA1: ST1.62 (SDA1), U1.38 (38/A19/PWM/SDA1)
SDA3: ST1.63 (SDA3), U1.56 (56/SDA3/PWM)
SERVO1_FB: ST1.57 (SERVO1_FB), U1.22 (22/A8/PWM/T)
SERVO1_PWM: ST1.14 (SERVO1_PWM), U1.5 (5/PWM/ALT-TX1/ALT-MISO1)
SERVO2_FB: ST1.58 (SERVO2_FB), U1.23 (23/A9/PWM/T)
SERVO2_PWM: ST1.15 (SERVO2_PWM), U1.6 (6/PWM)
SERVO3_PWM: ST1.16 (SERVO3_PWM), U1.25
SERVO4_PWM: ST1.17 (SERVO4_PWM), U1.21 (21/A7/PWM/CS0-3/ALT-MOSI1/ALT-RX1)
SERVO5_PWM: ST1.18 (SERVO5_PWM), U1.20 (20/A6/PWM/CS0-2/ALT-SCK1)
SPI0_CS0: ST1.8 (SPI0_CS0), U1.2 (2/PWM)
SPI0_CS4: ST1.9 (SPI0_CS4), U1.15 (15/A1/CS0-4/T)
SPI0_CS5: ST1.10 (SPI0_CS5), U1.45 (45/CS0-5/MISO2)
SPI0_MISO: ST1.6 (SPI0_MISO), U1.12 (12/MISO0)
SPI0_MOSI: ST1.5 (SPI0_MOSI), U1.11 (11/MOSI0)
SPI0_SCK: ST1.7 (SPI0_SCK), U1.14 (14/A0/PWM/ALT-SCK0)
SPI1_CS0: ST1.68 (SPI1_CS0), U1.31 (31/A12/PWM/RX4/CS1-0)
SPI1_MISO: ST1.66 (SPI1_MISO), U1.1 (1/TX1/MISO1/T)
SPI1_MOSI: ST1.65 (SPI1_MOSI), U1.0 (0/RX1/MOSI1/T)
SPI1_SCK: ST1.67 (SPI1_SCK), U1.32 (32/A13/PWM/TX4/SCK1)
SPI2_CS0: ST1.37 (SPI2_CS0), U1.55
SPI2_CS1: ST1.38 (SPI2_CS1), U1.54 (54/CS2-1)
SPI2_MISO: ST1.35 (SPI2_MISO), U1.51 (51/MISO2)
SPI2_MOSI: ST1.34 (SPI2_MOSI), U1.52 (52/MOSI2)
SPI2_SCK: ST1.36 (SPI2_SCK), U1.53 (53/PWM/SCK2)
SWDCLK: JP2.4, U1.DC
SWDIO: JP2.5, U1.DD
TX1: ST1.27 (TX1), U1.26 (26/ALT-PWM/ALT-TX1/ALT-SCL2)
TX2: ST1.29 (TX2), U1.10 (10/PWM/TX2/CS0-0)
TX5: ST1.31 (TX5), U1.33 (33/A14/CAN1TX/TX5/ALT-SCL0)
TX6: ST1.33 (TX6), U1.48 (48/SDA0/TX6)
USB1_D_N: JP1.3, U1.D-
USB1_D_P: JP1.2, U1.D+
VBAT_RTC: BAT1.+$1 (+), U1.VBAT

Notes on the sheet:
c't-Bot v2 MCU Board !!! UNTESTED DRAFT !!!
Rev. 0.8.4
CC BY-SA 4.0

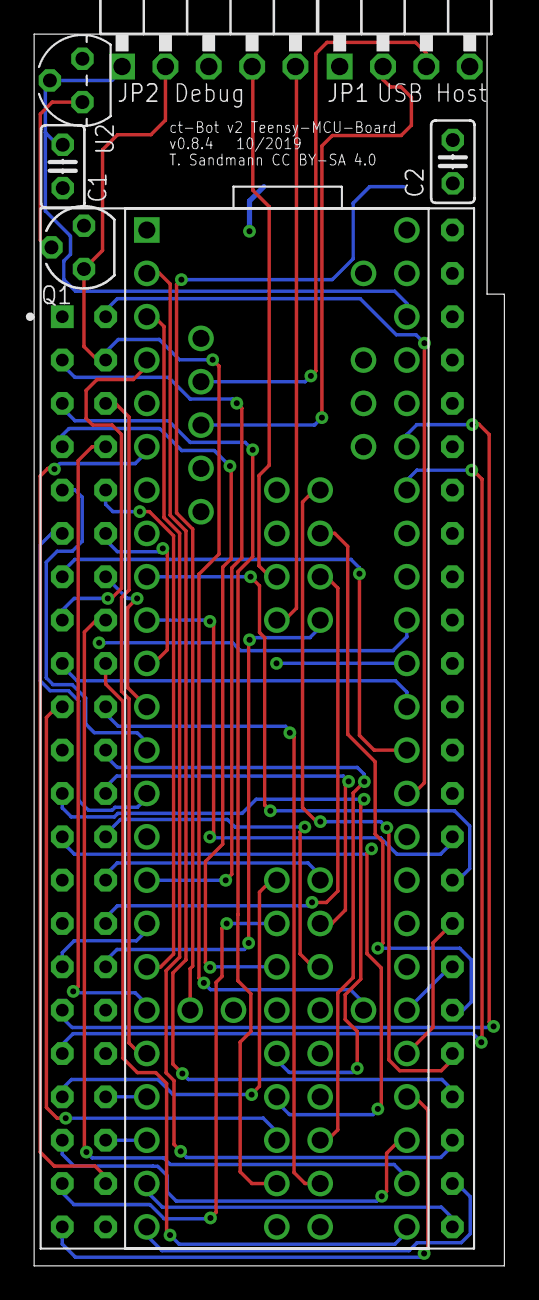
[picture p59: board mcu_teensy.brd from above]

Board: 4 copper layers, 27.6 x 72.2 mm, 9 parts (1 on the bottom side), 73 nets.
