tsandmann/ct-bot-hw/v2/adapter_boards/teensy_adapter_v2/teensy_adapter.brd

## EAGLE design v2/adapter_boards/teensy_adapter_v2/teensy_adapter.brd (2019-04-08)

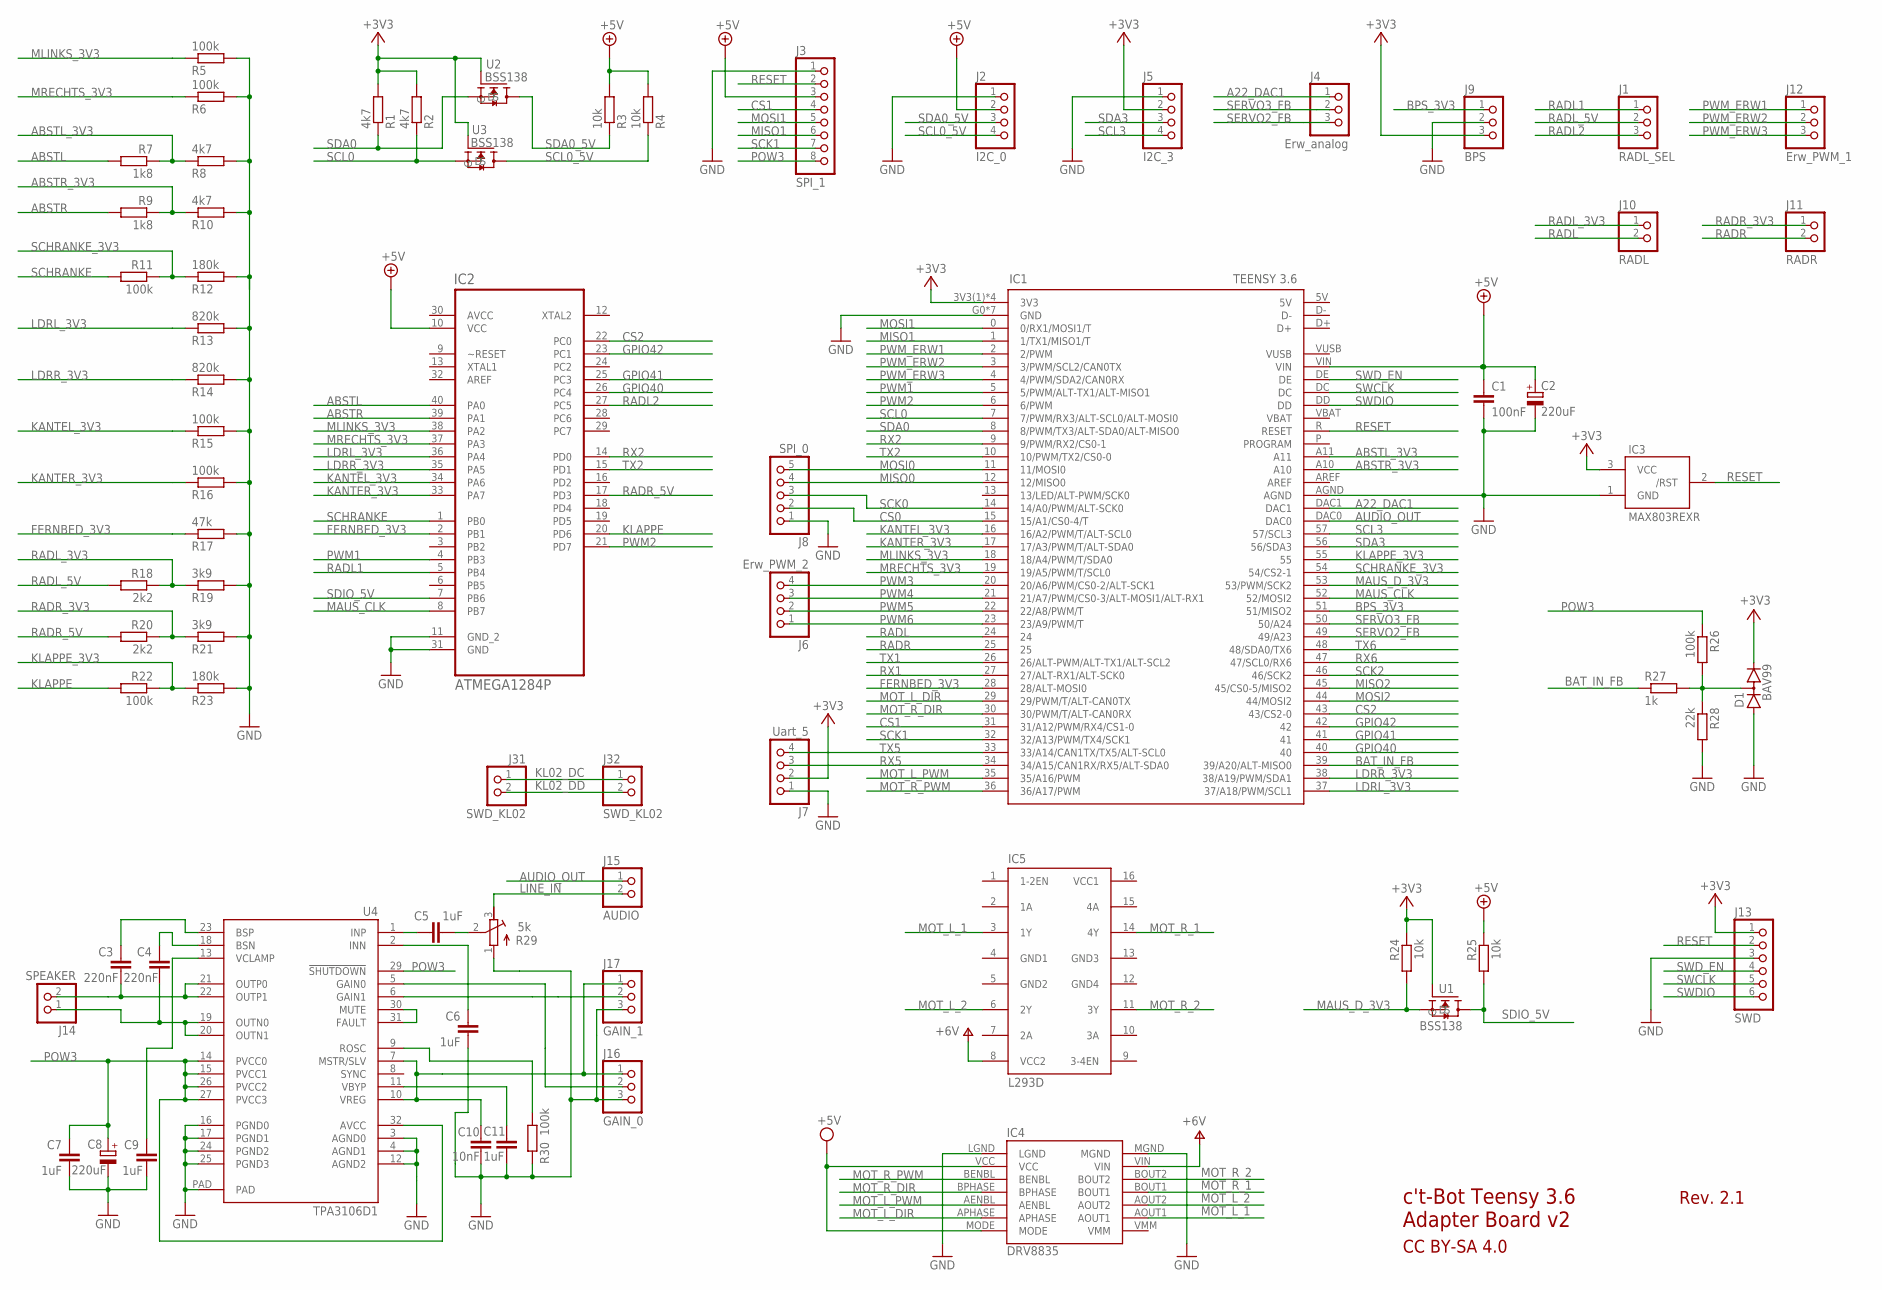
[picture p60: schematic teensy_adapter.sch]

Parts:
C1: 100nF; C025-025X050
C2, C8: 220uF; E2,5-6
C3, C4: 220nF; C025-025X050
C5, C6, C7, C9, C11: 1uF; C025-025X050
C10: 10nF; C025-025X050
D1: BAV99; SOT23
IC1: TEENSY 3.6; T36
IC2: ATMEGA1284P; DIP254P1524X483-40
IC3: MAX803REXR; SC70-3L
IC4: DRV8835; POLOLU_MOTOR_DRV_DRV8835
IC5: L293D; DIL16
J1: RADL_SEL; 1X03
J2: I2C_0; 1X04
J3: SPI_1; 1X08
J4: Erw_analog; 1X03
J5: I2C_3; 1X04
J6: Erw_PWM_2; 1X04
J7: Uart_5; 1X04
J8: SPI_0; 1X05
J9: BPS; 1X03
J10: RADL; 1X02
J11: RADR; 1X02
J12: Erw_PWM_1; 1X03
J13: SWD; 1X06
J14: SPEAKER; 1X02
J15: AUDIO; 1X02
J16: GAIN_0; 1X03
J17: GAIN_1; 1X03
J31: SWD_KL02; 1X02
J32: SWD_KL02; 1X02/90
R1, R2, R8, R10: 4k7; 0204V
R3, R4, R24, R25: 10k; 0204V
R5, R6, R11, R15, R16, R22, R26, R30: 100k; 0204V
R7, R9: 1k8; 0204V
R12, R23: 180k; 0204V
R13, R14: 820k; 0204V
R17: 47k; 0204V
R18, R20: 2k2; 0204V
R19, R21: 3k9; 0204V
R27: 1k; 0204V
R28: 22k; 0204V
R29: 5k; RTRIM64W
U1, U2, U3: BSS138
U4: TPA3106D1; HTQFP32

Connections:
+3V3: D1.2 (C), IC1.3V3(1) (3V3), IC1.3V3(2) (3V3), IC1.3V3(3) (3V3), IC1.3V3(4) (3V3), IC3.3 (VCC), J5.2, J7.2, J9.3, J13.1, R1.2, R2.2, R24.1, U1.G, U2.G, U3.G
+5V: C1.1, C2.+, IC1.VIN, IC2.10 (VCC), IC4.MODE, IC4.VCC, J2.2, J3.3, R3.2, R4.2, R25.1
+6V: IC4.VIN, IC5.8 (VCC2)
A22_DAC1: IC1.DAC1, J4.1
ABSTL: IC2.40 (PA0), R7.2
ABSTL_3V3: IC1.A11, R7.1, R8.1
ABSTR: IC2.39 (PA1), R9.2
ABSTR_3V3: IC1.A10, R9.1, R10.1
AUDIO_OUT: IC1.DAC0, J15.1
AVCC: IC2.30 (AVCC)
BAT_IN_FB: IC1.39 (39/A20/ALT-MISO0), R27.1
BPS_3V3: IC1.51 (51/MISO2), J9.1
BSN: C4.1, U4.18 (BSN)
BSP: C3.1, U4.23 (BSP)
CS0: IC1.15 (15/A1/CS0-4/T), J8.2
CS1: IC1.31 (31/A12/PWM/RX4/CS1-0), J3.4
CS2: IC1.43 (43/CS2-0), IC2.22 (PC0)
FERNBED_3V3: IC1.28 (28/ALT-MOSI0), IC2.2 (PB1), R17.1
GAIN0: J16.2, U4.5 (GAIN0)
GAIN1: J17.2, U4.6 (GAIN1)
GND: C1.2, C2.-, C6.2, C7.2, C8.-, C9.2, C10.2, C11.2, D1.1 (A), IC1.AGND, IC1.G0 (GND), IC1.G1 (GND), IC1.G2 (GND), IC1.G3 (GND), IC1.G4 (GND), IC1.G5 (GND), IC1.G6 (GND), IC2.11 (GND_2), IC2.31 (GND), IC3.1 (GND), IC4.LGND, IC4.MGND, J2.1, J3.1, J5.1, J7.1, J8.1, J9.2, J13.3, J16.3, J17.3, R5.2, R6.2, R8.2, R10.2, R12.2, R13.2, R14.2, R15.2, R16.2, R17.2, R19.2, R21.2, R23.2, R28.2, R29.1 (E), R30.1, U4.3 (AGND0), U4.4 (AGND1), U4.12 (AGND2), U4.16 (PGND0), U4.17 (PGND1), U4.24 (PGND2), U4.25 (PGND3), U4.PAD
GND1: IC5.4 (GND1)
GND2: IC5.5 (GND2)
GND3: IC5.13 (GND3)
GND4: IC5.12 (GND4)
GPIO40: IC1.40, IC2.26 (PC4)
GPIO41: IC1.41, IC2.25 (PC3)
GPIO42: IC1.42, IC2.23 (PC1)
INN: C6.1, U4.2 (INN)
INP: C5.1, U4.1 (INP)
KANTEL_3V3: IC1.16 (16/A2/PWM/T/ALT-SCL0), IC2.34 (PA6), R15.1
KANTER_3V3: IC1.17 (17/A3/PWM/T/ALT-SDA0), IC2.33 (PA7), R16.1
KL02_DC: J31.1, J32.1
KL02_DD: J31.2, J32.2
KLAPPE: IC2.20 (PD6), R22.2
KLAPPE_3V3: IC1.55, R22.1, R23.1
LDRL_3V3: IC1.37 (37/A18/PWM/SCL1), IC2.36 (PA4), R13.1
LDRR_3V3: IC1.38 (38/A19/PWM/SDA1), IC2.35 (PA5), R14.1
LINE_IN: J15.2, R29.3 (A)
MAUS_CLK: IC1.52 (52/MOSI2), IC2.8 (PB7)
MAUS_D_3V3: IC1.53 (53/PWM/SCK2), R24.2, U1.S
MISO0: IC1.12 (12/MISO0), J8.4
MISO1: IC1.1 (1/TX1/MISO1/T), J3.6
MISO2: IC1.45 (45/CS0-5/MISO2)
MLINKS_3V3: IC1.18 (18/A4/PWM/T/SDA0), IC2.38 (PA2), R5.1
MOSI0: IC1.11 (11/MOSI0), J8.5
MOSI1: IC1.0 (0/RX1/MOSI1/T), J3.5
MOSI2: IC1.44 (44/MOSI2)
MOT_L_1: IC4.AOUT1, IC5.3 (1Y)
MOT_L_2: IC4.AOUT2, IC5.6 (2Y)
MOT_L_DIR: IC1.29 (29/PWM/T/ALT-CAN0TX), IC4.APHASE
MOT_L_PWM: IC1.35 (35/A16/PWM), IC4.AENBL
MOT_R_1: IC4.BOUT1, IC5.14 (4Y)
MOT_R_2: IC4.BOUT2, IC5.11 (3Y)
MOT_R_DIR: IC1.30 (30/PWM/T/ALT-CAN0RX), IC4.BPHASE
MOT_R_PWM: IC1.36 (36/A17/PWM), IC4.BENBL
MRECHTS_3V3: IC1.19 (19/A5/PWM/T/SCL0), IC2.37 (PA3), R6.1
unnamed: D1.3 (AC), R26.2, R27.2, R28.1
unnamed: U4.30 (MUTE), U4.31 (FAULT)
unnamed: C5.2, R29.2 (S)
OUTN: C4.2, J14.1, U4.19 (OUTN0), U4.20 (OUTN1)
OUTP: C3.2, J14.2, U4.21 (OUTP0), U4.22 (OUTP1)
POW3: C7.1, C8.+, J3.8, R26.1, U4.14 (PVCC0), U4.15 (PVCC1), U4.26 (PVCC2), U4.27 (PVCC3), U4.29 (!SHUTDOWN), U4.32 (AVCC)
PWM1: IC1.5 (5/PWM/ALT-TX1/ALT-MISO1), IC2.4 (PB3)
PWM2: IC1.6 (6/PWM), IC2.21 (PD7)
PWM3: IC1.20 (20/A6/PWM/CS0-2/ALT-SCK1), J6.4
PWM4: IC1.21 (21/A7/PWM/CS0-3/ALT-MOSI1/ALT-RX1), J6.3
PWM5: IC1.22 (22/A8/PWM/T), J6.2
PWM6: IC1.23 (23/A9/PWM/T), J6.1
PWM_ERW1: IC1.2 (2/PWM), J12.1
PWM_ERW2: IC1.3 (3/PWM/SCL2/CAN0TX), J12.2
PWM_ERW3: IC1.4 (4/PWM/SDA2/CAN0RX), J12.3
RADL: IC1.24, J10.2
RADL1: IC2.5 (PB4), J1.1
RADL2: IC2.27 (PC5), J1.3
RADL_3V3: J10.1, R18.1, R19.1
RADL_5V: J1.2, R18.2
RADR: IC1.25, J11.2
RADR_3V3: J11.1, R20.1, R21.1
RADR_5V: IC2.17 (PD3), R20.2
RESET: IC1.R (RESET), IC3.2 (/RST), J3.2, J13.2
ROSC: R30.2, U4.9 (ROSC)
RX1: IC1.27 (27/ALT-RX1/ALT-SCK0)
RX2: IC1.9 (9/PWM/RX2/CS0-1), IC2.14 (PD0)
RX5: IC1.34 (34/A15/CAN1RX/RX5/ALT-SDA0), J7.3
RX6: IC1.47 (47/SCL0/RX6)
SCHRANKE: IC2.1 (PB0), R11.2
SCHRANKE_3V3: IC1.54 (54/CS2-1), R11.1, R12.1
SCK0: IC1.14 (14/A0/PWM/ALT-SCK0), J8.3
SCK1: IC1.32 (32/A13/PWM/TX4/SCK1), J3.7
SCK2: IC1.46 (46/SCK2)
SCL0: IC1.7 (7/PWM/RX3/ALT-SCL0/ALT-MOSI0), R2.1, U3.S
SCL0_5V: J2.4, R4.1, U3.D
SCL3: IC1.57 (57/SCL3), J5.4
SDA0: IC1.8 (8/PWM/TX3/ALT-SDA0/ALT-MISO0), R1.1, U2.S
SDA0_5V: J2.3, R3.1, U2.D
SDA3: IC1.56 (56/SDA3), J5.3
SDIO_5V: IC2.7 (PB6), R25.2, U1.D
SERVO2_FB: IC1.49 (49/A23), J4.3
SERVO3_FB: IC1.50 (50/A24), J4.2
SWCLK: IC1.DC, J13.5
SWDIO: IC1.DD, J13.6
SWD_EN: IC1.DE, J13.4
TX1: IC1.26 (26/ALT-PWM/ALT-TX1/ALT-SCL2)
TX2: IC1.10 (10/PWM/TX2/CS0-0), IC2.15 (PD1)
TX5: IC1.33 (33/A14/CAN1TX/TX5/ALT-SCL0), J7.4
TX6: IC1.48 (48/SDA0/TX6)
VBYP: C11.1, U4.11 (VBYP)
VCC1: IC5.16 (VCC1)
VCLAMP: C9.1, U4.13 (VCLAMP)
VREG: C10.1, J16.1, J17.1, U4.7 (MSTR/SLV), U4.10 (VREG)

Notes on the sheet:
c't-Bot Teensy 3.6 Adapter Board v2
Rev. 2.1
CC BY-SA 4.0

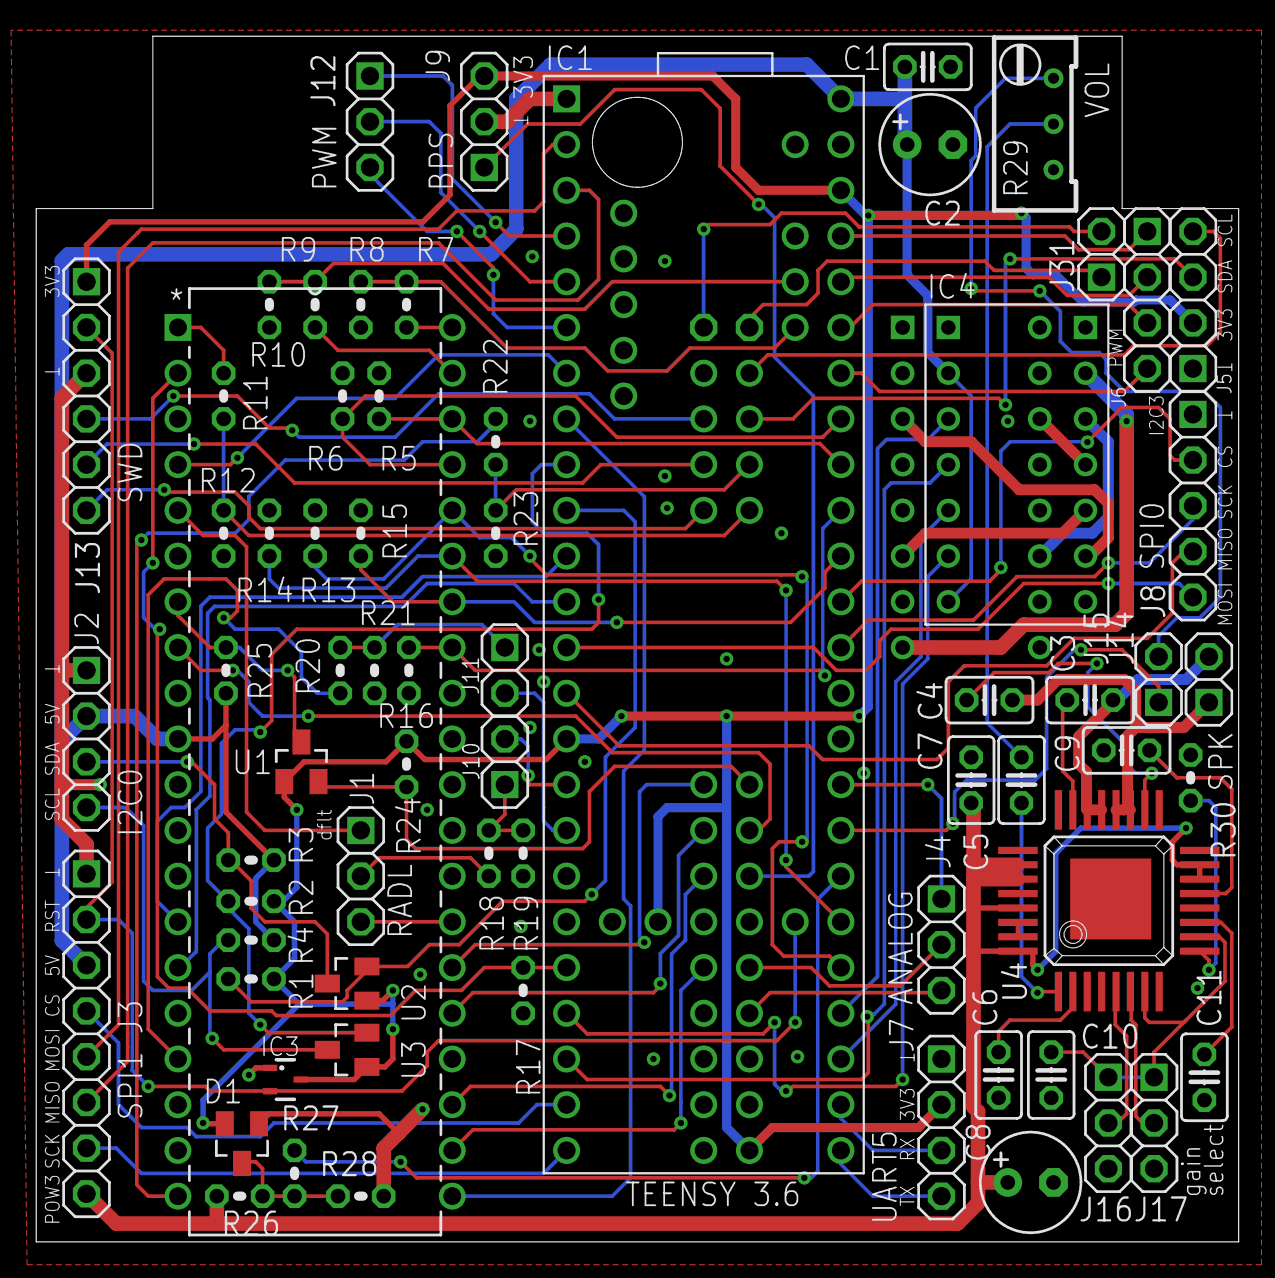
[picture p61: board v2/adapter_boards/teensy_adapter_v2/teensy_adapter.brd from above]

Board: 2 copper layers, 66.8 x 67.0 mm, 70 parts (1 on the bottom side), 98 nets.
