tsandmann/ct-bot-hw/v2/adapter_boards/teensy_adapter_v1/teensy_adapter.brd

## EAGLE design v2/adapter_boards/teensy_adapter_v1/teensy_adapter.brd (2018-07-25, an earlier design)

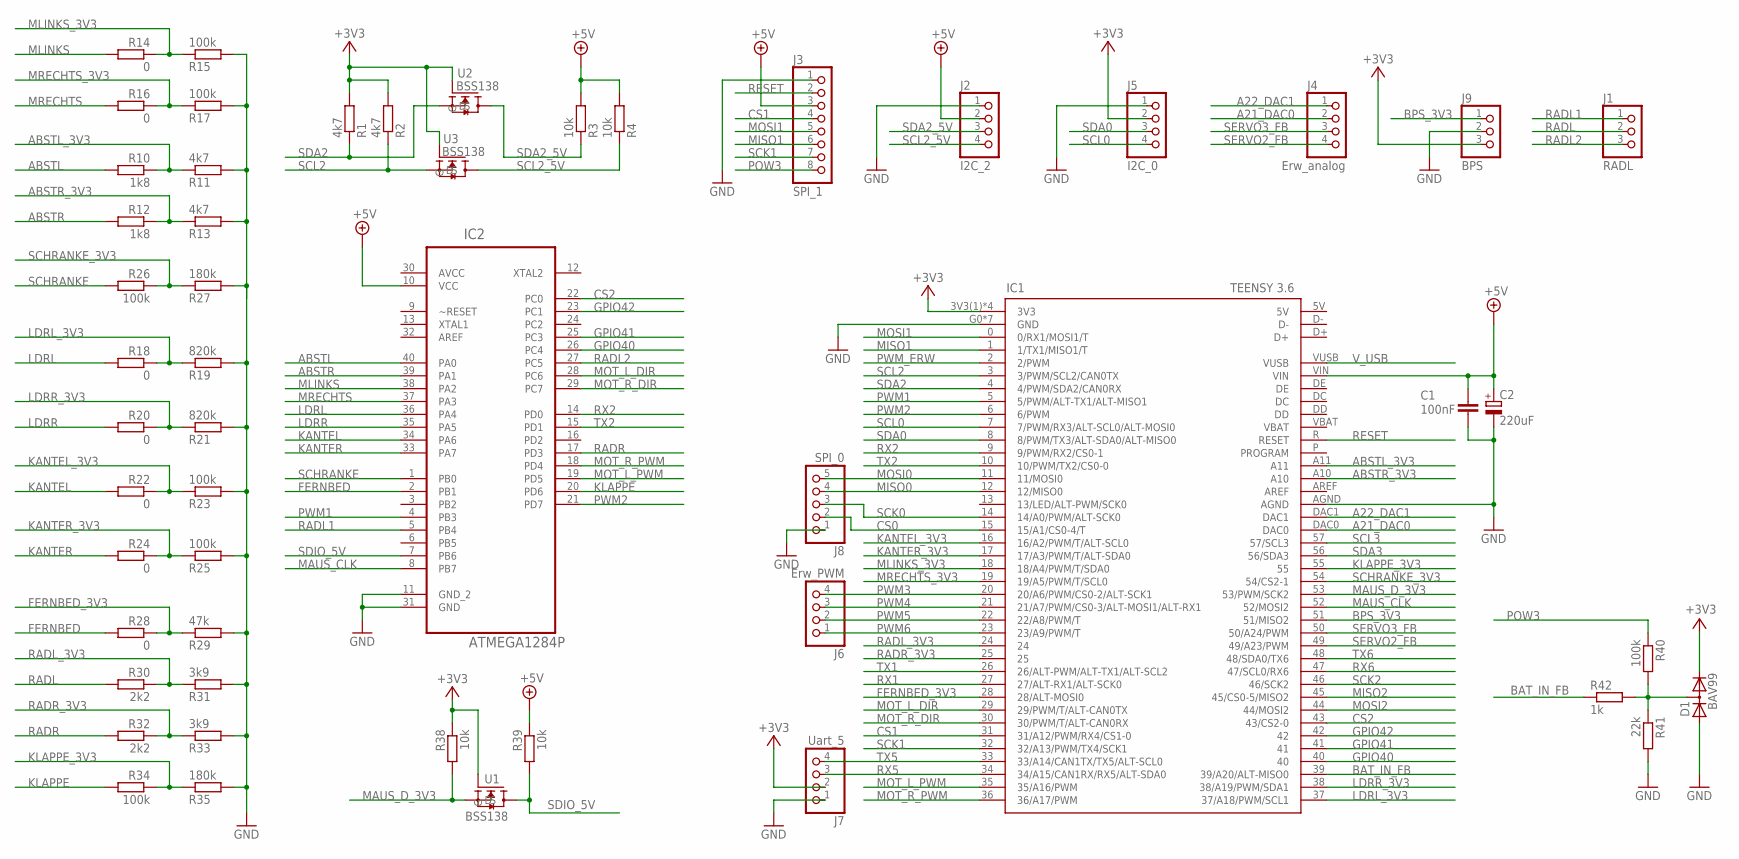
[picture p62: schematic teensy_adapter.sch]

Parts:
C1: 100nF; C025-025X050
C2: 220uF; E2,5-6
D1: BAV99; SOT23
IC1: TEENSY 3.6; T36
IC2: ATMEGA1284P; DIP254P1524X483-40
J1: RADL; 1X03
J2: I2C_2; 1X04
J3: SPI_1; 1X08
J4: Erw_analog; 1X04
J5: I2C_0; 1X04
J6: Erw_PWM; 1X04
J7: Uart_5; 1X04
J8: SPI_0; 1X05
J9: BPS; 1X03
R1, R2, R11, R13: 4k7; 0204V
R3, R4, R38, R39: 10k; 0204V
R10, R12: 1k8; 0204V
R14, R16, R18, R20, R22, R24, R28: 0; 0204V
R15, R17, R23, R25, R26, R34, R40: 100k; 0204V
R19, R21: 820k; 0204V
R27, R35: 180k; 0204V
R29: 47k; 0204V
R30, R32: 2k2; 0204V
R31, R33: 3k9; 0204V
R41: 22k; 0204V
R42: 1k; 0204V
U1, U2, U3: BSS138

Connections:
+3V3: D1.2 (C), IC1.3V3(1) (3V3), IC1.3V3(2) (3V3), IC1.3V3(3) (3V3), IC1.3V3(4) (3V3), J5.2, J7.2, J9.3, R1.2, R2.2, R38.1, U1.G, U2.G, U3.G
+5V: C1.1, C2.+, IC1.VIN, IC2.10 (VCC), J2.2, J3.3, R3.2, R4.2, R39.1
A21_DAC0: IC1.DAC0, J4.2
A22_DAC1: IC1.DAC1, J4.1
ABSTL: IC2.40 (PA0), R10.2
ABSTL_3V3: IC1.A11, R10.1, R11.1
ABSTR: IC2.39 (PA1), R12.2
ABSTR_3V3: IC1.A10, R12.1, R13.1
AVCC: IC2.30 (AVCC)
BAT_IN_FB: IC1.39 (39/A20/ALT-MISO0), R42.1
BPS_3V3: IC1.51 (51/MISO2), J9.1
CS0: IC1.15 (15/A1/CS0-4/T), J8.2
CS1: IC1.31 (31/A12/PWM/RX4/CS1-0), J3.4
CS2: IC1.43 (43/CS2-0), IC2.22 (PC0)
FERNBED: IC2.2 (PB1), R28.2
FERNBED_3V3: IC1.28 (28/ALT-MOSI0), R28.1, R29.1
GND: C1.2, C2.-, D1.1 (A), IC1.AGND, IC1.G0 (GND), IC1.G1 (GND), IC1.G2 (GND), IC1.G3 (GND), IC1.G4 (GND), IC1.G5 (GND), IC1.G6 (GND), IC2.11 (GND_2), IC2.31 (GND), J2.1, J3.1, J5.1, J7.1, J8.1, J9.2, R11.2, R13.2, R15.2, R17.2, R19.2, R21.2, R23.2, R25.2, R27.2, R29.2, R31.2, R33.2, R35.2, R41.2
GPIO40: IC1.40, IC2.26 (PC4)
GPIO41: IC1.41, IC2.25 (PC3)
GPIO42: IC1.42, IC2.23 (PC1)
KANTEL: IC2.34 (PA6), R22.2
KANTEL_3V3: IC1.16 (16/A2/PWM/T/ALT-SCL0), R22.1, R23.1
KANTER: IC2.33 (PA7), R24.2
KANTER_3V3: IC1.17 (17/A3/PWM/T/ALT-SDA0), R24.1, R25.1
KLAPPE: IC2.20 (PD6), R34.2
KLAPPE_3V3: IC1.55, R34.1, R35.1
LDRL: IC2.36 (PA4), R18.2
LDRL_3V3: IC1.37 (37/A18/PWM/SCL1), R18.1, R19.1
LDRR: IC2.35 (PA5), R20.2
LDRR_3V3: IC1.38 (38/A19/PWM/SDA1), R20.1, R21.1
MAUS_CLK: IC1.52 (52/MOSI2), IC2.8 (PB7)
MAUS_D_3V3: IC1.53 (53/PWM/SCK2), R38.2, U1.S
MISO0: IC1.12 (12/MISO0), J8.4
MISO1: IC1.1 (1/TX1/MISO1/T), J3.6
MISO2: IC1.45 (45/CS0-5/MISO2)
MLINKS: IC2.38 (PA2), R14.2
MLINKS_3V3: IC1.18 (18/A4/PWM/T/SDA0), R14.1, R15.1
MOSI0: IC1.11 (11/MOSI0), J8.5
MOSI1: IC1.0 (0/RX1/MOSI1/T), J3.5
MOSI2: IC1.44 (44/MOSI2)
MOT_L_DIR: IC1.29 (29/PWM/T/ALT-CAN0TX), IC2.28 (PC6)
MOT_L_PWM: IC1.35 (35/A16/PWM), IC2.19 (PD5)
MOT_R_DIR: IC1.30 (30/PWM/T/ALT-CAN0RX), IC2.29 (PC7)
MOT_R_PWM: IC1.36 (36/A17/PWM), IC2.18 (PD4)
MRECHTS: IC2.37 (PA3), R16.2
MRECHTS_3V3: IC1.19 (19/A5/PWM/T/SCL0), R16.1, R17.1
unnamed: D1.3 (AC), R40.2, R41.1, R42.2
POW3: J3.8, R40.1
PWM1: IC1.5 (5/PWM/ALT-TX1/ALT-MISO1), IC2.4 (PB3)
PWM2: IC1.6 (6/PWM), IC2.21 (PD7)
PWM3: IC1.20 (20/A6/PWM/CS0-2/ALT-SCK1), J6.4
PWM4: IC1.21 (21/A7/PWM/CS0-3/ALT-MOSI1/ALT-RX1), J6.3
PWM5: IC1.22 (22/A8/PWM/T), J6.2
PWM6: IC1.23 (23/A9/PWM/T), J6.1
PWM_ERW: IC1.2 (2/PWM)
RADL: J1.2, R30.2
RADL1: IC2.5 (PB4), J1.1
RADL2: IC2.27 (PC5), J1.3
RADL_3V3: IC1.24, R30.1, R31.1
RADR: IC2.17 (PD3), R32.2
RADR_3V3: IC1.25, R32.1, R33.1
RESET: IC1.R (RESET), J3.2
RX1: IC1.27 (27/ALT-RX1/ALT-SCK0)
RX2: IC1.9 (9/PWM/RX2/CS0-1), IC2.14 (PD0)
RX5: IC1.34 (34/A15/CAN1RX/RX5/ALT-SDA0), J7.3
RX6: IC1.47 (47/SCL0/RX6)
SCHRANKE: IC2.1 (PB0), R26.2
SCHRANKE_3V3: IC1.54 (54/CS2-1), R26.1, R27.1
SCK0: IC1.14 (14/A0/PWM/ALT-SCK0), J8.3
SCK1: IC1.32 (32/A13/PWM/TX4/SCK1), J3.7
SCK2: IC1.46 (46/SCK2)
SCL0: IC1.7 (7/PWM/RX3/ALT-SCL0/ALT-MOSI0), J5.4
SCL2: IC1.3 (3/PWM/SCL2/CAN0TX), R2.1, U3.S
SCL2_5V: J2.4, R4.1, U3.D
SCL3: IC1.57 (57/SCL3)
SDA0: IC1.8 (8/PWM/TX3/ALT-SDA0/ALT-MISO0), J5.3
SDA2: IC1.4 (4/PWM/SDA2/CAN0RX), R1.1, U2.S
SDA2_5V: J2.3, R3.1, U2.D
SDA3: IC1.56 (56/SDA3)
SDIO_5V: IC2.7 (PB6), R39.2, U1.D
SERVO2_FB: IC1.49 (49/A23/PWM), J4.4
SERVO3_FB: IC1.50 (50/A24/PWM), J4.3
TX1: IC1.26 (26/ALT-PWM/ALT-TX1/ALT-SCL2)
TX2: IC1.10 (10/PWM/TX2/CS0-0), IC2.15 (PD1)
TX5: IC1.33 (33/A14/CAN1TX/TX5/ALT-SCL0), J7.4
TX6: IC1.48 (48/SDA0/TX6)
V_USB: IC1.VUSB

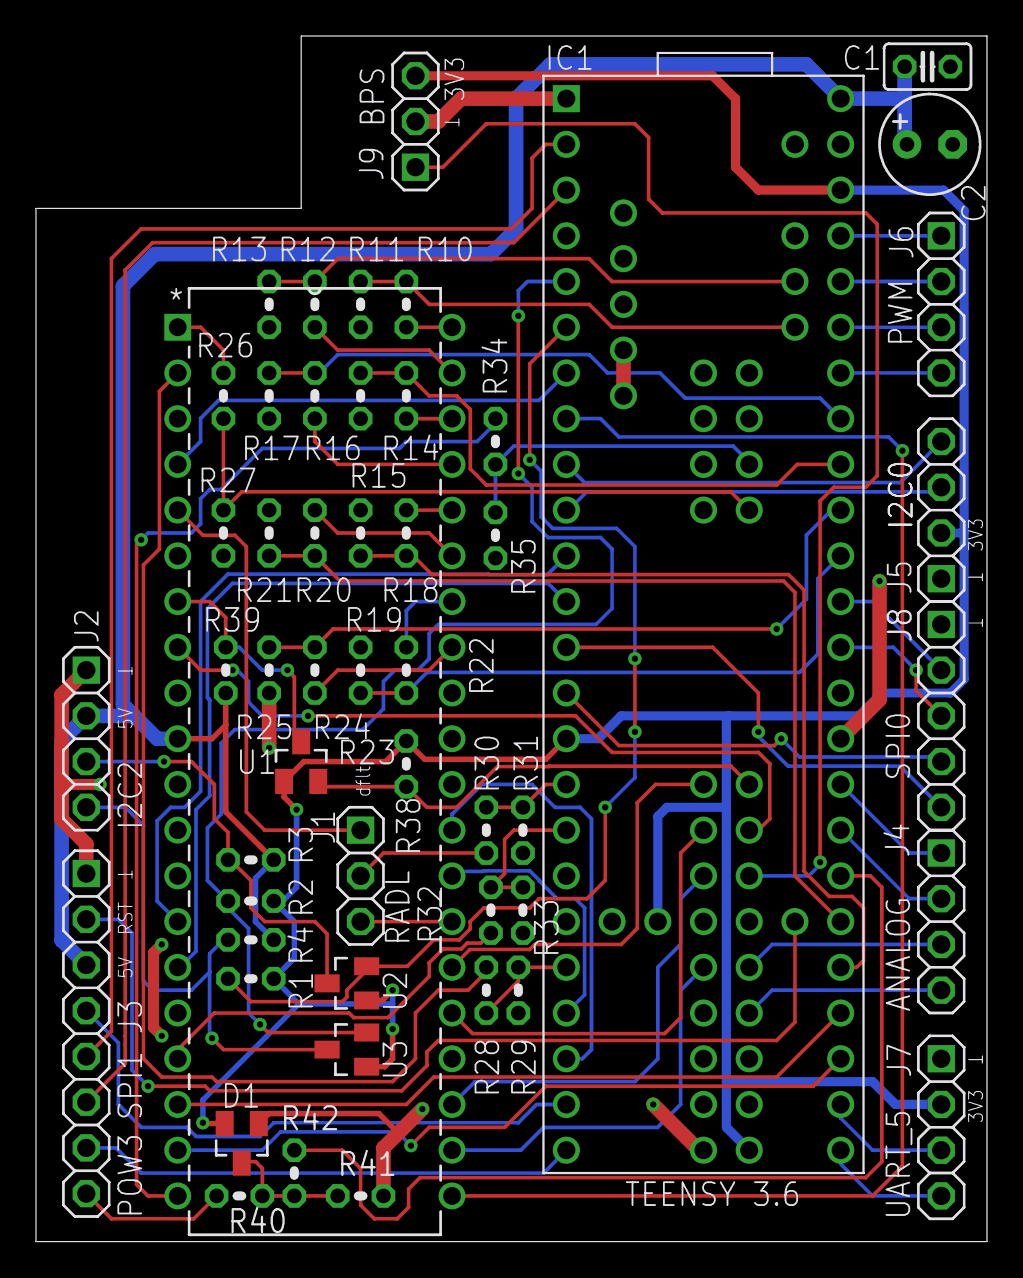
[picture p63: board v2/adapter_boards/teensy_adapter_v1/teensy_adapter.brd from above]

Board: 2 copper layers, 52.8 x 67.0 mm, 52 parts (0 on the bottom side), 75 nets.
