tsandmann/ct-bot-hw/(commit log)

2018-03-03 Initial commit of ct-Bot v2 schematic and pin mapping drafts
    [extensionboard.sch, mainboard.sch, teensy_3.6_pin_mapping.xlsx, teensy_pin_mapping_nw87.ods]
2018-03-03 baseplate dimensions and v1 schematics added
2018-03-04 Servo PWM pullups corrected, battery voltage divider adjusted
    schematic layout improved, signal names unified
    [extensionboard.sch, mainboard.sch, teensy_3.6_pin_mapping.xlsx]
2018-03-19 Added current datasheets for components used in schematics (Rev. 0.2).
2018-03-19 bugfix for i2c bus mapping on mainboard
    [mainboard.sch]
2018-03-20 Added datasheet for BNO055 sensor.
2018-03-21 Added datasheet for SG92R servo.
2018-03-22 Added datasheet for SG90 servo.
2018-03-24 schematics updated to rev 0.3
    [extensionboard.sch, mainboard.sch]
2018-03-26 mainboard: signal names updated
    [mainboard.sch]
2018-03-29 New folder structure for project.
    [extensionboard.sch, mainboard.sch, teensy_3.6_pin_mapping.xlsx, teensy_pin_mapping_nw87.ods]
2018-03-29 Added pcb-layouts and further schematics for ct-Bot (v1).
2018-03-29 teensy pin mapping as ods file added
    [teensy_3.6_pin_mapping.ods]
2018-04-03 two small adapter boards (just for development / testing) added: for motor driver and teensy
    [motor_driver_adapter.brd, motor_driver_adapter.sch, teensy_adapter.brd, teensy_adapter.sch]
2018-05-21 bugfixes for wrong voltage dividers
    [mainboard.sch, teensy_adapter.brd, teensy_adapter.sch]
2018-07-25 produced prototype version of adapter board
    [motor_driver_adapter.brd, teensy_adapter.brd]
2018-10-07 teensy adapter board updated to version 2 with…
    - bugfixes
    - reset controller
    - audio
    - swd debugger port
    [teensy_3.6_pin_mapping.xlsx, teensy_adapter.brd, teensy_adapter.sch]
2018-10-13 teensy adapter board v2 updated: bugfix silkscreen
    [teensy_adapter.brd, teensy_adapter.sch]
2018-10-17 teensy adapter v2: layout images after gerber processing
2019-01-13 cleanup of schematic, bugfix wheel encoder circuit
    [mainboard.sch]
2019-04-08 bugfix teensy adapter schematic: teensy pin 49/50 naming updated
    [teensy_adapter.brd, teensy_adapter.sch]
2019-04-26 teensy 3.6 pin mapping updated
    several corrections after some first tests
    [teensy_3.6_pin_mapping.xlsx]
2019-04-27 Update for ct-bot v2 design files
    - Moved some datasheets to correct place.
    - Fix for PJRC teensy schematic.
    - Updated pin mapping table for teensy board.
    - Removed PJRC teensy pinout cards (duplicate).
    [teensy_3.6_pin_mapping_nw87.ods, teensy_pin_mapping_nw87.ods]
2019-05-06 Moved in content from documentation repository.
    - Updated datasheets.
    - Added latest versions of original schematics.
    - Added original pcb-layouts (higher resolution).
    - Alligned naming of some files.
2019-05-13 Updated schematics to Revision 0.6.
    [extensionboard.sch, mainboard.sch]
2019-06-01 ct-bot v2 schematic updated
    - bugfix for library references, non-managed libraries added as dedicated library (ct-bot.lbr)
    - wrong footprints reverted
    - bufix for wrong signals for servo supplies
    - bugfix reverse polarity protection
    - bugifx for line sensor voltage levels
    - small smd parts exchanged with TH alternatives (bs108, mcp101) (untested)
    - distance and transport box sensors updated with I2C (untested)
    - led driver updated for up to 25 mA per channel (untested)
    - audio amp switched to pam8403 (untested)
    - bugfix for ESP12 programming mode (circuit still incomplete)
    - missing signals on RPi interface header restored
    - spi header for additional channels added due to pin map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
    [extensionboard.sch, mainboard.sch]
2019-06-01 folder structure updated for eagle design files, draft for mainboard layout added:
    - geometry based on ct-Bot dimensions
    - 1st layout for buck converters
    - very 1st draft of placement for other parts (incomplete)
    [extensionboard.sch, mainboard.brd, mainboard.sch, motor_driver_adapter.brd, motor_driver_adapter.sch, teensy_adapter.brd, teensy_adapter.sch]
2019-08-04 ct-bot v2 schematic updated
    - use of i2c sensors
    - adjustable luminosity for CNY70 sensors
    - ENA driver circuit updated for low-side switching
    - ESP32 for Wi-Fi, SWD, RC5 decoding
    [mainboard.brd, mainboard.sch, sensors.sch]
2019-08-05 PCA9672D (no longer manufactured) replaced with PCA9554D
    [mainboard.brd, mainboard.sch]
2019-08-07 resistor values for audio amp updated
    [mainboard.brd, mainboard.sch]
2019-08-11 ct-bot v2 schematic updated
    - optional current measurements added to mainboard
    - schematic drafts for sensor boards
    - pin mapping sheet updated (i2c-bus mapping)
    [mainboard.brd, mainboard.sch, sensors.sch, teensy_3.6_pin_mapping.xlsx]
2019-08-11 pin mapping sheet updated: fix for missing line
    [teensy_3.6_pin_mapping.xlsx]
2019-08-25 ct-bot v2 schematic updated according to todo list
    - analog ground
    [mainboard.brd, mainboard.sch]
2019-08-25 ct-bot v2 schematic updated according to todo list
    - missing lib added
2019-09-21 mainboard updated:
    - some bugfixes after further testing
    - discrete MCU board added
    [mainboard.sch, mcu_teensy.brd, mcu_teensy.sch, teensy_3.6_pin_mapping.xlsx]
2019-09-21 pin mapping table updated after further testing
    [teensy_3.6_pin_mapping.xlsx]
2019-09-29 ct-Bot v2 CAD files added for 3D printing
    [ct-bot_v2.scad]
2019-10-01 cad files: base plate updated
    [ct-bot_v2.scad]
2019-12-22 ct-Bot v2 prototype test boards updated/added
    Simplified mainboard, teensy mcu board, and sensor boards are very early prototypes just for development and testing.
    [ct-bot_v2.scad, mainboard_2l.brd, mainboard_2l.sch, mcu_teensy.brd, mcu_teensy.sch, sensors.sch, sensors_b.brd, sensors_b.sch]
2021-09-04 cad model updates
    [ct-bot_v2.scad, object.scad]
2021-09-04 cad updates for new motors
    [ct-bot_v2.scad, micro-metal-gearmotor-backshaft.stl, micro-metal-gearmotor-backshaft_fixed.stl, micro_metal_gearmotor_bracket_fixed.stl]
2022-06-25 folder structure cleanup, 3d model: base updated
    [ball-caster.stl, ct-bot_v2.scad, ct-bot_v2_base.stl, mainboard.brd, mcu_teensy3.6.brd, mcu_teensy3.6.sch, mcu_teensy4.1.brd, mcu_teensy4.1.sch]
2023-01-01 MCU schematic and pin-mappings added
    [teensy_4.1_pin_mapping.xlsx]
2023-01-01 CAD files updated for ct-Bot v2
    [bms345.stl, ct-bot_v2.scad, ct-bot_v2_base.stl, ct-bot_v2_poles.stl, ct-bot_v2_wheel.stl, motorctrl.stl]
2023-01-07 schematics and board files for ct-Bot v2 prototype
    [display_adapter.brd, display_adapter.sch, extensionboard.sch, mainboard.brd, mainboard.sch, mainboard_2l.brd, mainboard_2l.sch, mcu_teensy3.6.brd]
