tsandmann/ct-bot-hw/(notices)

Notices in the files:
v2/boards/motorctrl.brd:
T. Sandmann, CC BY-SA 4.0
v2/boards/mcu_teensy4.1.brd:
08/2022 T. Sandmann CC BY-SA 4.0
v2/boards/mainboard.sch:
c't-Bot Hauptplatine v2; CC BY-SA 4.0, Timo Sandmann
v2/boards/mcu_teensy.sch:
c't-Bot v2 MCU Board; CC BY-SA 4.0, Timo Sandmann
v2/adapter_boards/teensy_adapter_v2/teensy_adapter.brd:
CC BY-SA 11/2018
parts and their libraries:
SparkFun-Switches: Licensing: Creative Commons ShareAlike 4.0 International - https://creativecommons.org/licenses/by-sa/4.0
